LadyRoninEngineer/Si473x/Si4732THT/V2boardHiRes.jpg

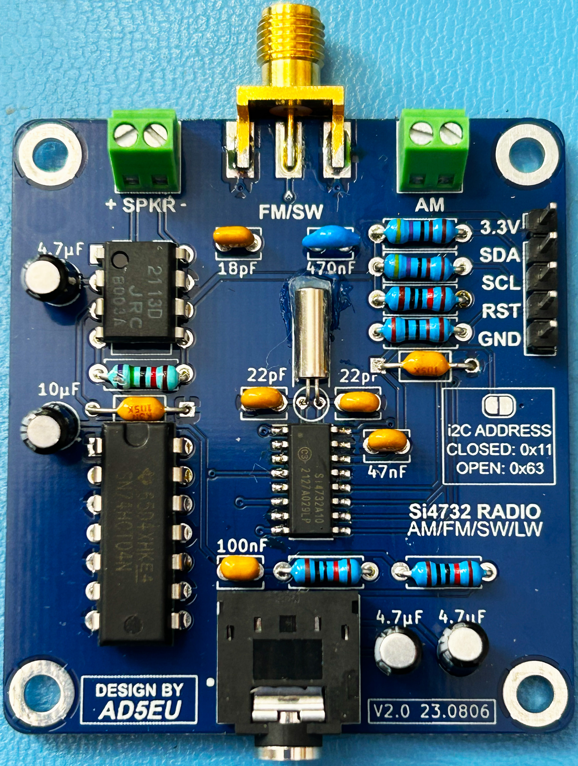
Si4732THT/V2boardHiRes.jpg
