LadyRoninEngineer/Si473x/FrontEnd/Documentation/21.0222_FrontEnd.jpg

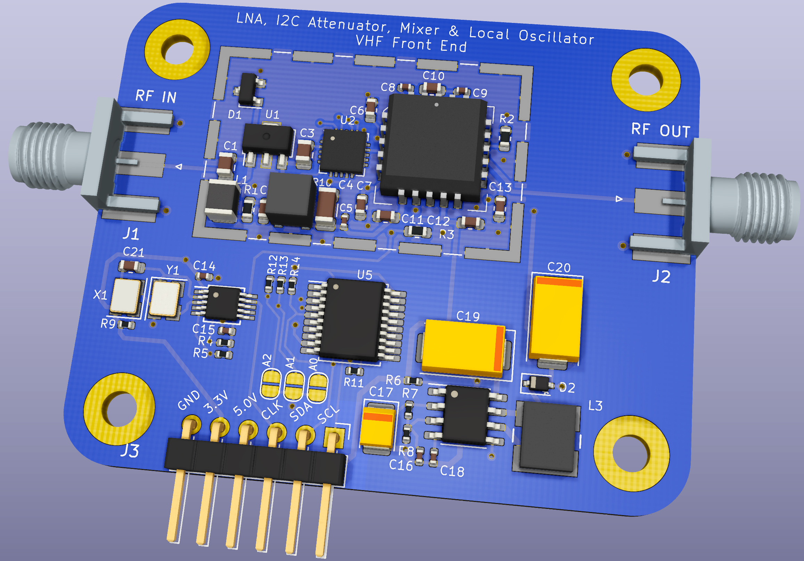
FrontEnd/Documentation/21.0222_FrontEnd.jpg
