LadyRoninEngineer/Si473x/README.md

# Si473x
Data Supporting development of Si473x series radios
