LadyRoninEngineer/Si473x/Si4732THT/README.md

Si4732 Through Hole Technology Radio
Developed By Nancy Gail Daniels - AD5EU
