LadyRoninEngineer/Si473x/FrontEnd/Documentation/21.0222_FrontEnd_S.jpg

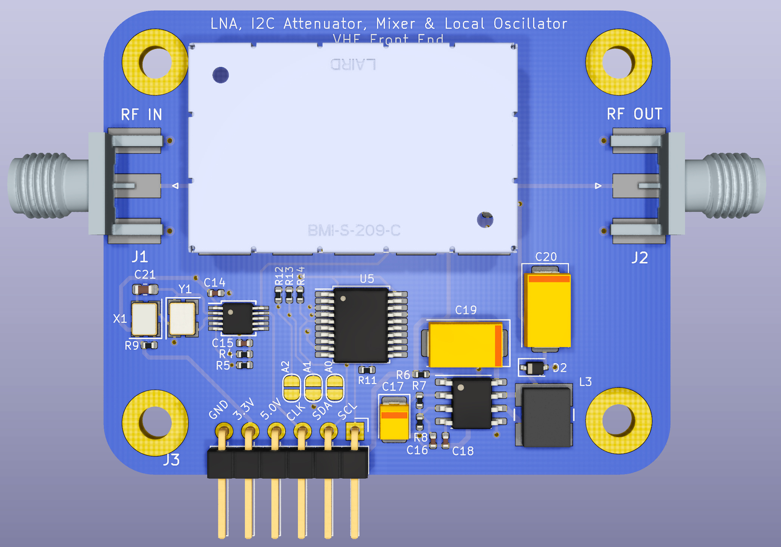
FrontEnd/Documentation/21.0222_FrontEnd_S.jpg
