LadyRoninEngineer/Si473x/FrontEnd/Documentation/21.0223_Image_BD.jpg

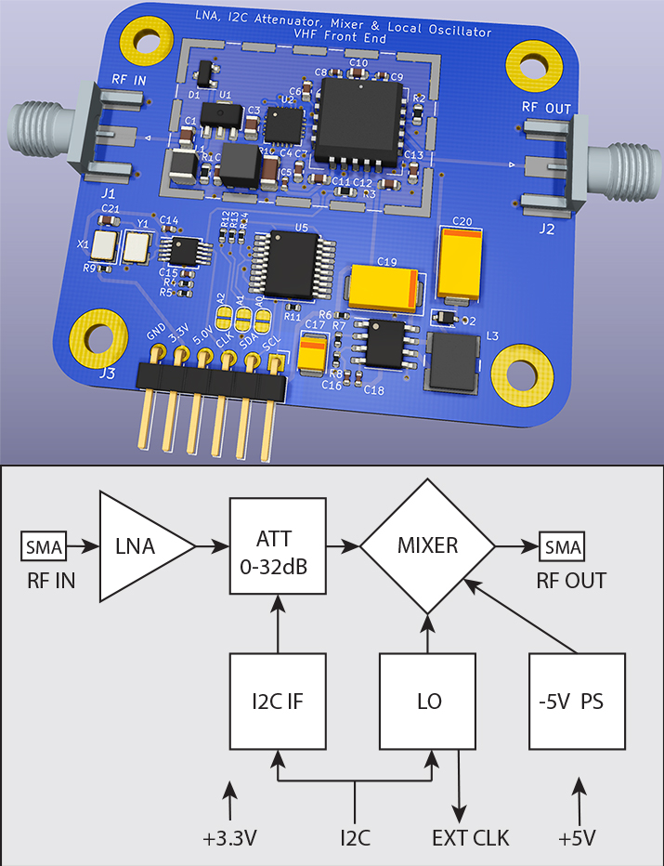
FrontEnd/Documentation/21.0223_Image_BD.jpg
