LadyRoninEngineer/Si473x/MBR_Processor/21.0611_MBP_3DModel.jpg

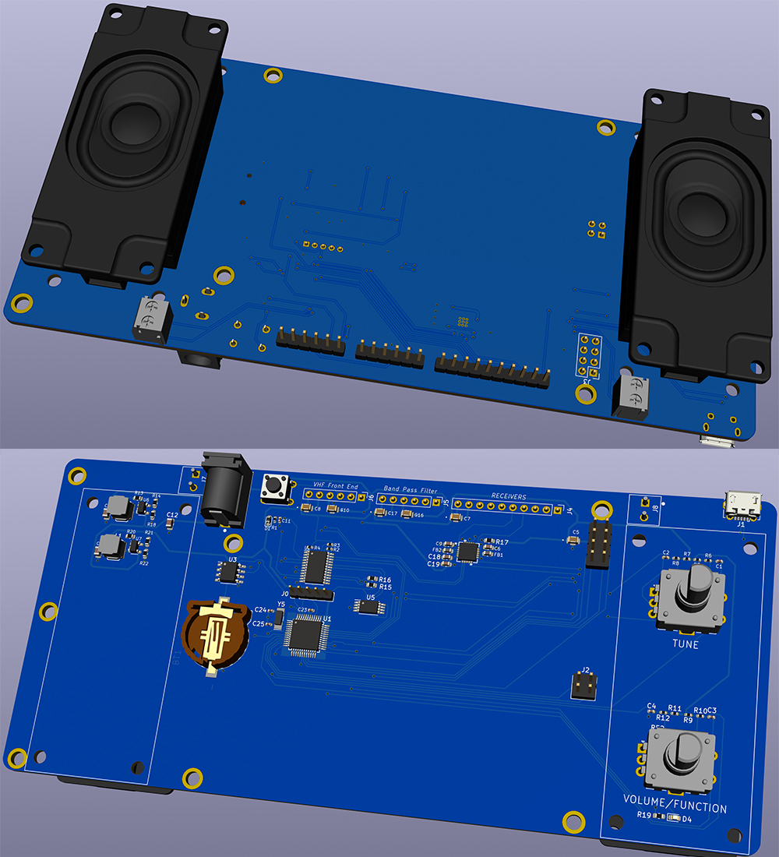
MBR_Processor/21.0611_MBP_3DModel.jpg
