LadyRoninEngineer/Si473x/FrontEnd/Custom Library/3D_MODELS/bmi-s-209-assembly-stp-file.STEP

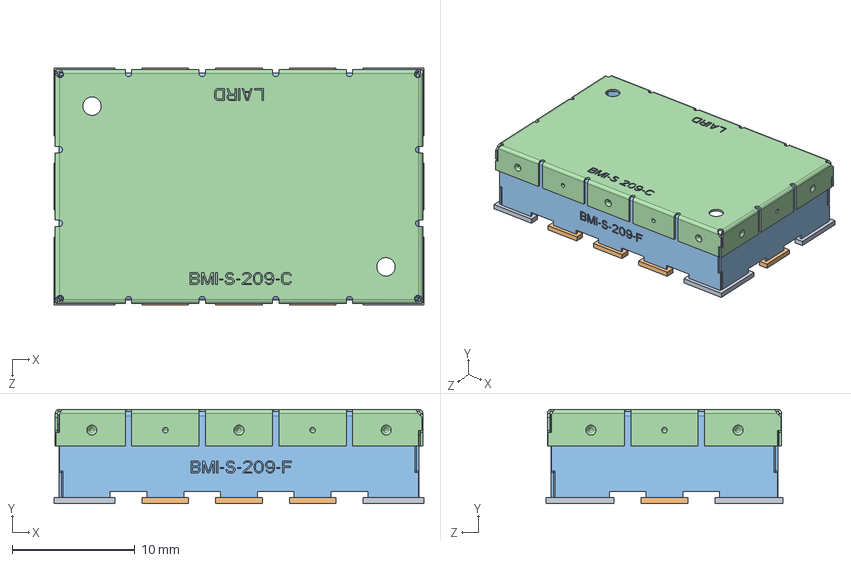
[picture p37: CAD file, 2021-02-23]
FrontEnd/Custom Library/3D_MODELS/bmi-s-209-assembly-stp-file.STEP
30.2 x 7.70 x 19.3 mm
bmi-s-209-footprint
bmi-s-209-f
bmi-s-209-c
