LadyRoninEngineer/Si473x/FrontEnd/Custom Library/AD831APZ/P_20A_ADI.step

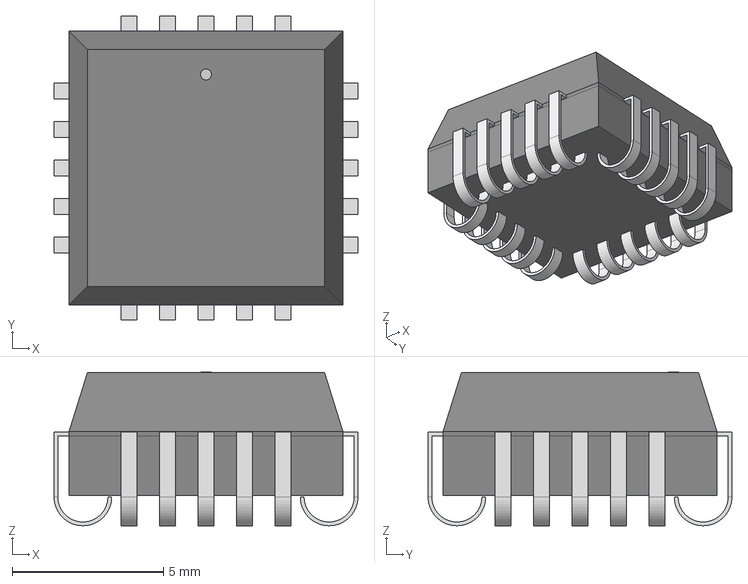
[picture p38: CAD file, 2021-02-23]
FrontEnd/Custom Library/AD831APZ/P_20A_ADI.step
10.0 x 10.0 x 5.07 mm
