LadyRoninEngineer/Si473x/FrontEnd/Custom Library/PE4312CZ/QFN20_4X4_PSM.step

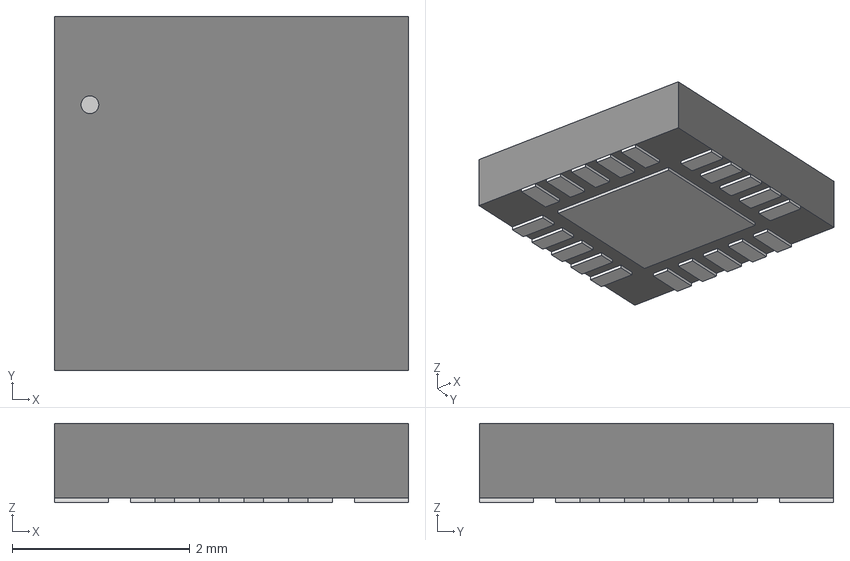
[picture p39: CAD file, 2021-02-23]
FrontEnd/Custom Library/PE4312CZ/QFN20_4X4_PSM.step
3.99 x 3.99 x 0.892 mm
