LadyRoninEngineer/Si473x/FrontEnd/Custom Library/TCCH-80/TCCH-80+.stp

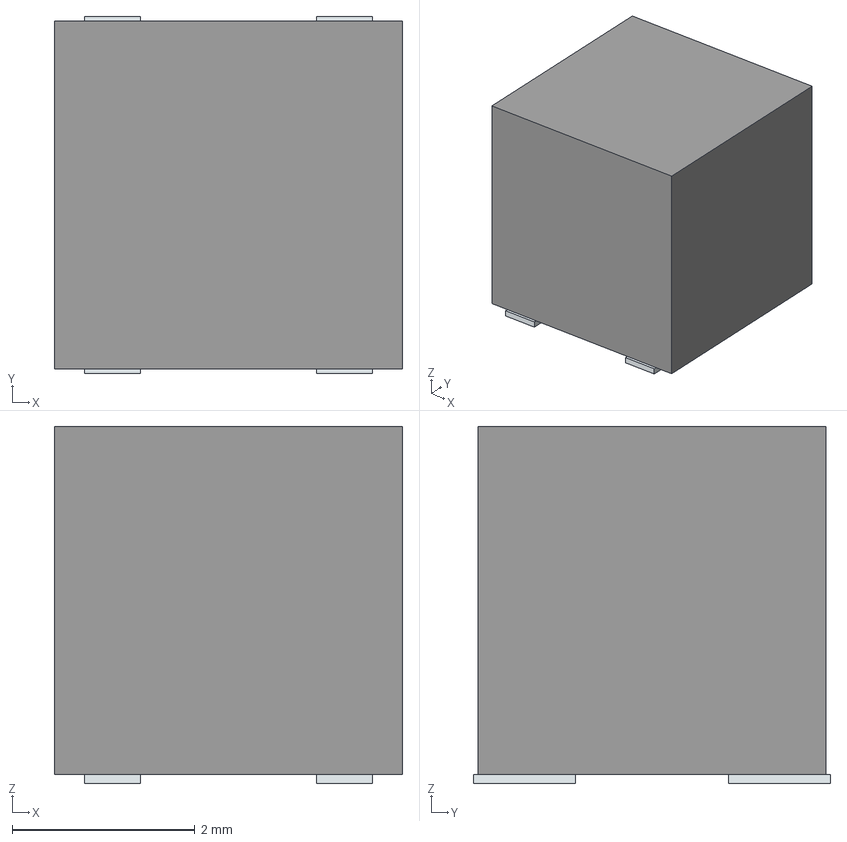
[picture p40: CAD file, 2021-02-23]
FrontEnd/Custom Library/TCCH-80/TCCH-80+.stp
3.81 x 3.91 x 3.91 mm
Pins
