LadyRoninEngineer/Si473x/FrontEnd/Custom Library/TPS6735IDR/TPS6735IDR.step

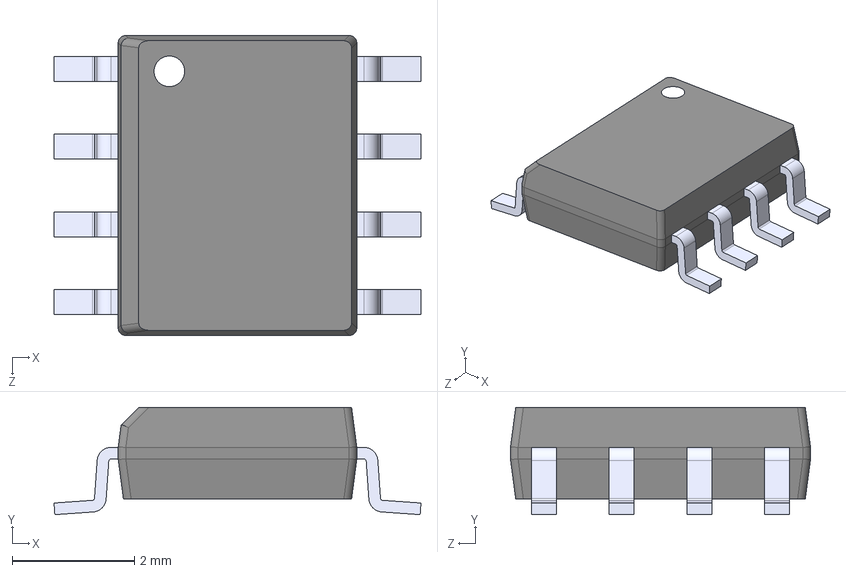
[picture p41: CAD file, 2021-02-23]
FrontEnd/Custom Library/TPS6735IDR/TPS6735IDR.step
5.99 x 1.75 x 4.90 mm
