LadyRoninEngineer/Si473x/FrontEnd/Custom Library/ul_TPS61080DRCTG4/DRC0010J.stp

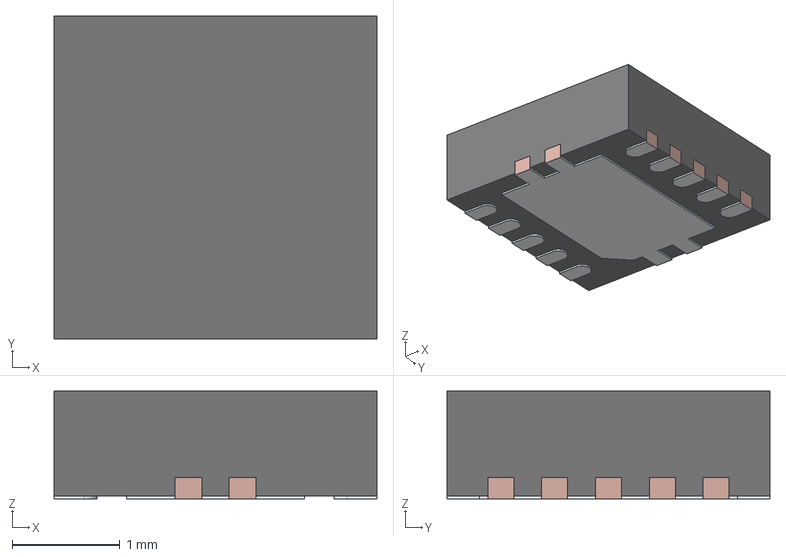
[picture p42: CAD file, 2021-02-23]
FrontEnd/Custom Library/ul_TPS61080DRCTG4/DRC0010J.stp
3.00 x 3.00 x 1.00 mm
BODY-SON
FRAME-DRC0010J
