LadyRoninEngineer/Si473x/RadioSupport/CustomLibrary/CR1220/BR1225A_HBN.step

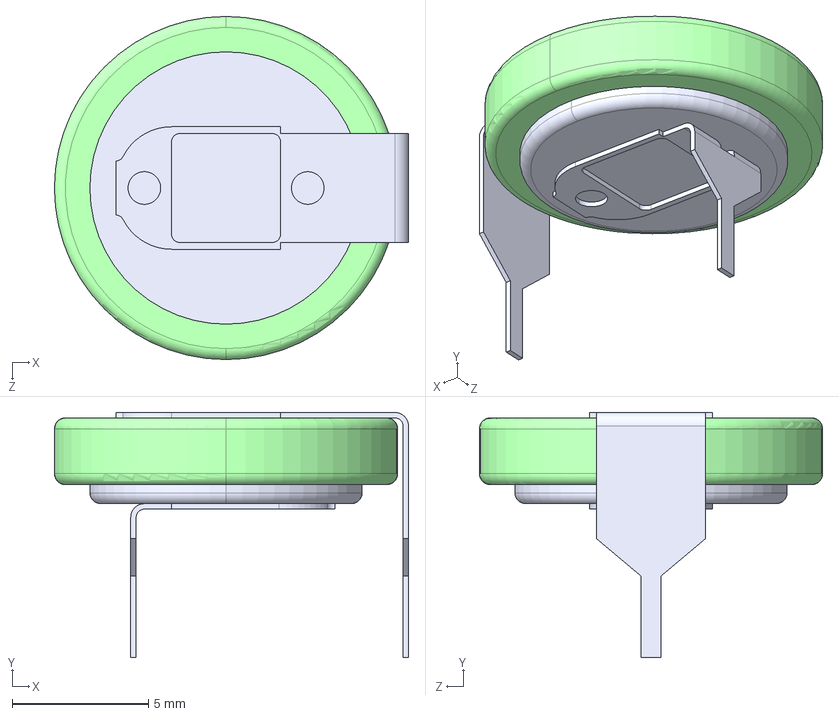
[picture p43: CAD file, 2023-09-14]
RadioSupport/CustomLibrary/CR1220/BR1225A_HBN.step
13.0 x 9.00 x 12.6 mm
