LadyRoninEngineer/Si473x/RadioSupport/CustomLibrary/RT3215/RT3215_RAL.step

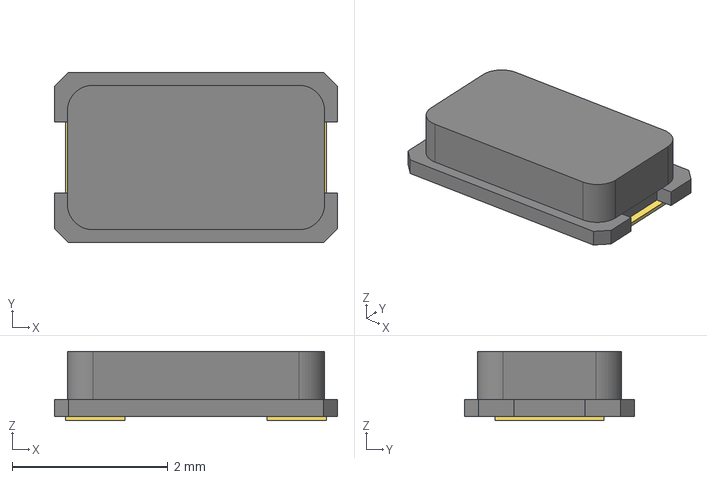
[picture p44: CAD file, 2023-09-14]
RadioSupport/CustomLibrary/RT3215/RT3215_RAL.step
3.63 x 2.18 x 0.889 mm
