LadyRoninEngineer/Si473x/Si4732BO/CustomLibrary/3DModels/B3U-1000P.STEP

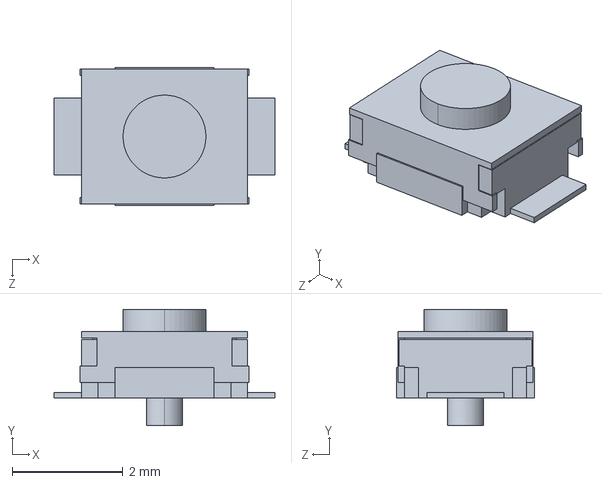
[picture p45: CAD file, 2020-11-09]
Si4732BO/CustomLibrary/3DModels/B3U-1000P.STEP
4.00 x 2.10 x 2.50 mm
