LadyRoninEngineer/Si473x/Si4732THT/KiCAD_Controller/Custom Library/D6R00F1LFS/D6R00F1LFS.stp

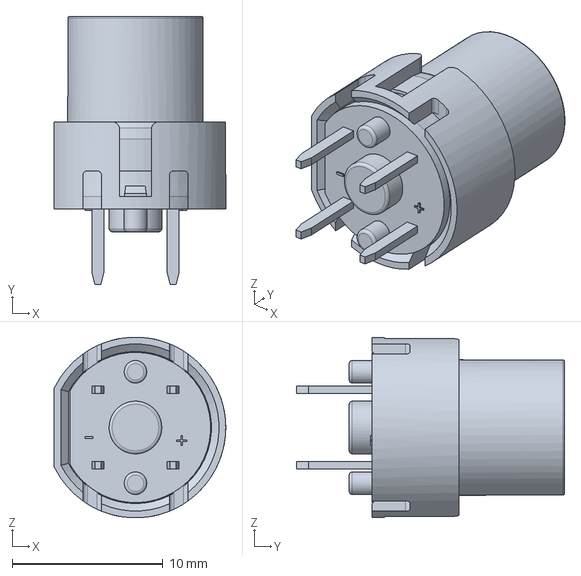
[picture p46: CAD file, 2023-09-04]
Si4732THT/KiCAD_Controller/Custom Library/D6R00F1LFS/D6R00F1LFS.stp
11.4 x 17.8 x 12.0 mm
