LadyRoninEngineer/Si473x/Si4732THT/KiCAD_Controller/Custom Library/Feather/4884 Feather RP2040.stp

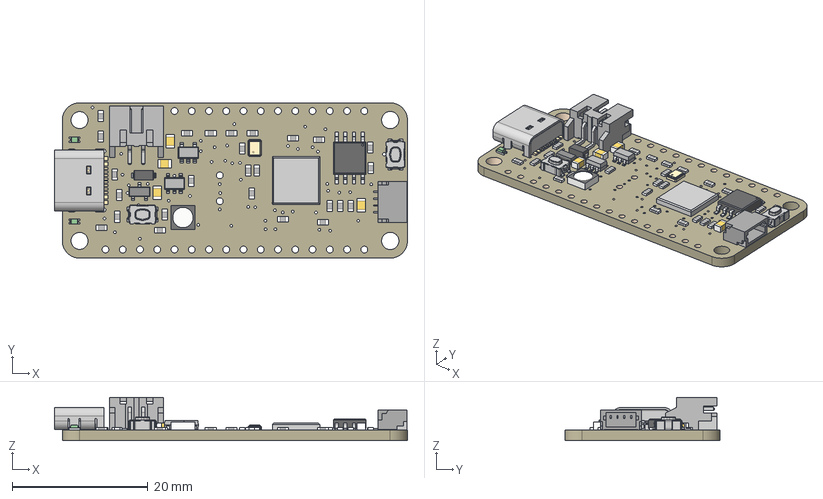
[picture p47: CAD file, 2023-09-04]
Si4732THT/KiCAD_Controller/Custom Library/Feather/4884 Feather RP2040.stp
51.9 x 22.9 x 6.37 mm
Board
10uF x 4
ORANGE x 2
1K x 26
KMR2 x 2
AP2112-3.3
JSTPH
MCP73831T-2ACI/OT
WS2812B3535
2MB Flash
MBR540
DMG341
USB Type C
RP2040_QFN56
STEMMA_I2C_QT
12MHZ
