LadyRoninEngineer/Si473x/Si4732THT/KiCAD_Controller/Custom Library/pec12r-4x20f-sxxxx.stp

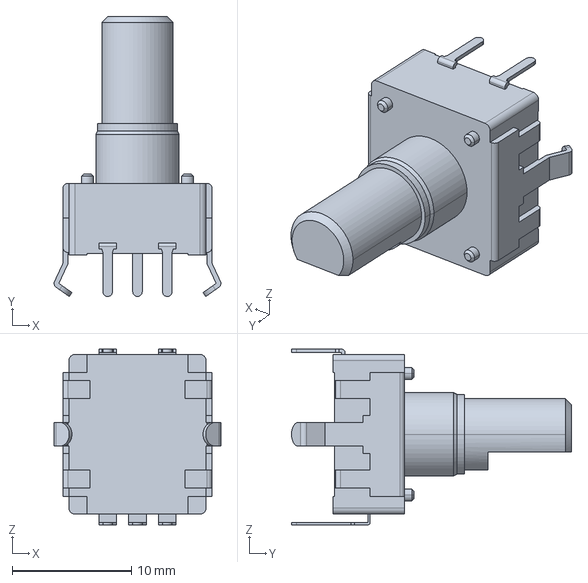
[picture p48: CAD file, 2020-11-09]
Si4732THT/KiCAD_Controller/Custom Library/pec12r-4x20f-sxxxx.stp
14.0 x 23.5 x 14.7 mm
