LadyRoninEngineer/Si473x/Si4732THT/KiCADRadio/CustomLibrary/C410C105K3R5TA/CCA_ACST_C410_D2.41L4.32LL25.4F0.535.step

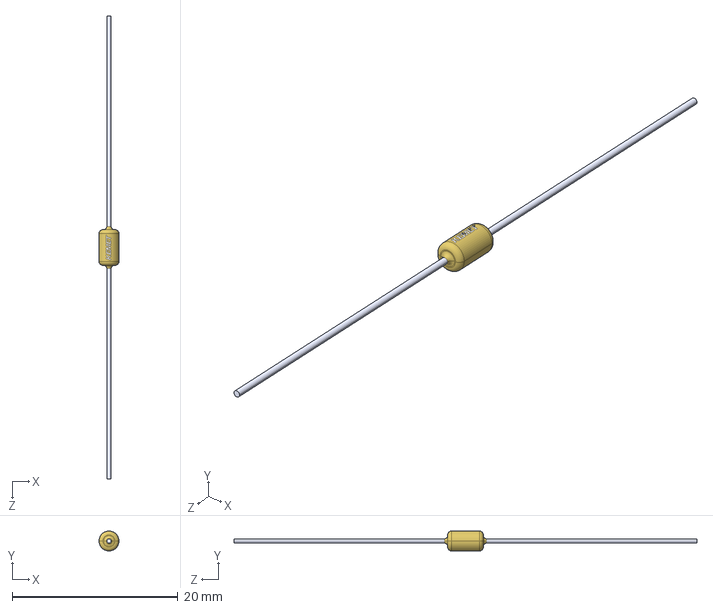
[picture p49: CAD file, 2023-09-02]
Si4732THT/KiCADRadio/CustomLibrary/C410C105K3R5TA/CCA_ACST_C410_D2.41L4.32LL25.4F0.535.step
2.41 x 2.41 x 55.9 mm
