LadyRoninEngineer/Si473x/Si4732THT/KiCADRadio/CustomLibrary/ECEA1EKS4R7I/ECEA1EKS4R7I.step

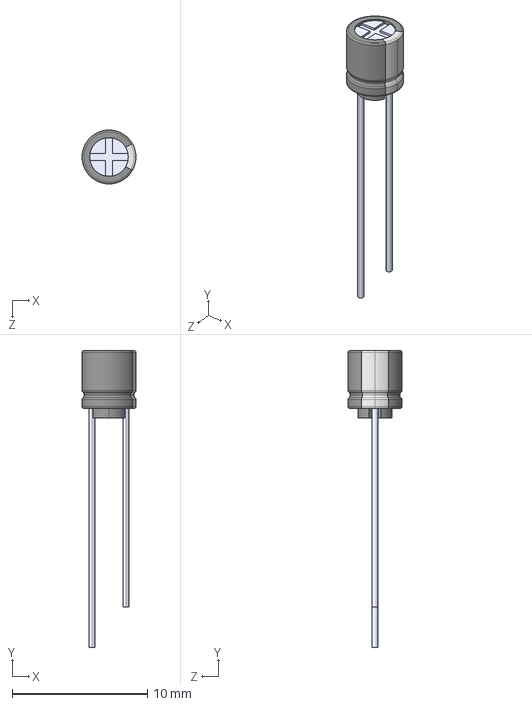
[picture p50: CAD file, 2023-09-02]
Si4732THT/KiCADRadio/CustomLibrary/ECEA1EKS4R7I/ECEA1EKS4R7I.step
4.00 x 22.0 x 4.00 mm
