LadyRoninEngineer/Si473x/Si4732THT/KiCADRadio/CustomLibrary/ECS27/ECS-.327-12.5-8X-C.step

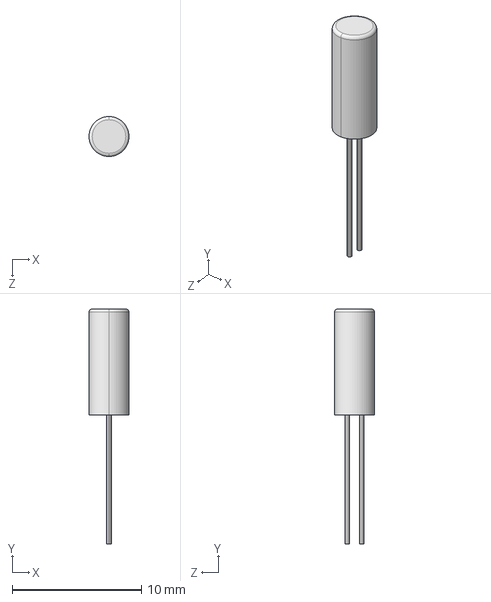
[picture p51: CAD file, 2023-07-07]
Si4732THT/KiCADRadio/CustomLibrary/ECS27/ECS-.327-12.5-8X-C.step
3.10 x 18.2 x 3.10 mm
