LadyRoninEngineer/Si473x/Si4732THT/KiCADRadio/CustomLibrary/FG18X7R1E105KRT06.step

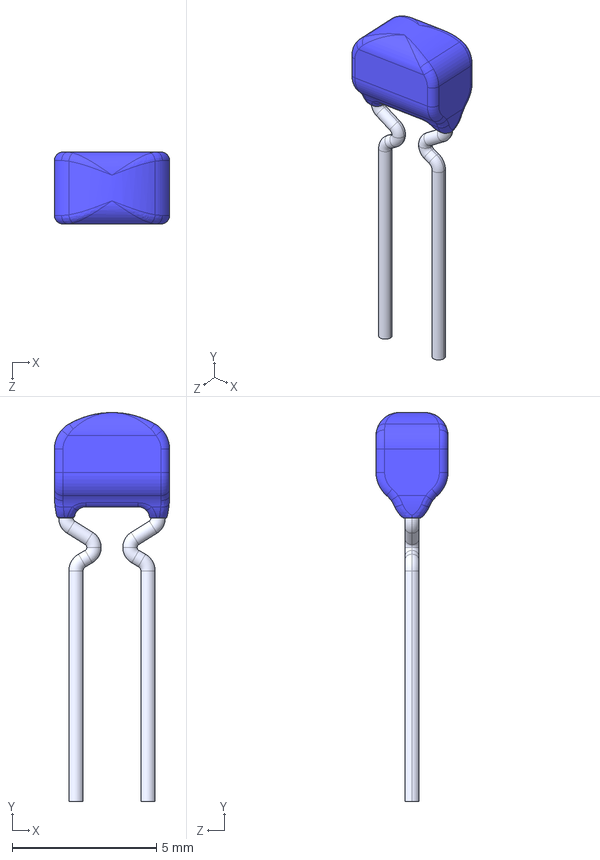
[picture p52: CAD file, 2023-09-02]
Si4732THT/KiCADRadio/CustomLibrary/FG18X7R1E105KRT06.step
4.00 x 13.5 x 2.50 mm
