LadyRoninEngineer/Si473x/Si4732THT/KiCADRadio/CustomLibrary/SJ1-3525N/SJ1-3525N.step

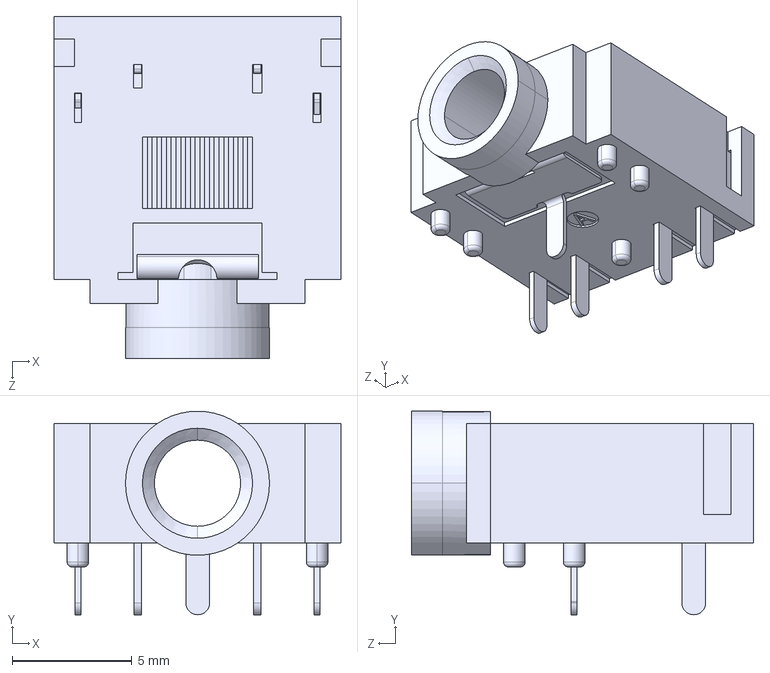
[picture p53: CAD file, 2023-07-07]
Si4732THT/KiCADRadio/CustomLibrary/SJ1-3525N/SJ1-3525N.step
12.0 x 8.51 x 14.3 mm
