LadyRoninEngineer/Si473x/FrontEnd/Custom Library/3D_MODELS/User Library-NBB-310.step

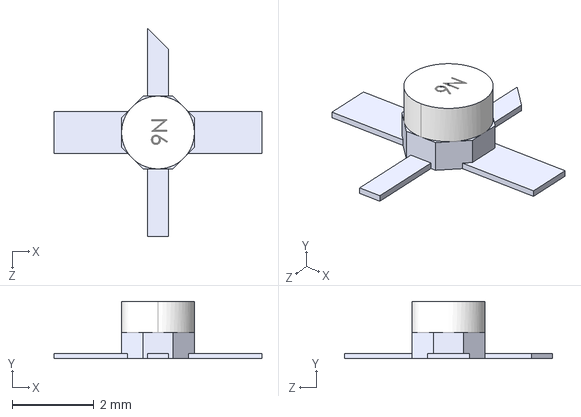
[picture p54: CAD file, 2021-02-23]
FrontEnd/Custom Library/3D_MODELS/User Library-NBB-310.step
5.08 x 1.40 x 5.08 mm
