LadyRoninEngineer/Si473x/Si4732BO/CustomLibrary/3DModels/SM04B-SRSS-TB(LF)(SN)--3DModel-STEP-56544.STEP

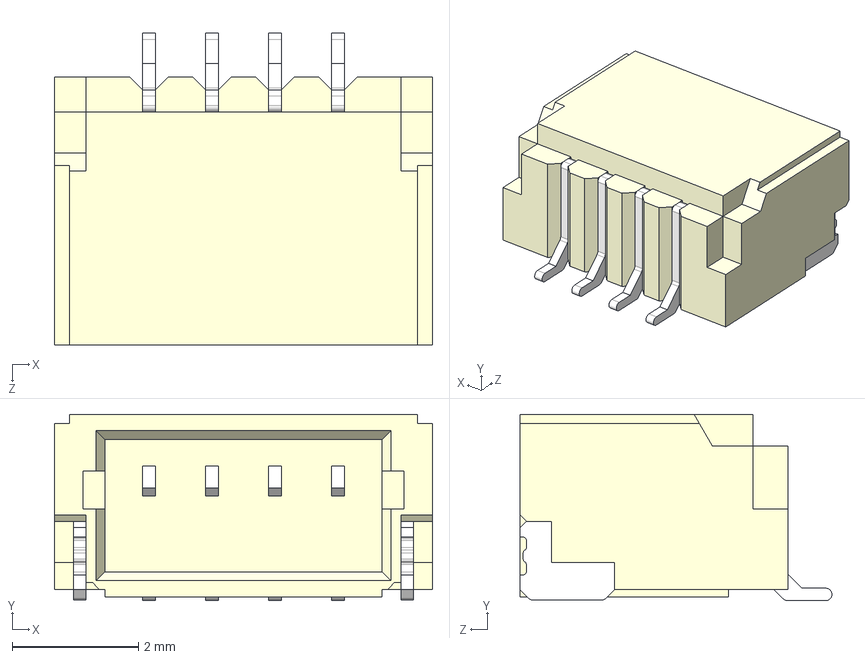
[picture p55: CAD file, 2020-11-09]
Si4732BO/CustomLibrary/3DModels/SM04B-SRSS-TB(LF)(SN)--3DModel-STEP-56544.STEP
6.00 x 2.96 x 4.95 mm
