LadyRoninEngineer/Si473x/FrontEnd/Custom Library/3D_MODELS/AIML-1008HC-1R0M-T.STEP

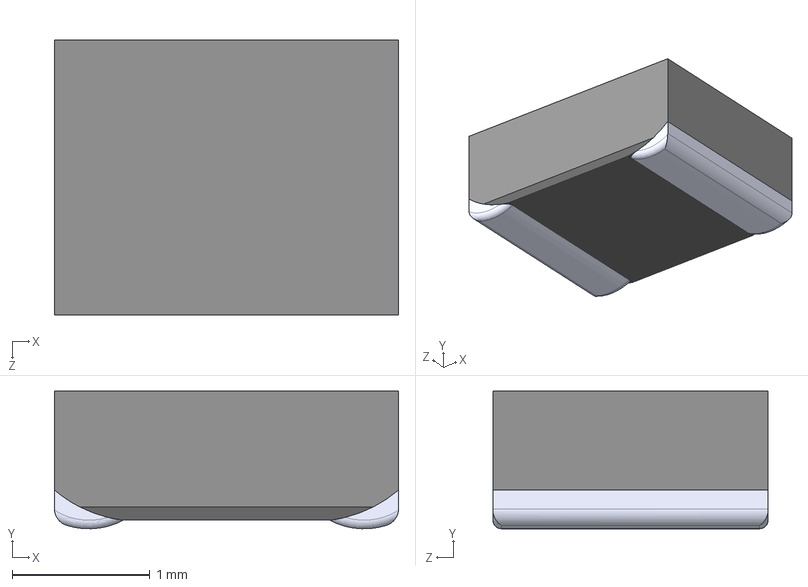
[picture p56: CAD file, 2021-02-23]
FrontEnd/Custom Library/3D_MODELS/AIML-1008HC-1R0M-T.STEP
2.50 x 1 x 2.00 mm
