LadyRoninEngineer/Si473x/Si4732BO/CustomLibrary/3DModels/CUI_DEVICES_SJ1-3513-SMT-TR.step

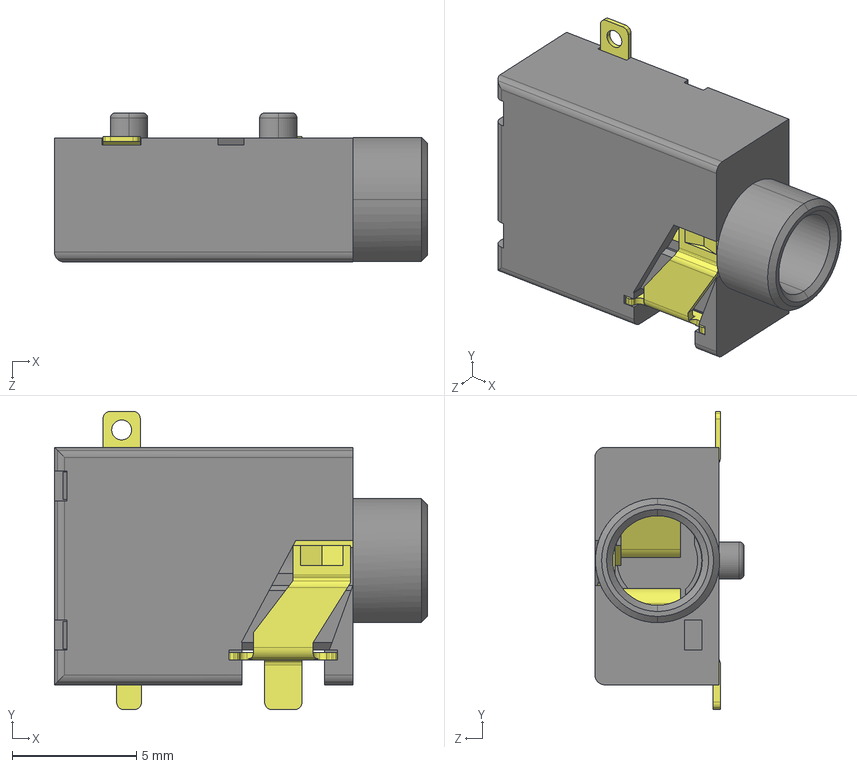
[picture p57: CAD file, 2020-11-09]
Si4732BO/CustomLibrary/3DModels/CUI_DEVICES_SJ1-3513-SMT-TR.step
15.0 x 12.0 x 6.00 mm
