LadyRoninEngineer/Si473x/FrontEnd/Custom Library/3D_MODELS/142-0701-851SMA.stp

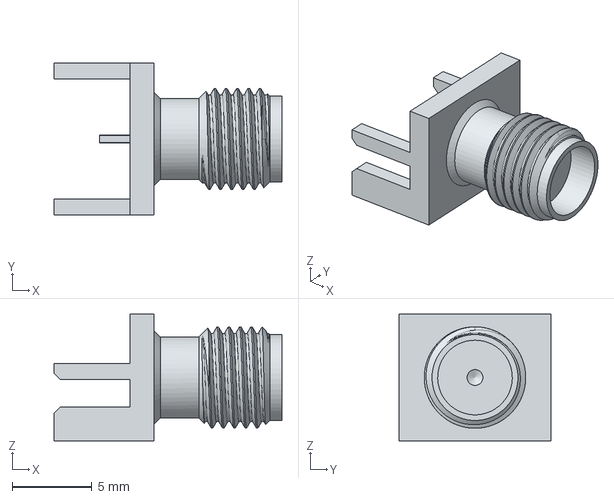
[picture p58: CAD file, 2020-11-09]
FrontEnd/Custom Library/3D_MODELS/142-0701-851SMA.stp
14.3 x 9.53 x 7.92 mm
