LadyRoninEngineer/Si473x/Si4732BO/CustomLibrary/3DModels/S2B-PH-SM4-TB(LF)(SN)--3DModel-STEP-56544.STEP

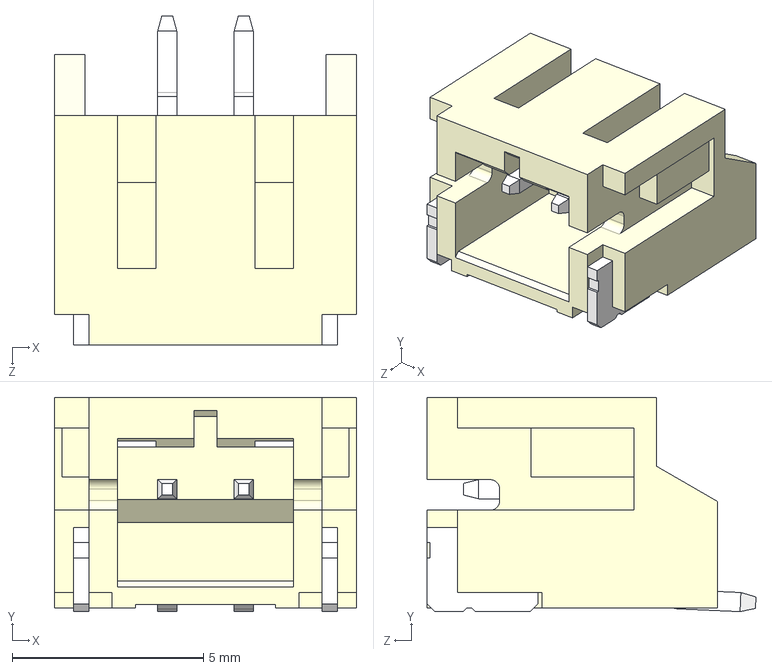
[picture p59: CAD file, 2020-11-09]
Si4732BO/CustomLibrary/3DModels/S2B-PH-SM4-TB(LF)(SN)--3DModel-STEP-56544.STEP
7.90 x 5.60 x 8.60 mm
