LadyRoninEngineer/Si473x/(list of files, cad)

Other CAD files:
Si4732THT/KiCADRadio/CustomLibrary/732511150.stp
Si4732THT/KiCADRadio/CustomLibrary/Phoenix_2x1/1725656.stp
