LadyRoninEngineer/Si473x/(threads)

Thread 1 (2023-03-15):

T1 Data

Rubines, 2023-03-15:
Hi

I want to build your MULTI-BAND RADIO WITH FILTER, thank you for sharing but I found no data for the T1 Balun.
How many turns are needed ?

Cheers
Michael

LadyRoninEngineer, 2023-03-15:
Michael -
Apologies that I committed that info:

Core: BN43-2402 binocular core
4 turns of triflar 30AWG enameled wire (three (3) lengths ~7"/18cm)
2 pairs of wire are the primary
1 wire is the secondary

Obvious perhaps, but it is important to keep track of the wires - a set of Sharpie marks will assist on either end of the wire.

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

Closed 2023-03-15.
