LadyRoninEngineer/Si473x/QFN_FEATHER/23.0120_Schematic.pdf

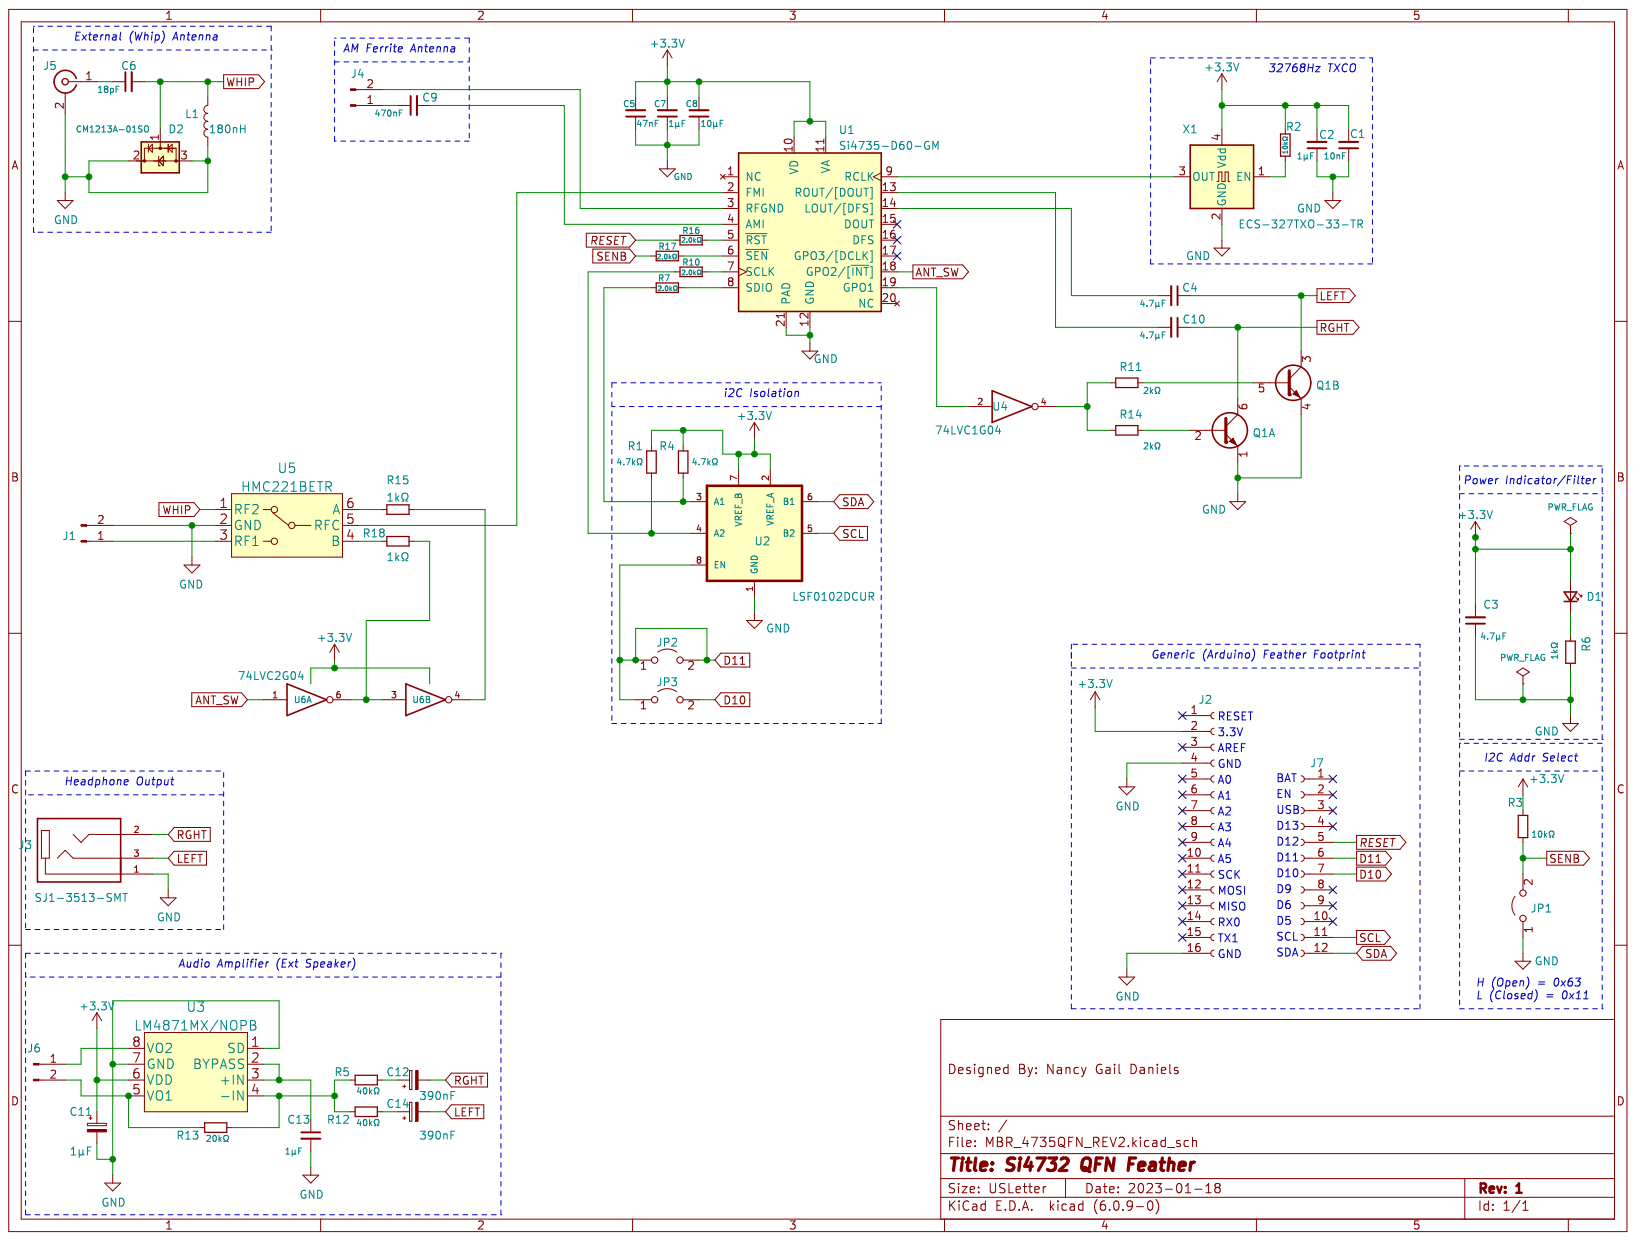
[picture p60: page 1]
