LadyRoninEngineer/Si473x/MBR_Processor/21.0611_Schematic_MPB.pdf

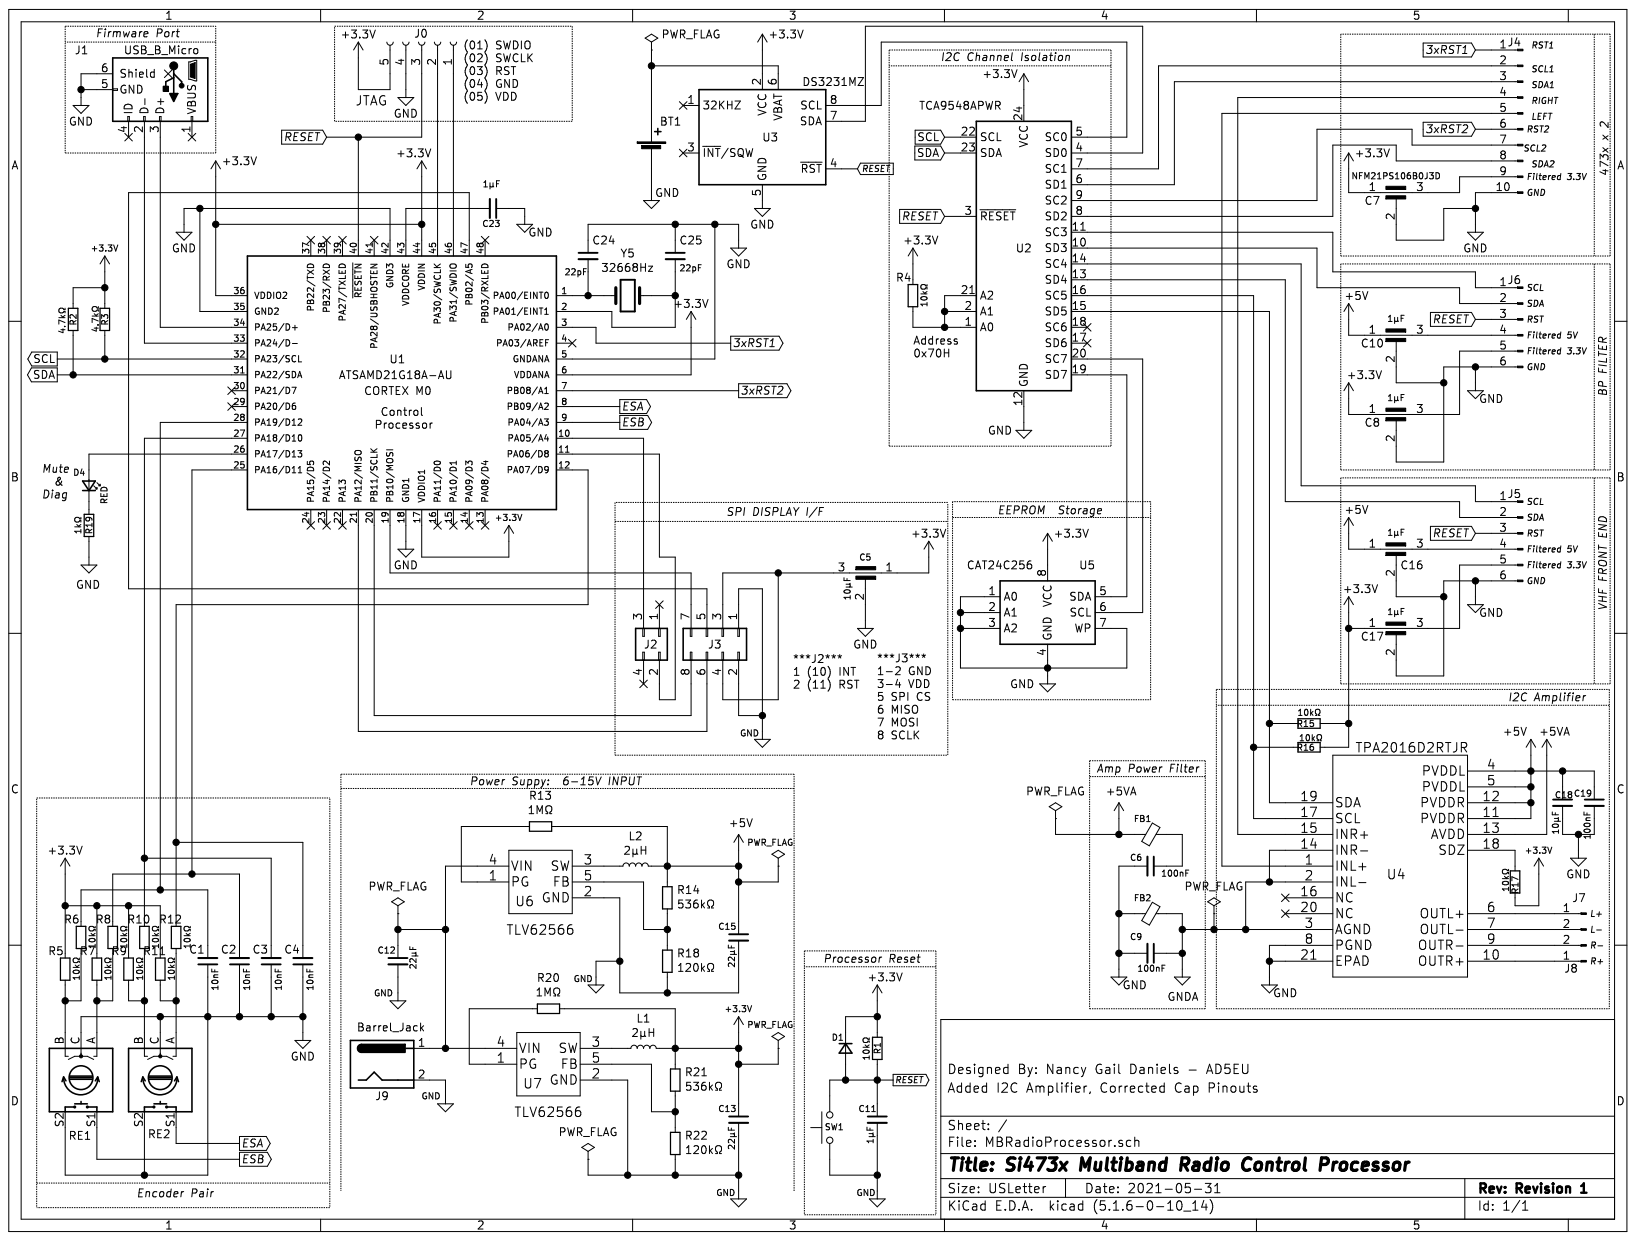
[picture p61: page 1]
