LadyRoninEngineer/Si473x/Breakout_V3/21.0501_Schematic.pdf

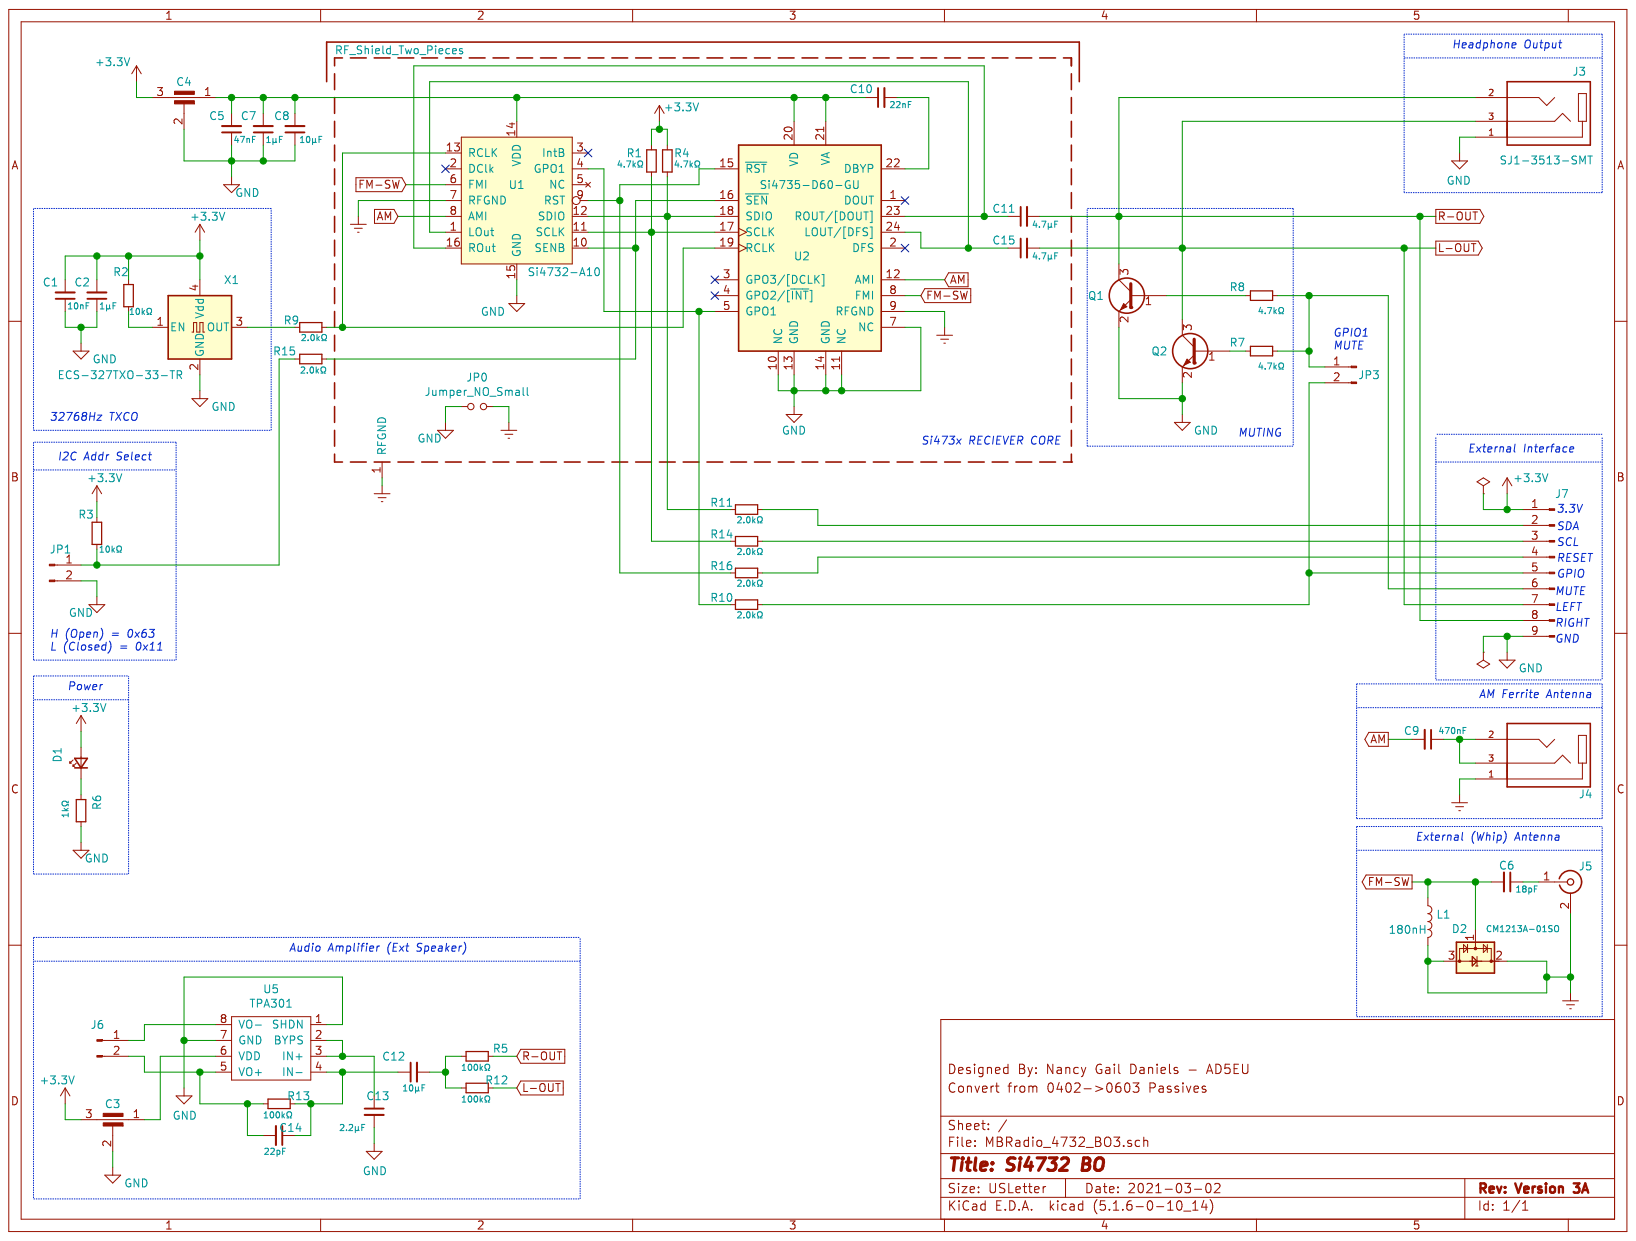
[picture p62: page 1]
