LadyRoninEngineer/Si473x/22.0208_MBR.pdf

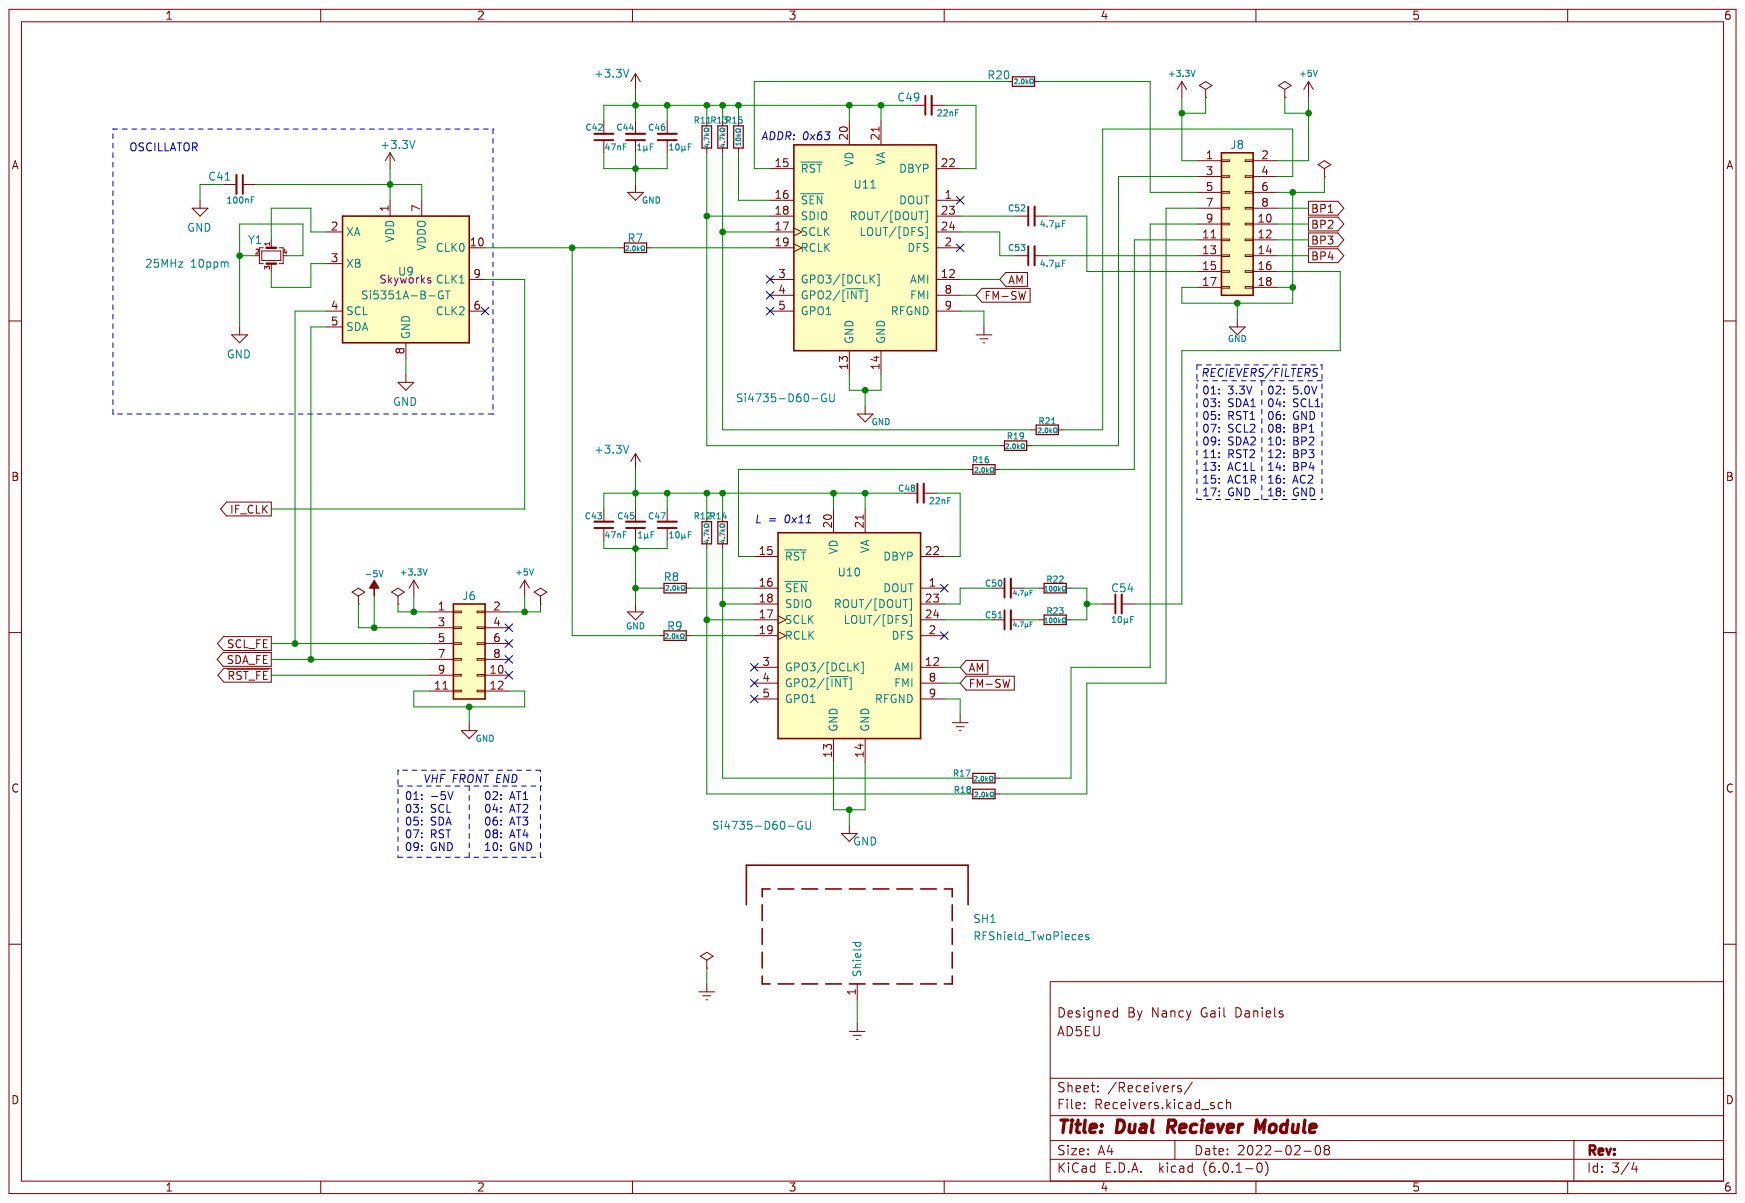
[picture p63: page 1]

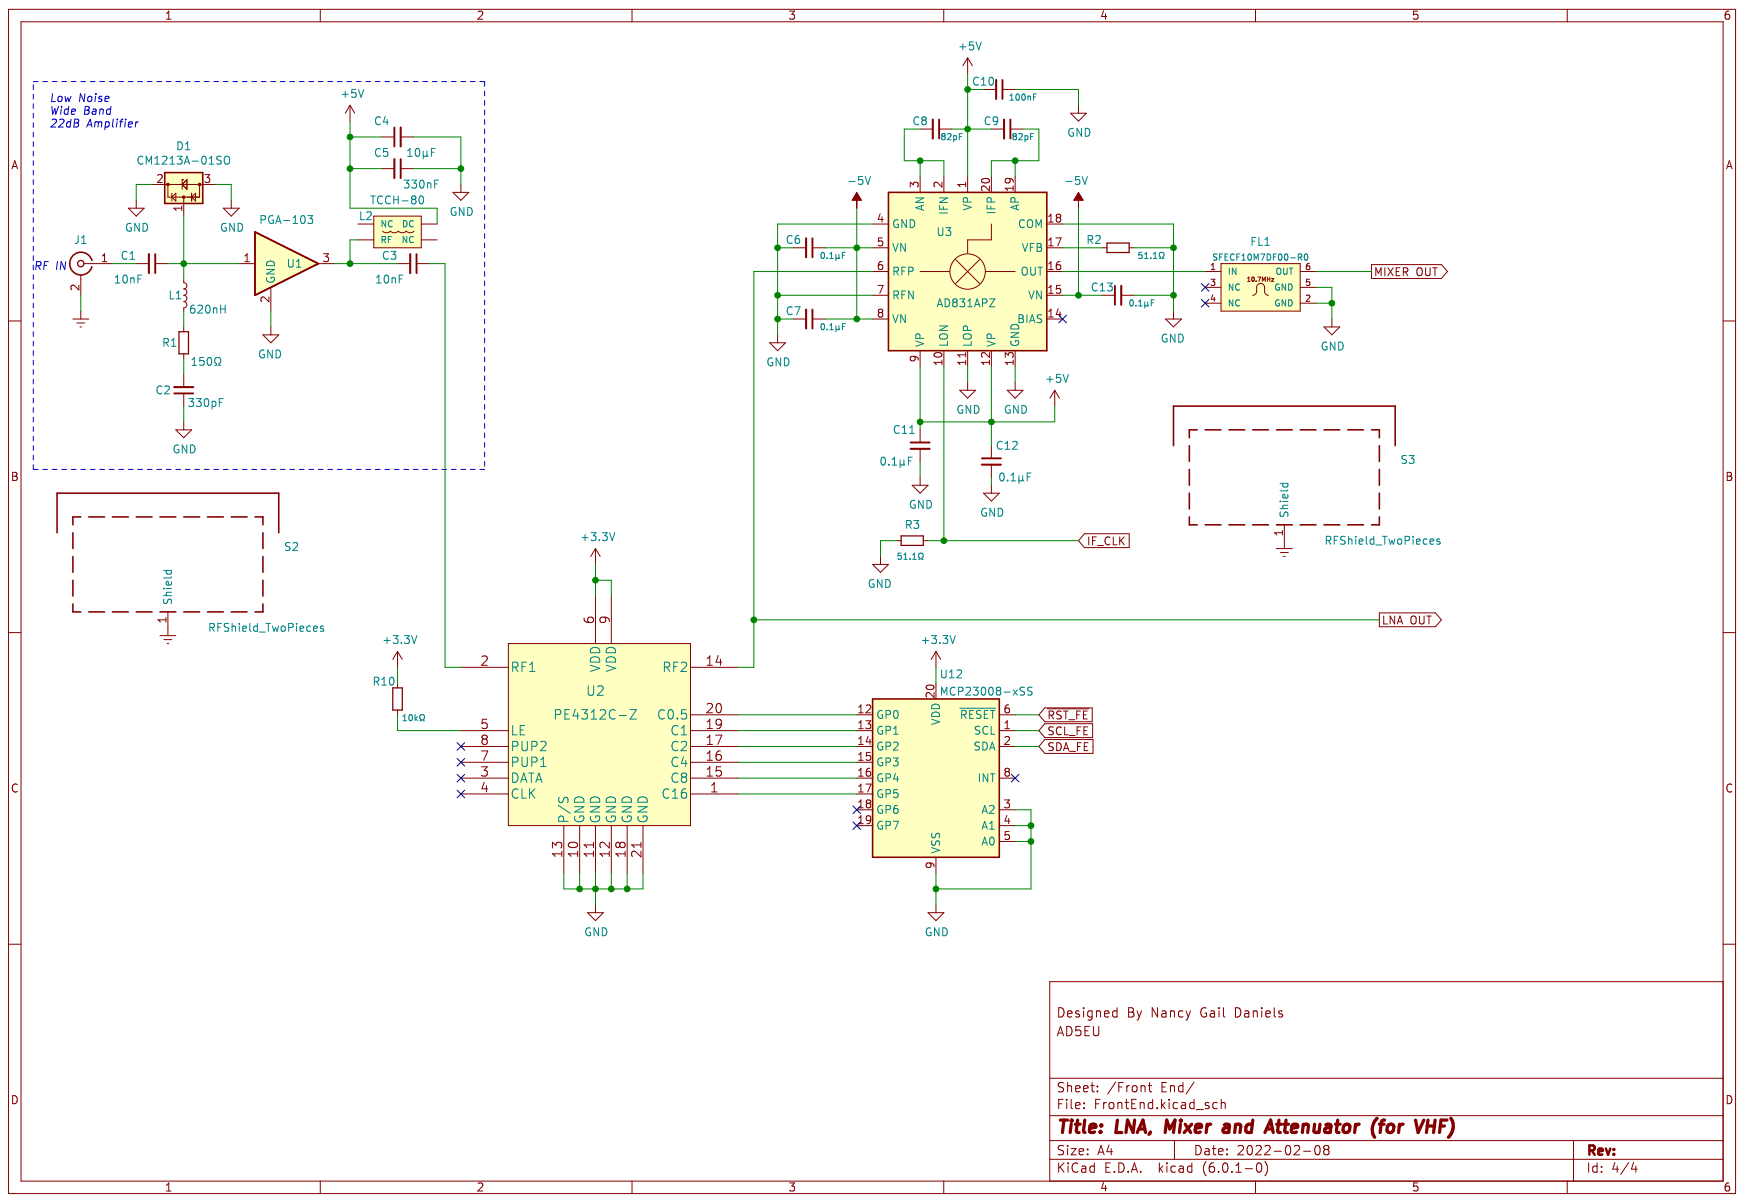
[picture p64: page 2]

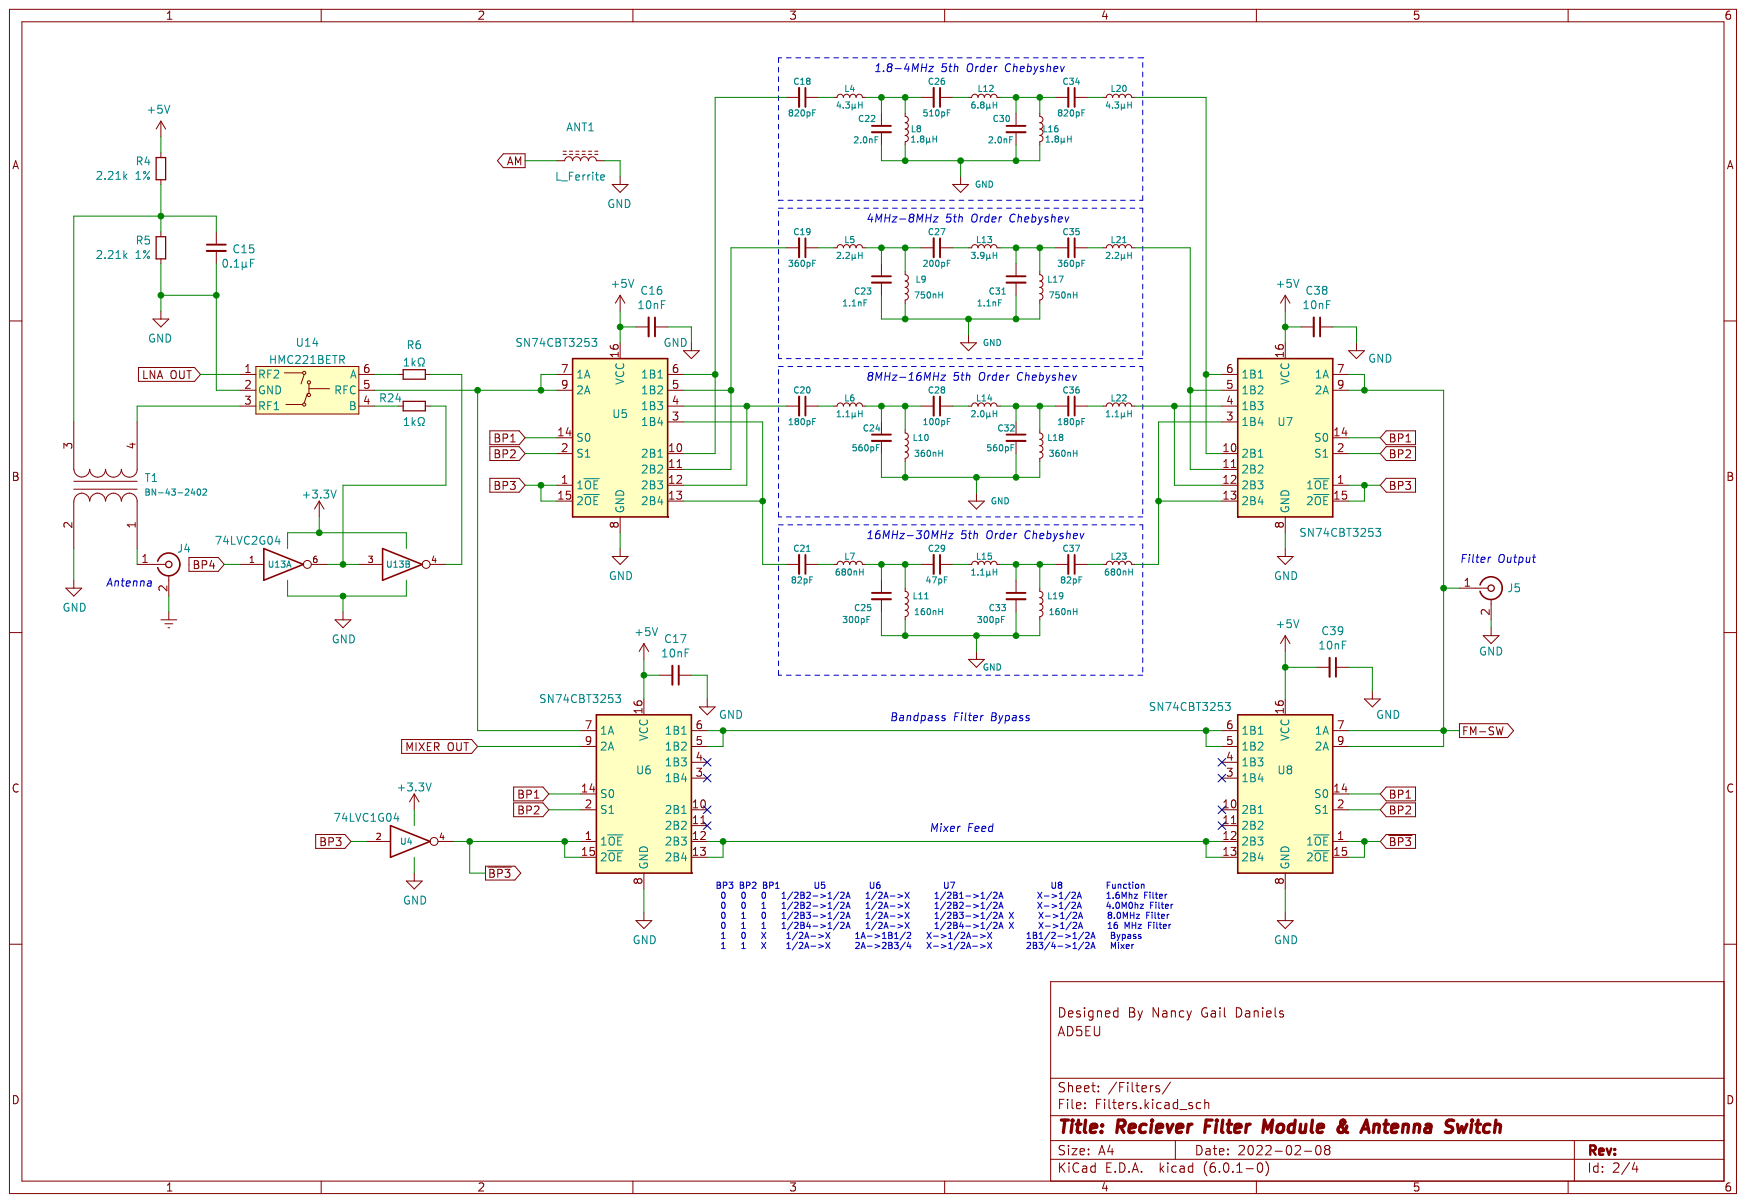
[picture p65: page 3]
