LadyRoninEngineer/Si473x/Si4732BO/4732_BO.pdf

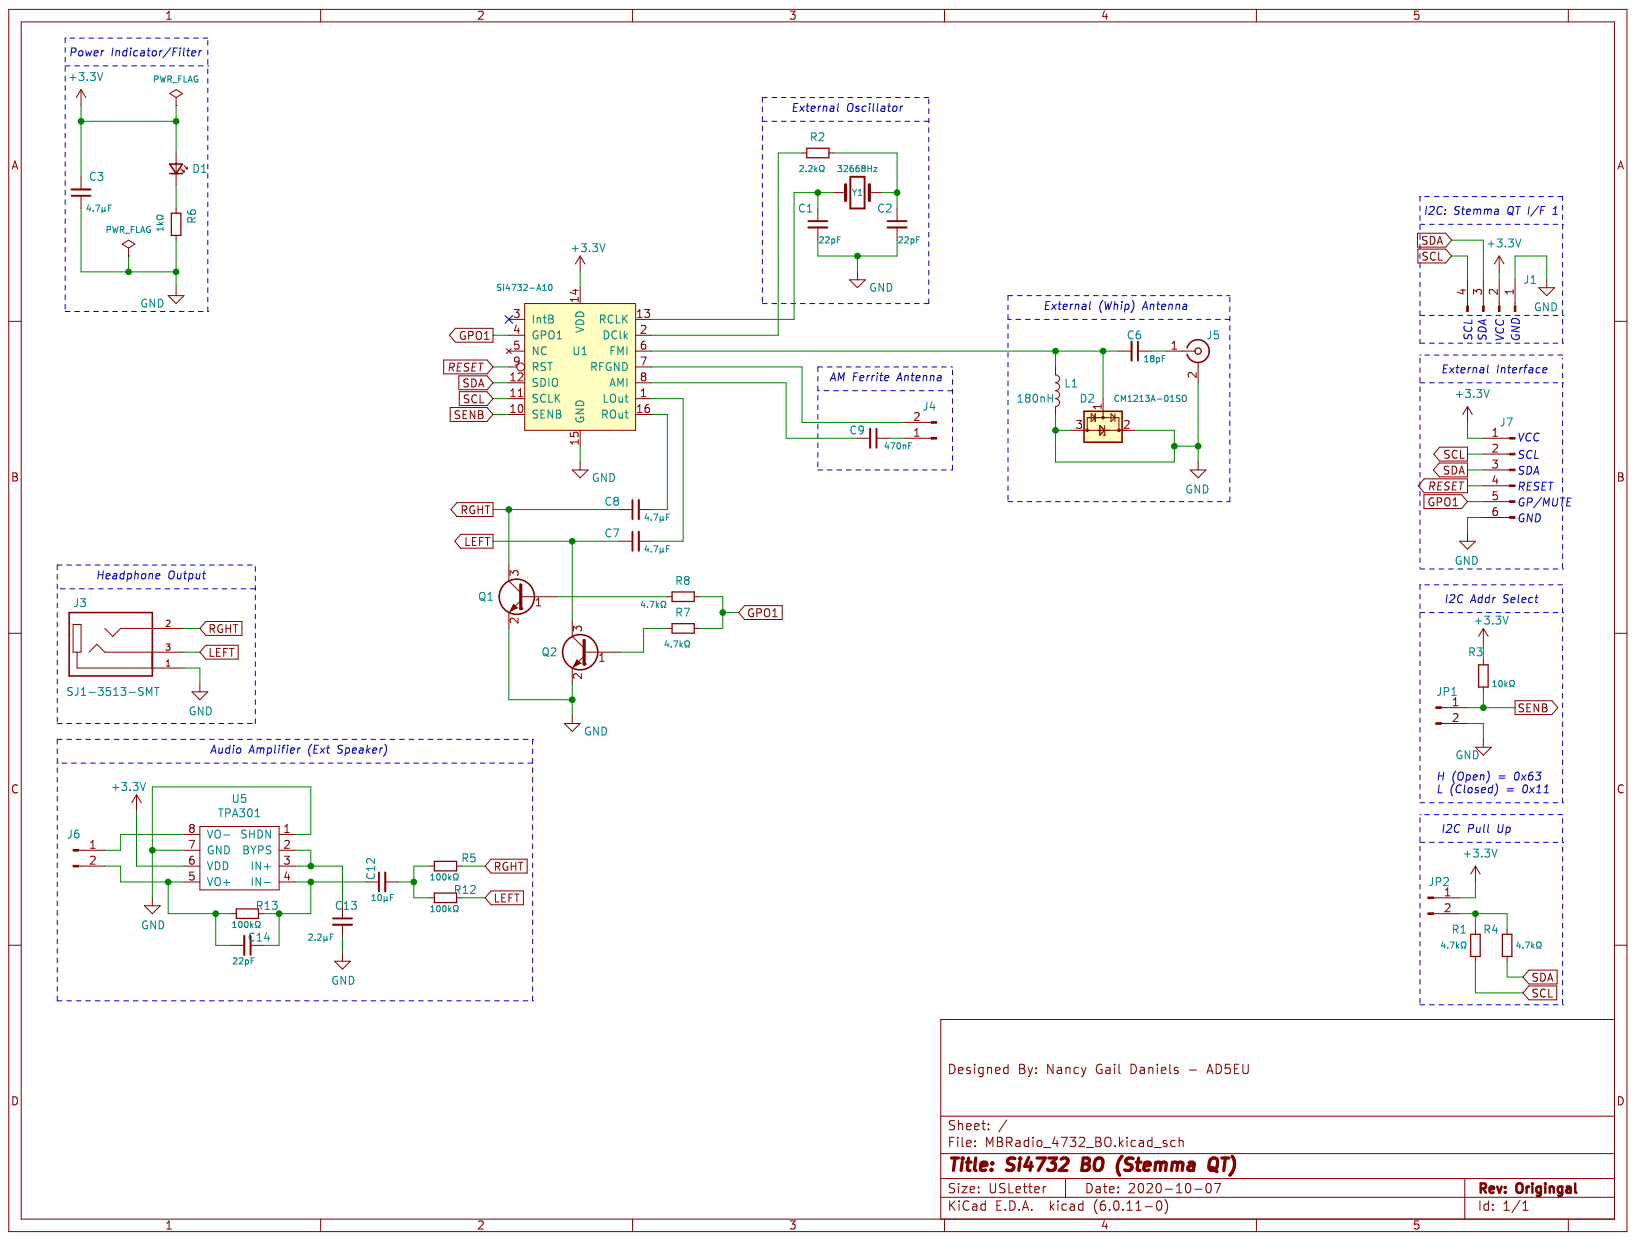
[picture p66: page 1]
