LadyRoninEngineer/Si473x/RadioSupport/RadioSupport.kicad_pcb

## KiCad design RadioSupport/RadioSupport.kicad_pcb (2023-09-14)

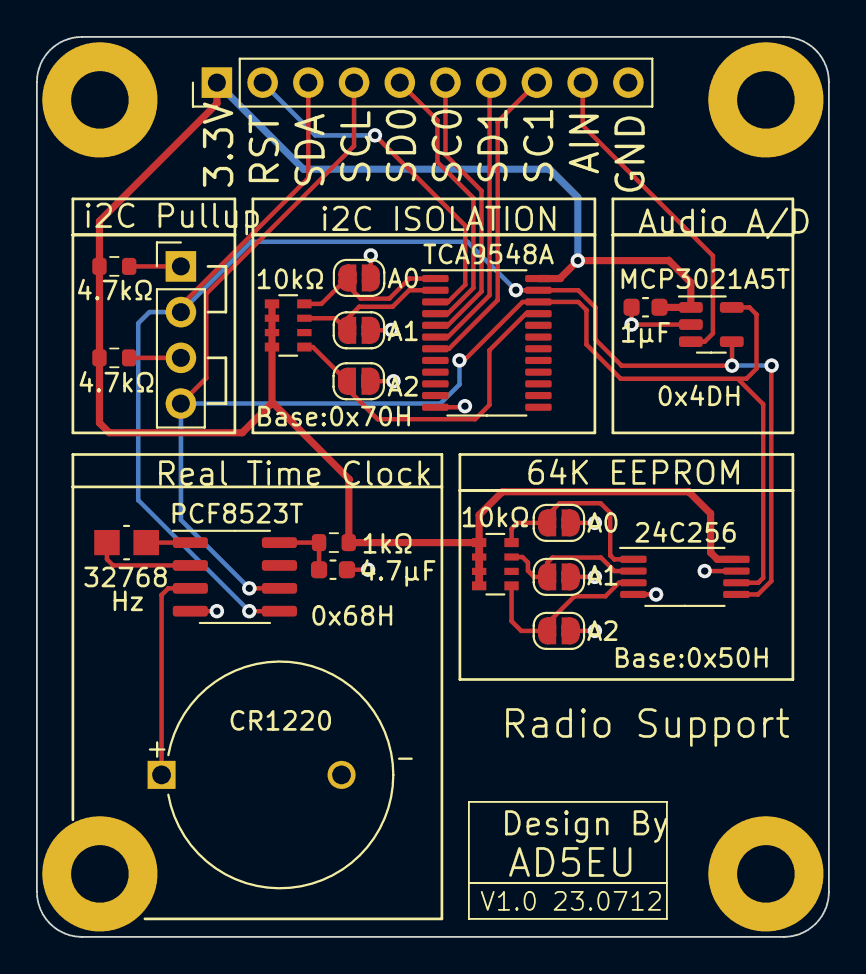
[picture p67: board RadioSupport.kicad_pcb from above]

Board: 2 copper layers, 44.0 x 50.0 mm, 21 parts (0 on the bottom side), 22 nets.

Parts:
BT2: CR1220; BAT_BR1225A_HBN
C1: 4.7µF; C_0603_1608Metric
C2: 1µF; C_0603_1608Metric
J1: Conn_01x10_Pin; PinHeader_1x10_P2.54mm_Vertical
J2: Conn_01x04_Pin; PinHeader_1x04_P2.54mm_Vertical
JP1, JP2, JP3, JP4, JP5, JP6: Jumper_2_Bridged; SolderJumper-2_P1.3mm_Open_RoundedPad1.0x1.5mm
R1, R2: 4.7kΩ; R_0603_1608Metric
R3: 1kΩ; R_0603_1608Metric
RN1, RN2: 10kΩ; R_Array_Convex_4x0603
U1: TCA9548A; TSSOP-24_4.4x7.8mm_P0.65mm
U2: PCF8523T; SOIC-8_3.9x4.9mm_P1.27mm
U4: MCP3021A5T; SOT-23-5
U5: 24C256; TSSOP-8_4.4x3mm_P0.65mm
Y1: 32768; RT3215-32.768-12.5-TR

Connections:
+3.3V: C2.2, J1.1, R1.2, R2.2, R3.2, RN1.1 (R1.1), RN1.2 (R2.1), RN1.3 (R3.1), RN1.4 (R4.1), RN2.1 (R1.1), RN2.2 (R2.1), RN2.3 (R3.1), RN2.4 (R4.1), U1.24 (VCC), U4.1 (VDD), U5.8 (VCC)
AUDIO: J1.9, U4.3 (AIN)
GND: BT2.2 (-), C1.2, C2.1, J1.10, JP1.2 (B), JP2.2 (B), JP3.2 (B), JP4.2 (B), JP5.2 (B), JP6.2 (B), U1.12 (GND), U2.4 (VSS), U4.2 (VSS), U5.4 (GND), U5.7 (WP)
unnamed: BT2.1 (+), U2.3 (VBAT)
unnamed: J2.1, R2.1
unnamed: J2.3, R1.1
unnamed: JP1.1 (A), RN1.8 (R1.2), U1.1 (A0)
unnamed: JP2.1 (A), RN1.7 (R2.2), U1.2 (A1)
unnamed: JP3.1 (A), RN1.5 (R4.2), U1.21 (A2)
unnamed: JP4.1 (A), RN2.5 (R4.2), U5.3 (A2)
unnamed: JP5.1 (A), RN2.7 (R2.2), U5.2 (A1)
unnamed: JP6.1 (A), RN2.8 (R1.2), U5.1 (A0)
unnamed: U2.1 (OSCI), Y1.1
unnamed: U2.2 (OSCO), Y1.2
unnamed: C1.1, R3.1, U2.8 (VDD)
SCL: J1.4, J2.4, U1.22 (SCL), U2.6 (SCL), U4.5 (SCL), U5.6 (SCL)
SCL0: J1.6, U1.5 (SC0)
SCL1: J1.8, U1.7 (SC1)
SDA: J1.3, J2.2, U1.23 (SDA), U2.5 (SDA), U4.4 (SDA), U5.5 (SDA)
SDA0: J1.5, U1.4 (SD0)
SDA1: J1.7, U1.6 (SD1)
~RST: J1.2, U1.3 (~RESET)
