LadyRoninEngineer/Si473x/Si4732THT/KiCAD_Controller/4732THT_CONTROLLER2.kicad_pcb

## KiCad design Si4732THT/KiCAD_Controller/4732THT_CONTROLLER2.kicad_pcb (2023-09-04)

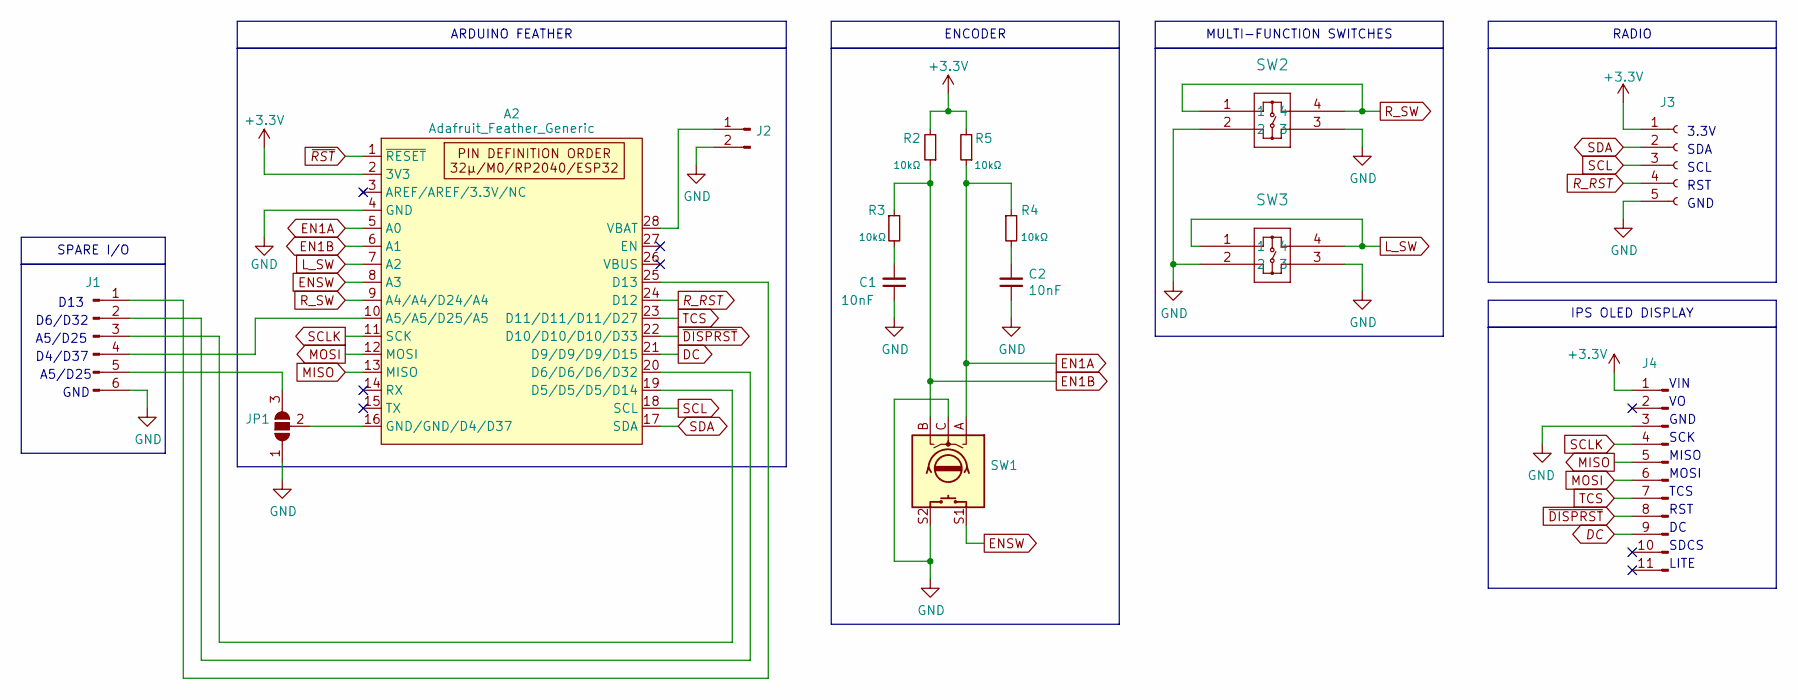
[picture p68: schematic 4732THT_CONTROLLER2.kicad_sch, SI4732 RADIO CONTROLLER]

Parts:
A2: Adafruit_Feather_Generic; Adafruit_Feather_WithMountingHoles
C1, C2: 10nF; C_Disc_D3.0mm_W1.6mm_P2.50mm; Mfr # C315C103K5R5TA; Digikey 399-4148-ND
J1: Conn_01x06_Pin; PinHeader_1x06_P2.54mm_Vertical
J2: Conn_01x02_Pin; JST_PH_S2B-PH-K_1x02_P2.00mm_Horizontal
J3: Conn_01x05_Socket; PinSocket_1x05_P2.54mm_Vertical
J4: Conn_01x11_Male; Display
JP1: SolderJumper_3_Open; SolderJumper-3_P1.3mm_Open_RoundedPad1.0x1.5mm
R2: 10kΩ; R_Axial_DIN0207_L6.3mm_D2.5mm_P7.62mm_Horizontal; Mfr # CFR-25JR-52-10K
R3, R4: 10kΩ; R_Axial_DIN0207_L6.3mm_D2.5mm_P7.62mm_Horizontal; Mfr # CFR-25JR-52-10K; Digikey 3-CFR-25JR-52-10KCT-ND
R5: 10kΩ; R_Axial_DIN0207_L6.3mm_D2.5mm_P7.62mm_Horizontal; Mfr # CFR-25JR-52-10K; Digikey 13-CFR-25JR-52-10KCT-ND
SW1: RotaryEncoder_Switch; RotaryEncoder_Alps_EC11E-Switch_Vertical_H20mm
SW2, SW3: D6R90F1LFS; D6R_CNK; Mfr # D6R90 F1 LFS; Digikey 401-1978-ND

Connections:
+3.3V: A2.2 (3V3), J3.1, J4.1, R2.2, R5.2
DC: A2.21 (D9/D9/D9/D15), J4.9
EN1A: A2.5 (A0), R4.1, R5.1, SW1.A
EN1B: A2.6 (A1), R2.1, R3.1, SW1.B
ENSW: A2.8 (A3), SW1.S1
GND: A2.4 (GND), C1.1, C2.1, J1.6, J2.2, J3.5, J4.3, JP1.1 (A), SW1.C, SW1.S2, SW2.2, SW2.3, SW3.2, SW3.3
L_SW: A2.7 (A2), SW3.1, SW3.4
MISO: A2.13 (MISO), J4.5
MOSI: A2.12 (MOSI), J4.6
unnamed: A2.10 (A5/A5/D25/A5), J1.4
unnamed: A2.19 (D5/D5/D5/D14), J1.3
unnamed: A2.20 (D6/D6/D6/D32), J1.2
unnamed: A2.25 (D13), J1.1
unnamed: A2.16 (GND/GND/D4/D37), JP1.2 (C)
unnamed: A2.28 (VBAT), J2.1
unnamed: C1.2, R3.2
unnamed: C2.2, R4.2
unnamed: J1.5, JP1.3 (B)
R_RST: A2.24 (D12), J3.4
R_SW: A2.9 (A4/A4/D24/A4), SW2.1, SW2.4
SCL: A2.18 (SCL), J3.3
SCLK: A2.11 (SCK), J4.4
SDA: A2.17 (SDA), J3.2
TCS: A2.23 (D11/D11/D11/D27), J4.7
~DISPRST: A2.22 (D10/D10/D10/D33), J4.8
~RST: A2.1 (~RESET)

Notes on the sheet:
RADIO
IPS OLED DISPLAY
MULTI-FUNCTION SWITCHES
ARDUINO FEATHER
SPARE I/O
ENCODER
SCL
SDCS
SDA
SCK
A5/D25
RST
VIN
TCS
LITE
MISO
MOSI
GND
3.3V
D4/D37
D6/D32
D13

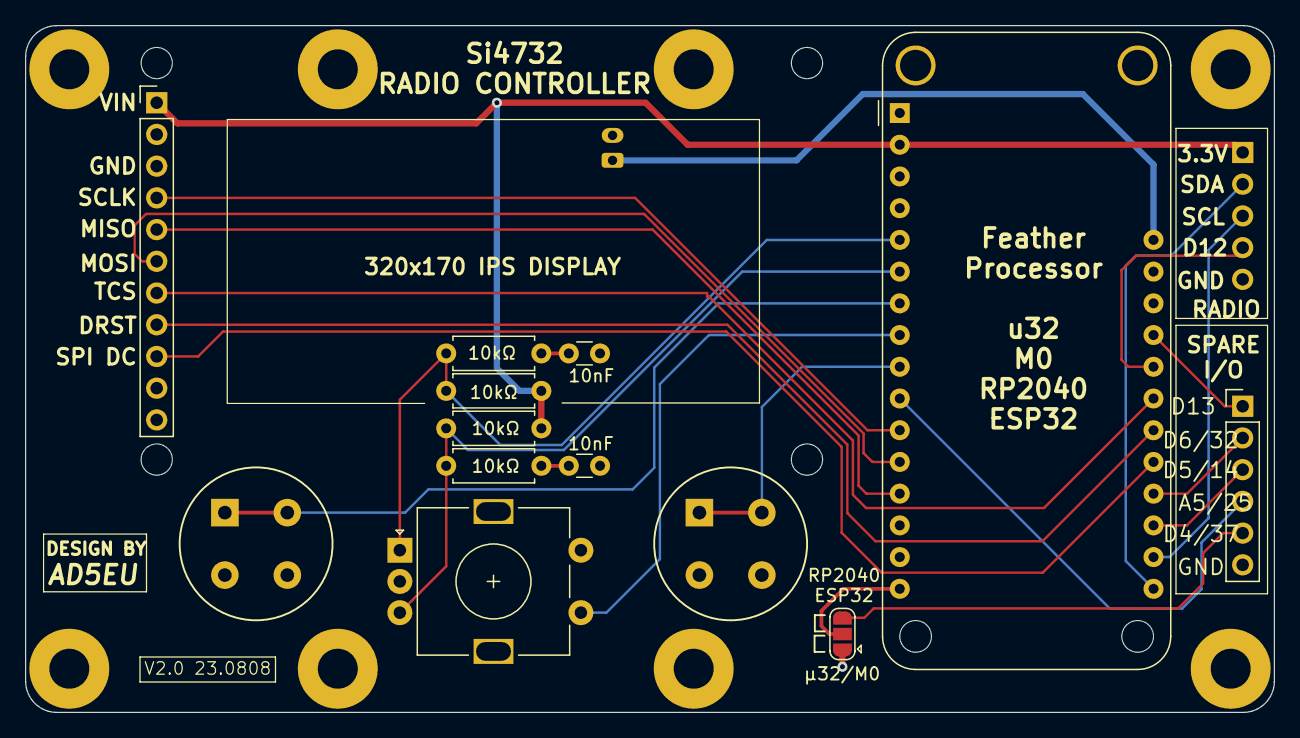
[picture p69: board 4732THT_CONTROLLER2.kicad_pcb from above]

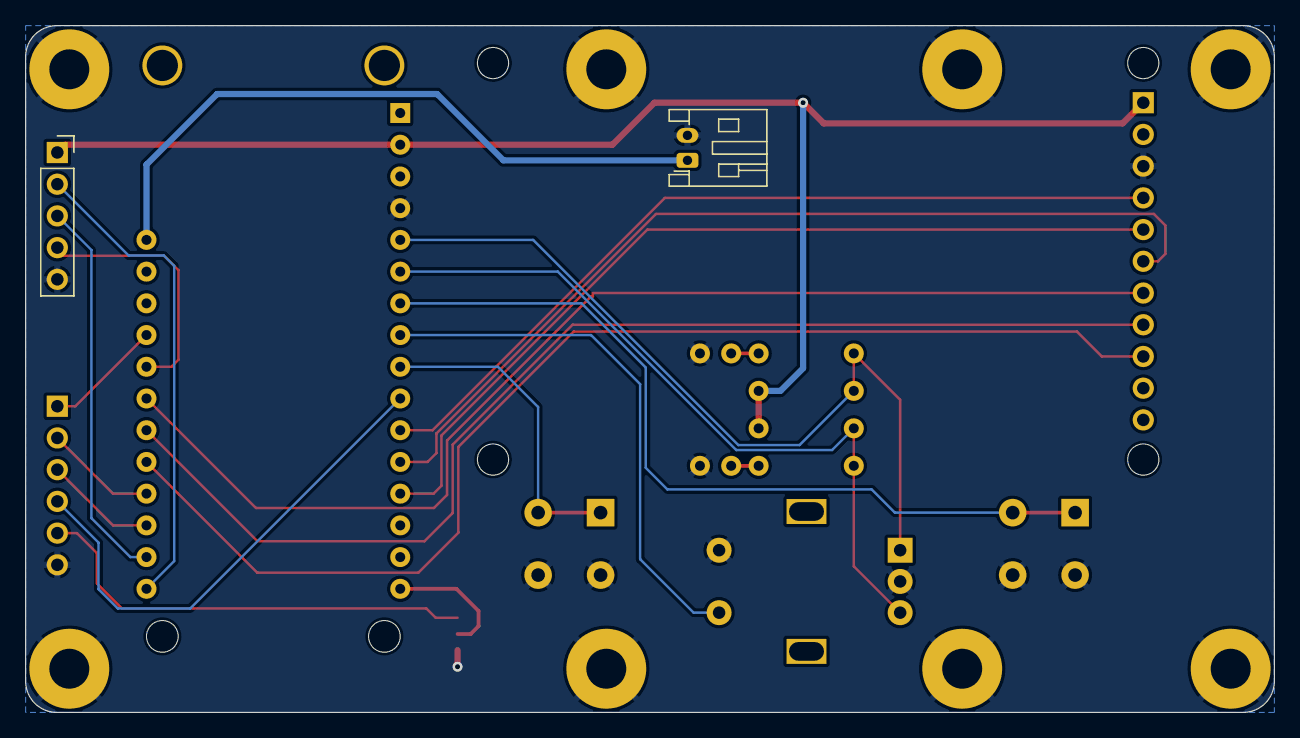
[picture p70: board 4732THT_CONTROLLER2.kicad_pcb from below]

Board: 2 copper layers, 100.0 x 55.0 mm, 15 parts (2 on the bottom side), 25 nets.
