LadyRoninEngineer/Si473x/Si4732THT/KiCADRadio/4732_THT_V2.kicad_pcb

## KiCad design Si4732THT/KiCADRadio/4732_THT_V2.kicad_pcb (2023-09-02)

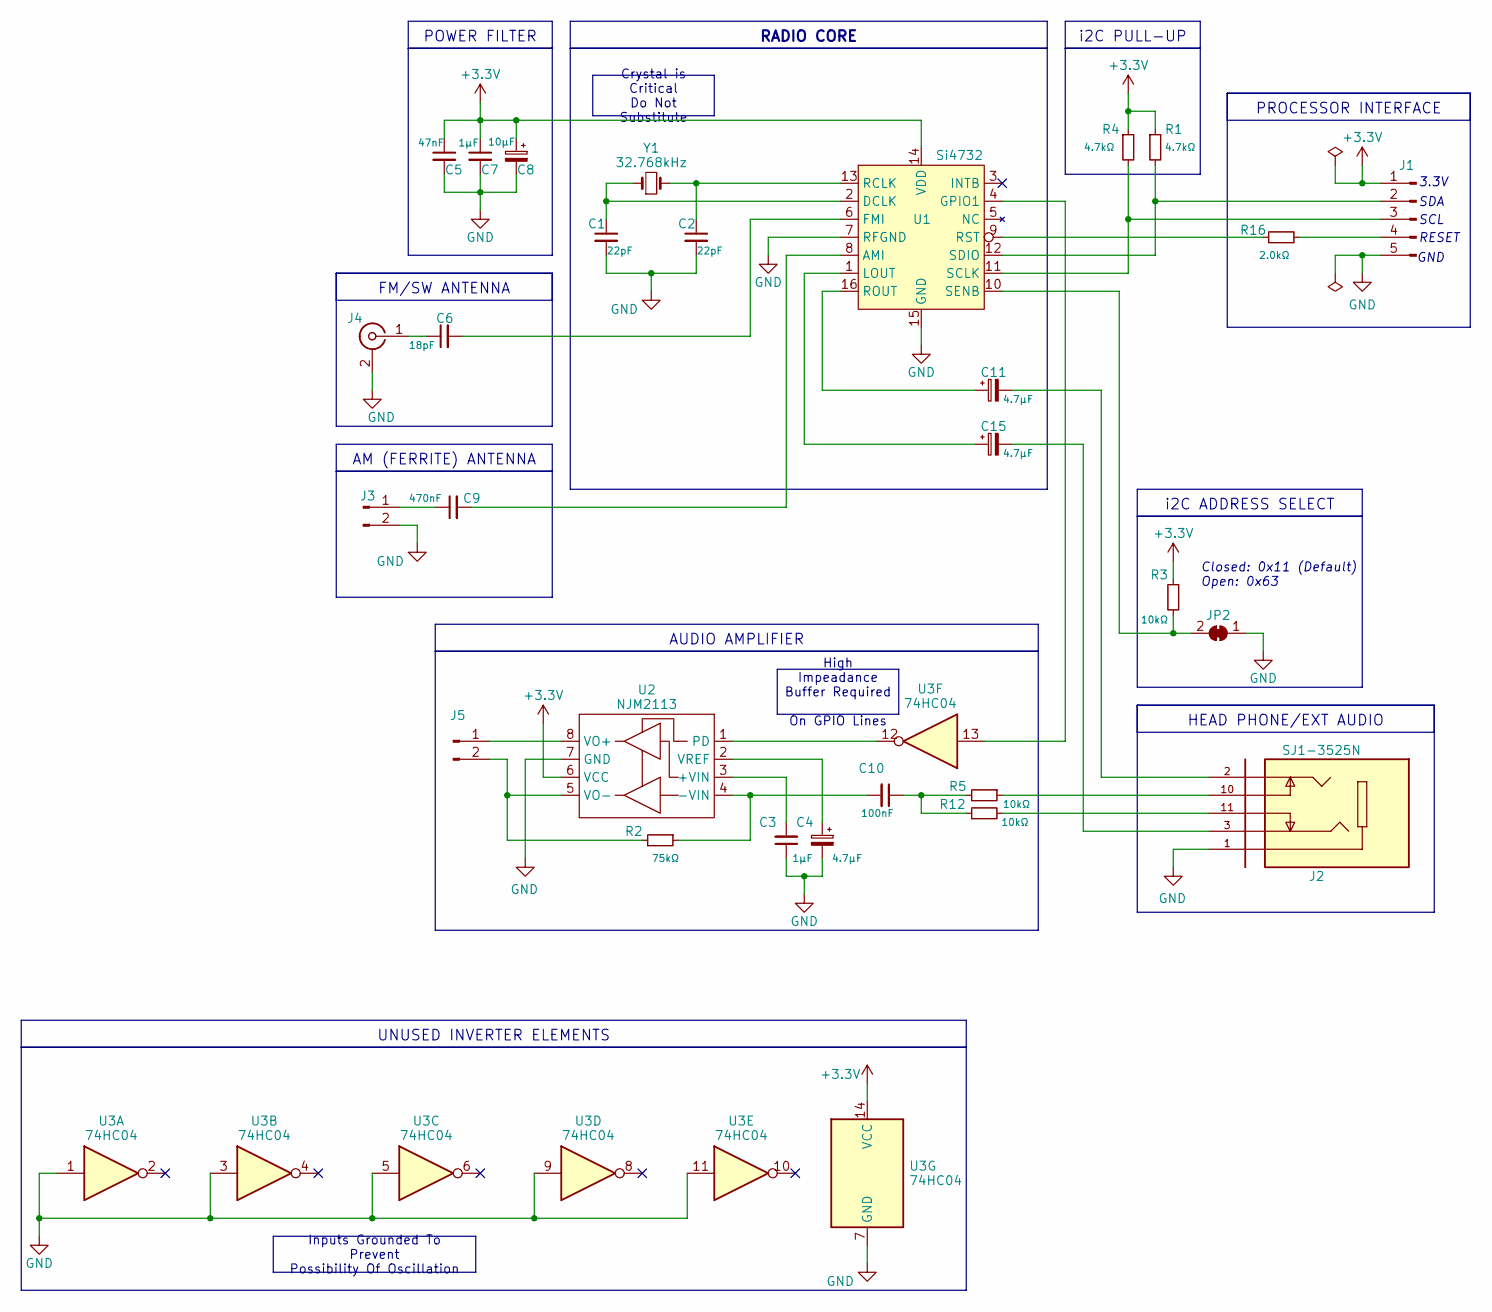
[picture p71: schematic 4732_THT_V2.kicad_sch, Si4732 Through Hole Technology Breakout Board]

Parts:
C1, C2: 22pF; C_Disc_D3.8mm_W2.6mm_P2.50mm
C3, C7: 1µF; CAP_C410C_AX_X7R_AXIMAX_KEM
C4, C11, C15: 4.7µF; CAPPRD250W45D400H500
C5: 47nF; C_Disc_D3.8mm_W2.6mm_P2.50mm
C6: 18pF; C_Disc_D3.8mm_W2.6mm_P2.50mm
C8: 10µF; CP_Radial_D4.0mm_P1.50mm
C9: 470nF; C_Disc_D3.8mm_W2.6mm_P2.50mm
C10: 100nF; C_Disc_D3.8mm_W2.6mm_P2.50mm
J1: Conn_01x05_Pin; PinHeader_1x05_P2.54mm_Vertical
J2: SJ1-3525N; CUI_SJ1-3525N; PARTREV 1.02
J3, J5: Conn_01x02_Pin; 1725656
J4: Conn_01x01_Female; SMA_Molex_73251-1153_EdgeMount_Horizontal
JP2: SolderJumper_2_Open; SolderJumper-2_P1.3mm_Bridged_RoundedPad1.0x1.5mm
R1, R4: 4.7kΩ; R_Axial_DIN0207_L6.3mm_D2.5mm_P7.62mm_Horizontal
R2: 75kΩ; R_Axial_DIN0207_L6.3mm_D2.5mm_P7.62mm_Horizontal
R3, R5, R12: 10kΩ; R_Axial_DIN0207_L6.3mm_D2.5mm_P7.62mm_Horizontal
R16: 2.0kΩ; R_Axial_DIN0207_L6.3mm_D2.5mm_P7.62mm_Horizontal
U1: Si4732; SOIC-16_3.9x9.9mm_P1.27mm
U2: NJM2113; DIP-8_W7.62mm
U3: 74HC04; DIP-14_W7.62mm
Y1: 32.768kHz; XTAL_ECS-.327-12.5-8X-C; Tolerance 20ppm; Mfr # ECS-.327-12.5-8X; Digikey X1123-ND

Connections:
+3.3V: C5.1, C7.1, C8.1, J1.1, R1.1, R3.1, R4.1, U1.14 (VDD), U2.6 (VCC), U3.14 (VCC)
GND: C1.2, C2.2, C3.1, C4.2, C5.2, C7.2, C8.2, J1.5, J2.1, J3.2, J4.2 (Ext), JP2.1 (A), U1.7 (RFGND), U1.15 (GND), U2.7 (GND), U3.1, U3.3, U3.5, U3.7 (GND), U3.9, U3.11
unnamed: C10.1, R5.2, R12.1
unnamed: C11.2, J2.2
unnamed: C15.2, J2.3
unnamed: J1.2, R4.2, U1.12 (SDIO)
unnamed: J1.3, R1.2, U1.11 (SCLK)
unnamed: J1.4, R16.2
unnamed: J2.10, R5.1
unnamed: J2.11, R12.2
unnamed: C9.1, J3.1
unnamed: C6.1, J4.1 (In)
unnamed: J5.1, U2.8 (VO+)
unnamed: J5.2, R2.2, U2.5 (VO-)
unnamed: JP2.2 (B), R3.2, U1.10 (SENB)
unnamed: C9.2, U1.8 (AMI)
unnamed: C1.1, U1.2 (DCLK), Y1.1
unnamed: C6.2, U1.6 (FMI)
unnamed: U1.4 (GPIO1), U3.13
unnamed: C15.1, U1.1 (LOUT)
unnamed: C2.1, U1.13 (RCLK), Y1.2
unnamed: C11.1, U1.16 (ROUT)
unnamed: R16.1, U1.9 (RST)
unnamed: C3.2, U2.3 (+VIN)
unnamed: C10.2, R2.1, U2.4 (-VIN)
unnamed: U2.1 (PD), U3.12
unnamed: C4.1, U2.2 (VREF)

Notes on the sheet:
POWER FILTER
Inputs Grounded To Prevent Possibility Of Oscillation
UNUSED INVERTER ELEMENTS
HEAD PHONE/EXT AUDIO
FM/SW ANTENNA
AUDIO AMPLIFIER
i2C ADDRESS SELECT
High Impeadance Buffer Required On GPIO Lines
AM (FERRITE) ANTENNA
i2C PULL-UP
RADIO CORE
PROCESSOR INTERFACE
Crystal is Critical Do Not Substitute
SCL
Closed: 0x11 (Default) Open: 0x63
SDA
GND
3.3V
RESET

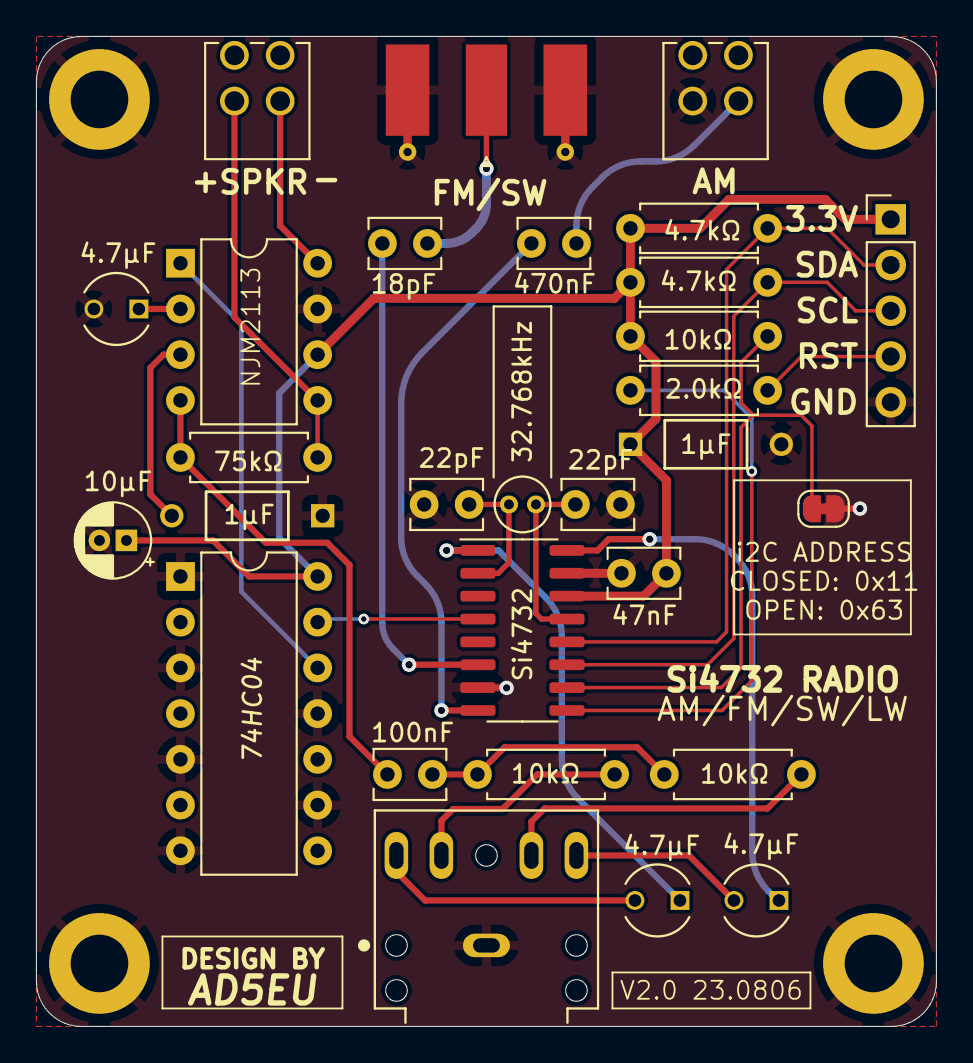
[picture p72: board 4732_THT_V2.kicad_pcb from above]

Board: 2 copper layers, 50.0 x 55.0 mm, 29 parts (0 on the bottom side), 27 nets.
