LadyRoninEngineer/Si473x/MBRF_DUAL/MBRadioDual2.kicad_pcb

## KiCad design MBRF_DUAL/MBRadioDual2.kicad_pcb (2022-01-26)

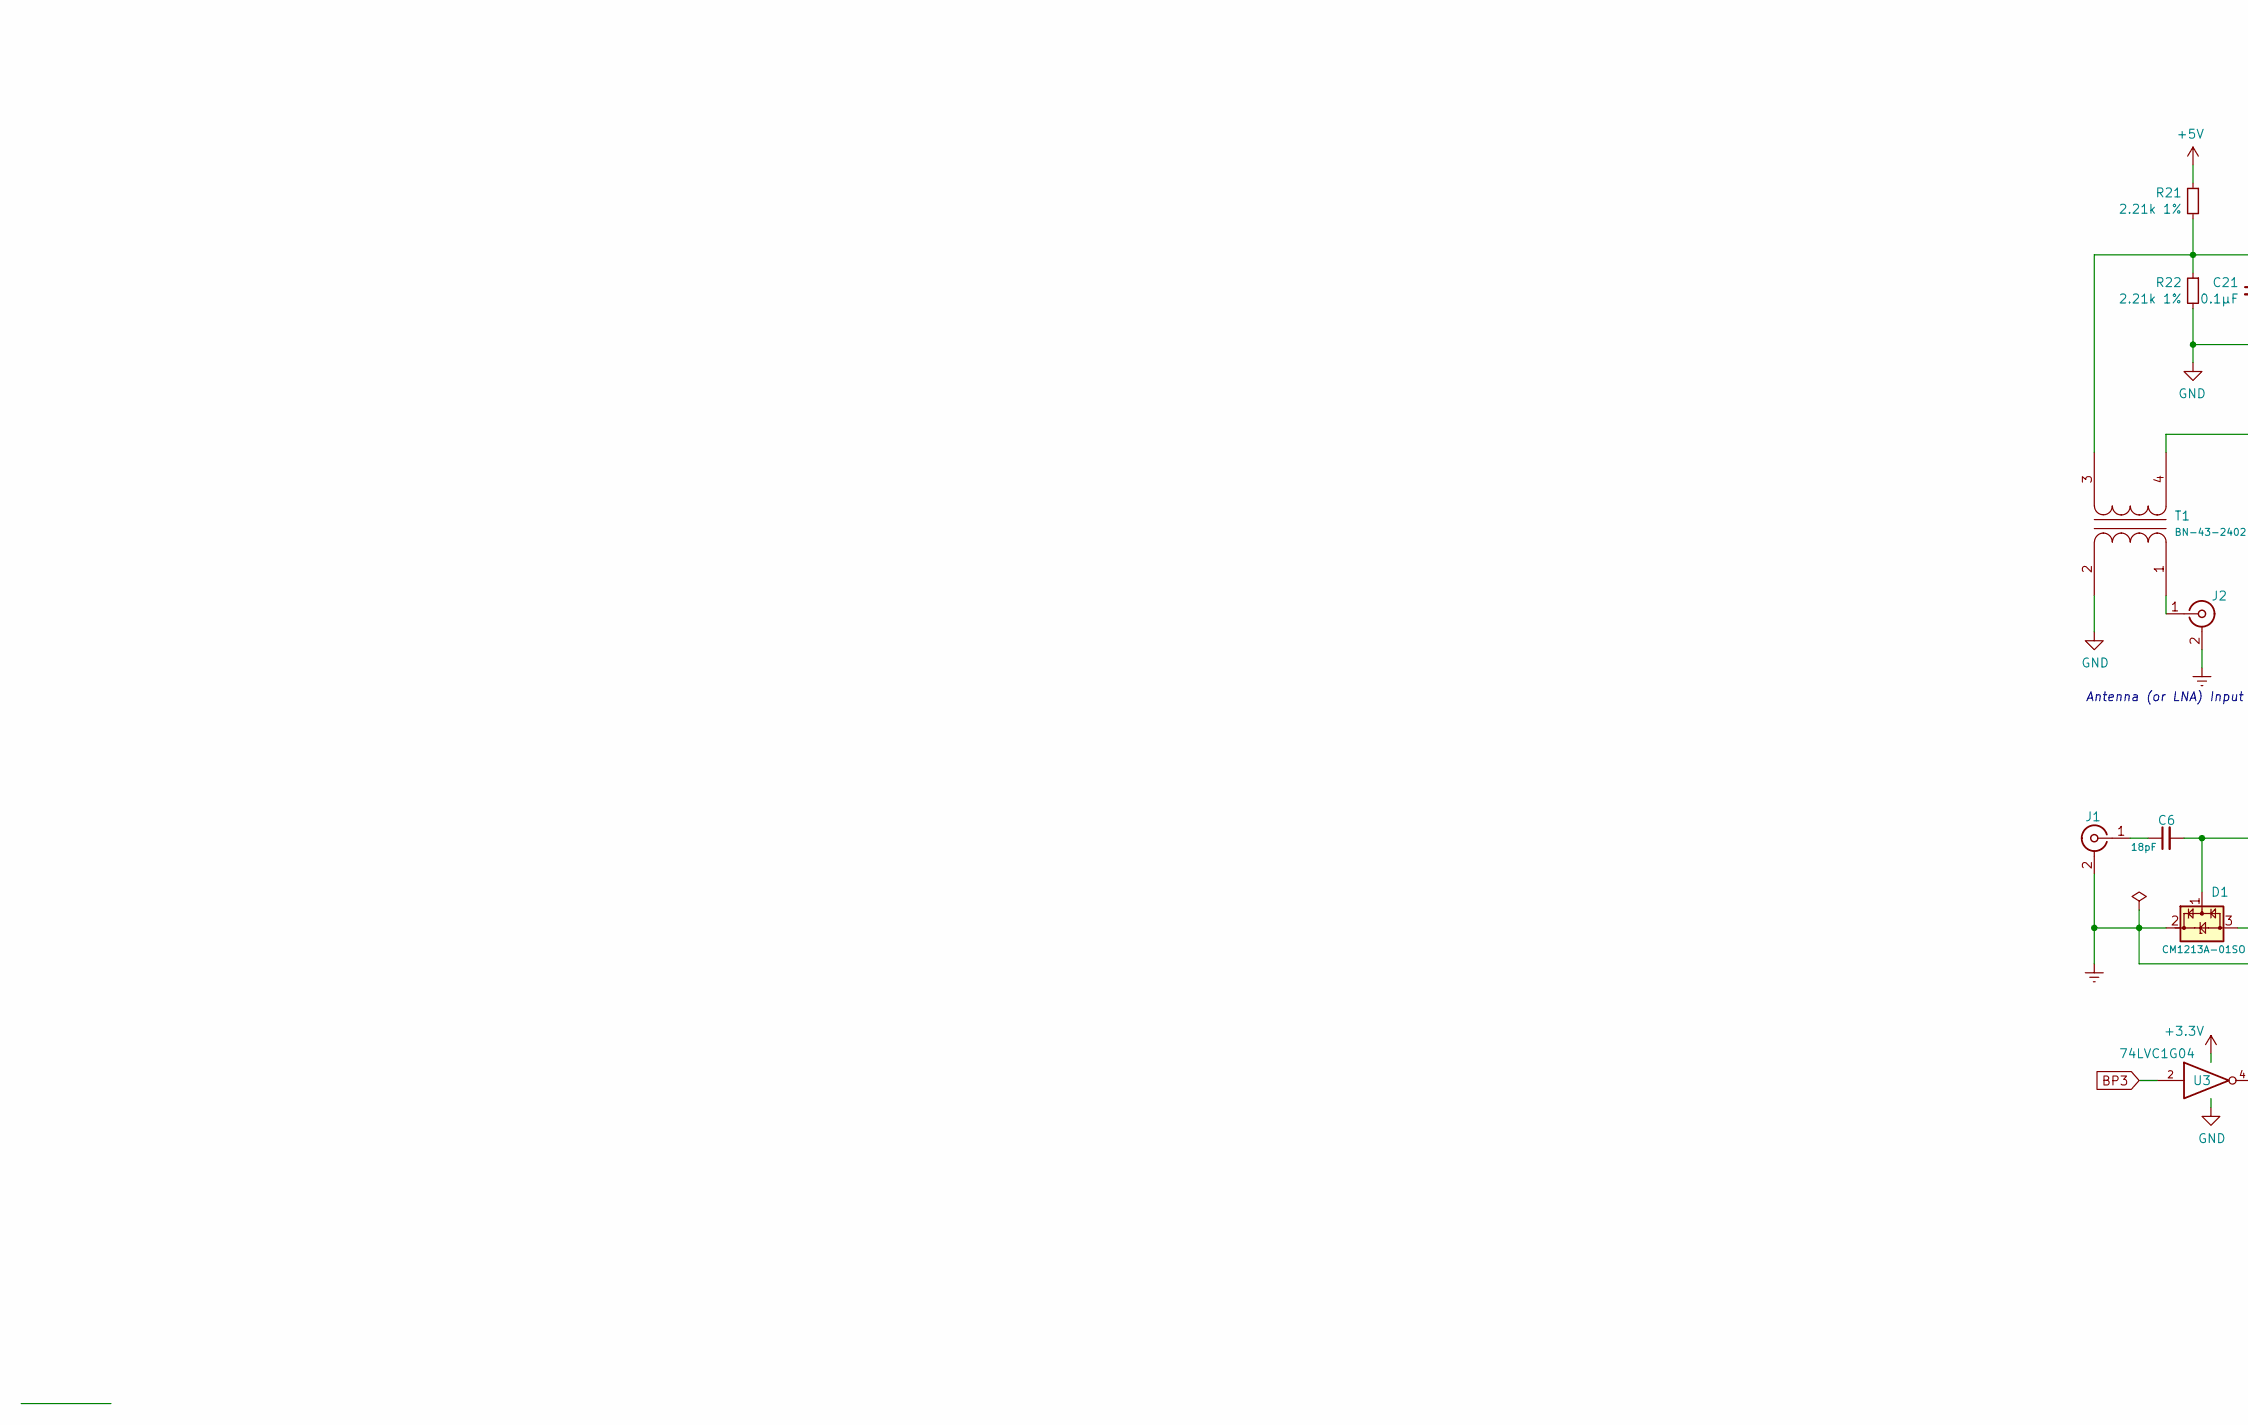
[picture p73: schematic MBRadioDual2.kicad_sch, Si473x Multiband Radio Control Processor, part in row 1, column 1]

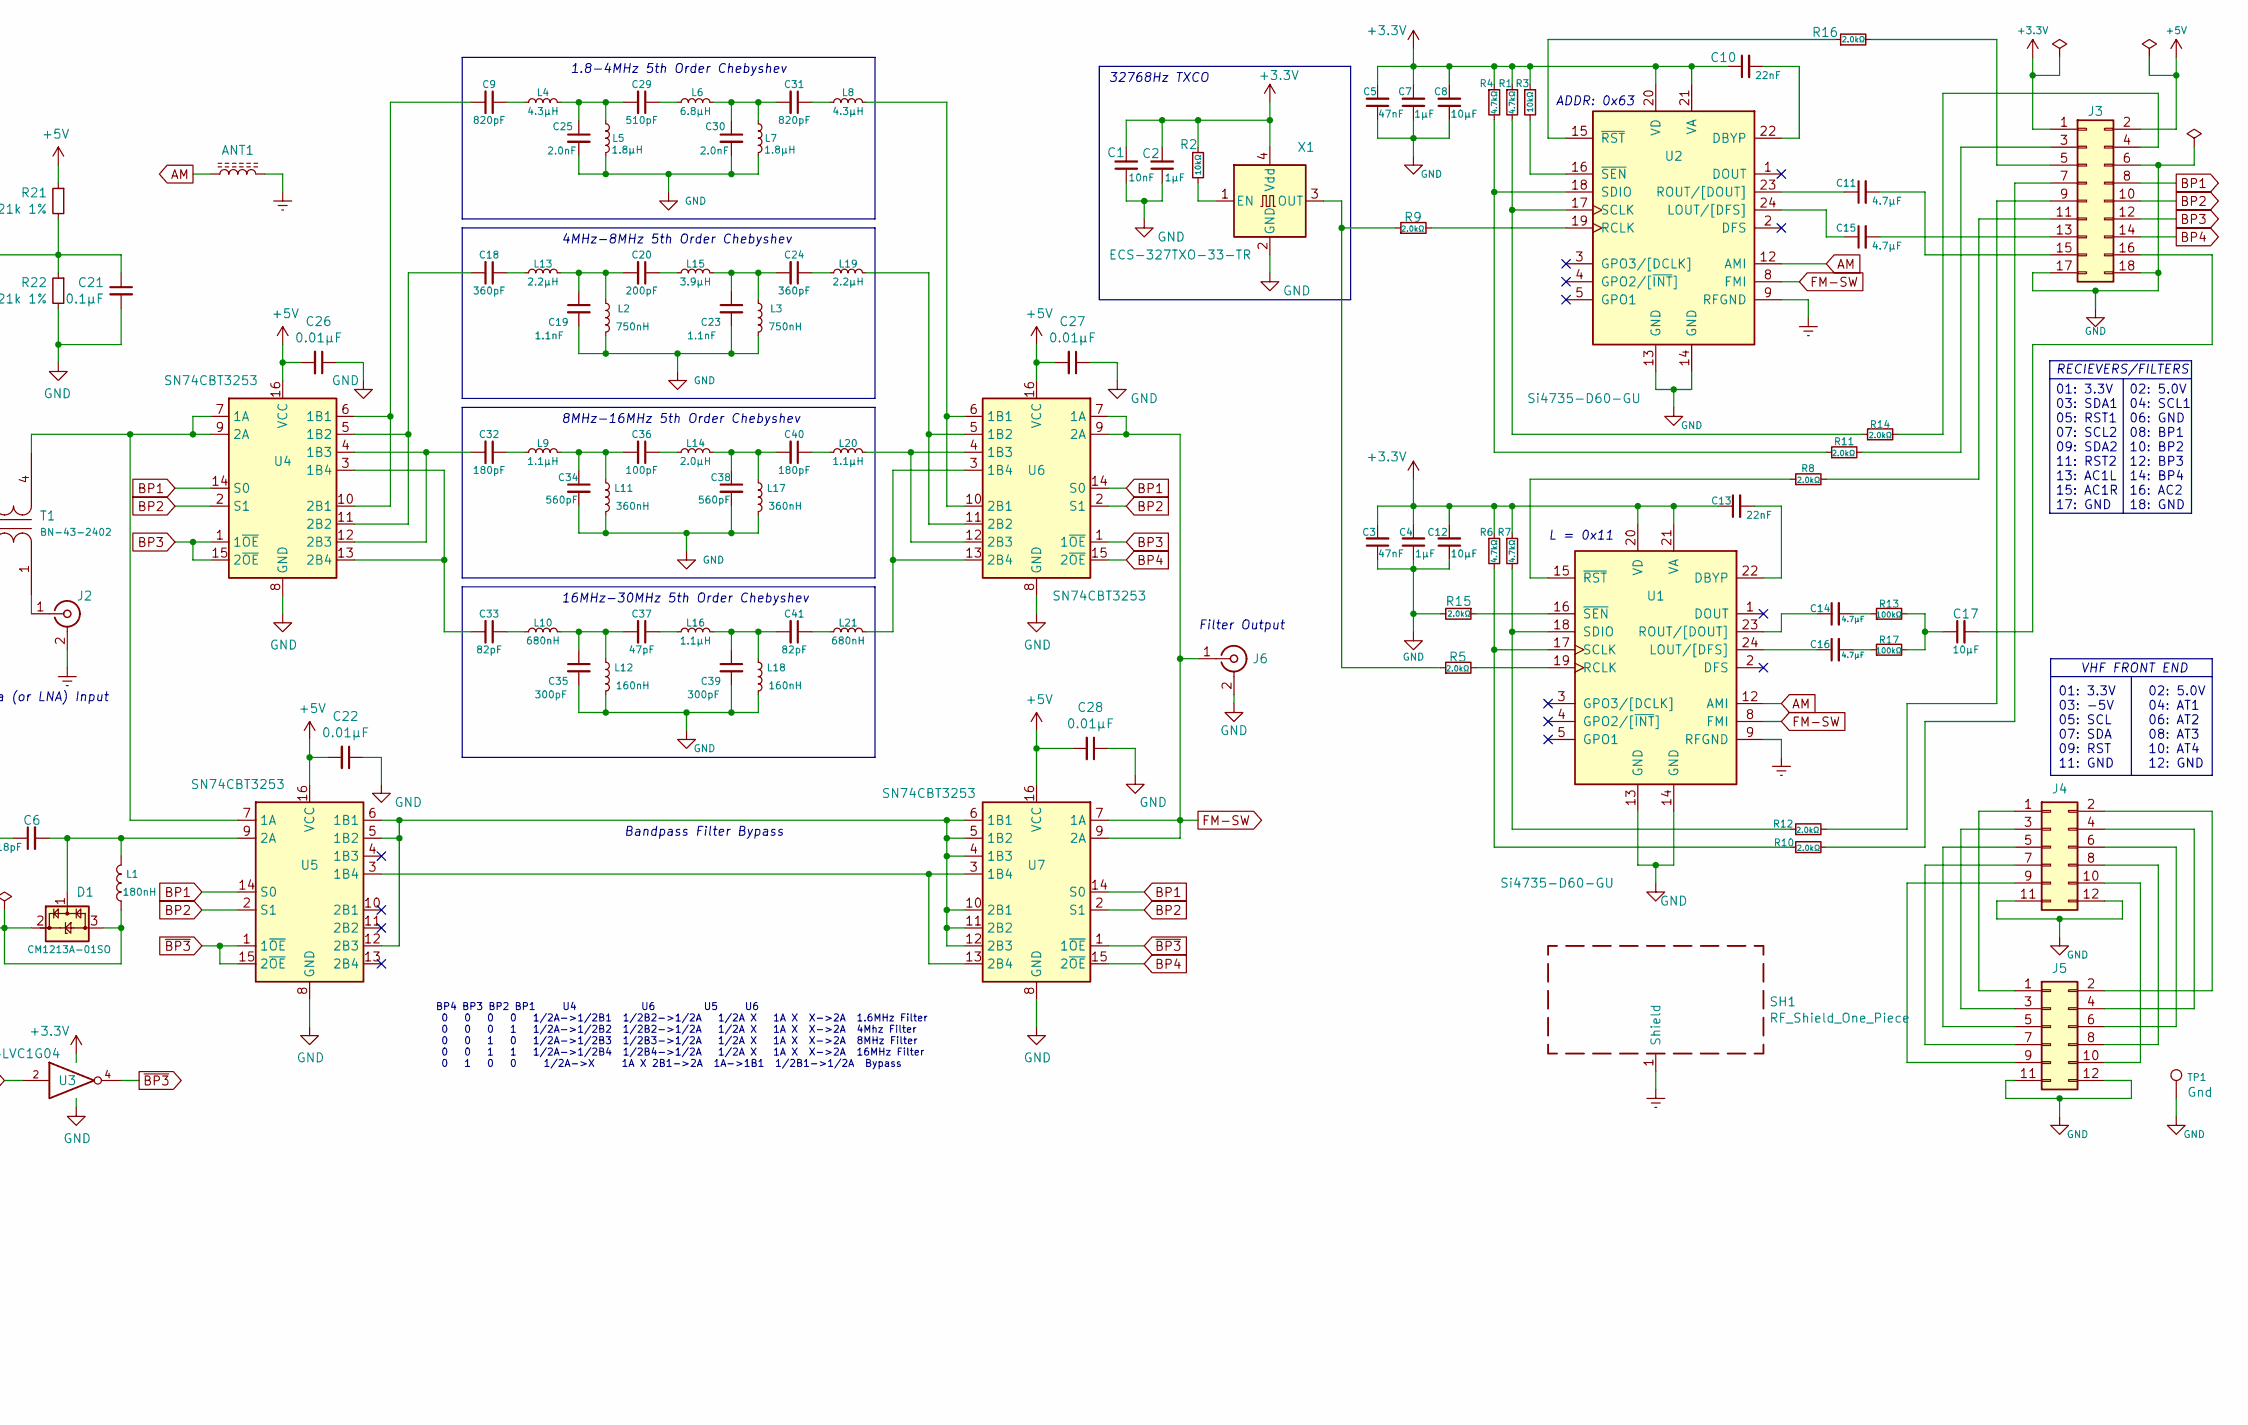
[picture p74: schematic MBRadioDual2.kicad_sch, Si473x Multiband Radio Control Processor, part in row 1, column 2]

Parts:
ANT1: L_Core_Ferrite
C1: 10nF; C_0402_1005Metric
C2: 1µF; C_0402_1005Metric
C3, C5: 47nF; C_0402_1005Metric
C4, C7: 1µF; C_0603_1608Metric
C6: 18pF; C_0603_1608Metric; Tolerance 5%; Mfr # 06035U180JAT2A; Digikey 478-11831-1-ND
C8, C12, C17: 10µF; C_0603_1608Metric
C9, C31: 820pF; C_0805_2012Metric; Tolerance ±5%; Mfr # VJ0805D821JXJQJHT; Digikey 720-VJ0805D821JXJQJHTCT-ND
C10, C13: 22nF; C_0603_1608Metric
C11, C14, C15, C16: 4.7µF; C_0603_1608Metric
C18, C24: 360pF; C_0603_1608Metric; Tolerance ±2%; Mfr # C0603C361G5GAC7867; Digikey 399-14514-1-ND
C19, C23: 1.1nF; C_0805_2012Metric; Mfr # C0805C112J5GAC7800; Digikey 399-14552-1-ND
C20: 200pF; C_0805_2012Metric; Tolerance ±10%; Mfr # VJ0805D201KXPAJ; Digikey 720-1346-1-ND
C21: 0.1µF; C_0603_1608Metric
C22, C26, C27, C28: 0.01µF; C_0402_1005Metric
C25, C30: 2.0nF; C_0805_2012Metric; Tolerance ±5%; Mfr # C0805C202J5GAC7800; Digikey 399-15025-1-ND
C29: 510pF; C_0603_1608Metric; Mfr # C0603C511J5GAC7867; Digikey 399-C0603C511J5GAC7867CT-ND
C32, C40: 180pF; C_0603_1608Metric; Tolerance 10%; Mfr # VJ0603D181KXAAJ; Digikey 20-1328-1-ND
C33, C41: 82pF; C_0603_1608Metric; Tolerance 1%; Mfr # CBR06C820F5GAC; Digikey 399-16259-1-ND
C34, C38: 560pF; C_0805_2012Metric; Tolerance 10%; Mfr # VJ0805D561KXBAJ; Digikey 720-1354-1-ND
C35, C39: 300pF; C_0603_1608Metric; Tolerance 10%; Mfr # VJ0603D301KXAAJ; Digikey 720-1332-1-ND
C36: 100pF; C_0402_1005Metric; Tolerance 1%; Mfr # CBR04C101F3GAC; Digikey 399-11246-1-ND
C37: 47pF; C_0402_1005Metric; Tolerance 1%; Mfr # CBR04C470F3GAC; Digikey 399-17536-1-ND
D1: CM1213A-01SO; SOT-23; Mfr # CM1213A-01SO; Digikey CM1213A-01SOOSCT-ND
J1, J2, J6: Conn_01x01_Female; SMA_Amphenol_132134-10_Vertical
J3: Conn_02x09_Odd_Even; PinHeader_2x09_P2.54mm_Vertical
J4, J5: Conn_02x06_Odd_Even; PinHeader_2x06_P2.54mm_Vertical
L1: 180nH; L_0603_1608Metric; Mfr # LQW18ANR18J00D; Digikey 490-6928-1-ND
L2, L3: 750nH; L_1008_2520Metric; Tolerance 5%; Mfr # 1008CS-751XJLC; Mouser 994-1008CS-751XJLC
L4: 4.3µH; L_Toroid_Vertical_Amidon_T30-2; Tolerance 32 turns
L5, L7: 1.8µH; L_1008_2520Metric; Tolerance 2%; Mfr # LQW2UAS1R8G0CL; Mouser 81-LQW2UAS1R8G0CL
L6: 6.8µH; L_Toroid_Vertical_Amidon_T30-2; Tolerance 40 turns
L8: 4.3µH; L_Toroid_Vertical_Amidon_T30-2
L9, L16, L20: 1.1µH; L_Toroid_Vertical_Amidon_T25-6
L10, L21: 680nH; L_0805_2012Metric; Tolerance 5%; Mfr # 0805HP-681XJRC; Mouser 994-0805HP-681XJRC
L11, L17: 360nH; L_0603_1608Metric; Tolerance 2%; Mfr # 0603HP-R36XGLW; Mouser 994-0603HP-R36XGLW
L12, L18: 160nH; L_0805_2012Metric; Tolerance 2%; Mfr # 0805HP-151XGRC; Mouser 994-0805HP-151XGRC
L13, L19: 2.2µH; L_Toroid_Vertical_Amidon_T25-6
L14: 2.0µH; L_Toroid_Vertical_Amidon_T25-6
L15: 3.9µH; L_Toroid_Vertical_Amidon_T25-6
R1, R4, R6, R7: 4.7kΩ; R_0603_1608Metric
R2, R3: 10kΩ; R_0603_1608Metric
R5, R8, R9, R10, R11, R12, R14, R15, R16: 2.0kΩ; R_0603_1608Metric
R13, R17: 100kΩ; R_0603_1608Metric
R21, R22: 2.21k 1%; R_0603_1608Metric
SH1: RF_Shield_One_Piece; Laird_Technologies_BMI-S-203-F_26.21x26.21mm
T1: BN-43-2402; BN43-2402
TP1: Gnd; TestPoint_Keystone_5000-5004_Miniature
U1, U2: Si4735-D60-GU; SSOP-24_3.9x8.7mm_P0.635mm
U3: 74LVC1G04; TSOT-23-5
U4, U5, U6, U7: SN74CBT3253; TSSOP-16_4.4x5mm_P0.65mm
X1: ECS-327TXO-33-TR; Oscillator_SMD_Abracon_ASE-4Pin_3.2x2.5mm

Connections:
+3V3: C1.2, C2.2, C3.2, C4.2, C5.2, C7.2, C8.2, C10.1, C12.2, C13.1, J3.1, R1.1, R2.1, R3.1, R4.1, R6.1, R7.1, U1.20 (VD), U1.21 (VA), U2.20 (VD), U2.21 (VA), U3.5 (VCC), X1.4 (Vdd)
+5V: C22.2, C26.2, C27.2, C28.2, J3.2, R21.1, U4.16 (VCC), U5.16 (VCC), U6.16 (VCC), U7.16 (VCC)
AM: ANT1.1, U1.12 (AMI), U2.12 (AMI)
BP1: J3.8, U4.14 (S0), U5.14 (S0), U6.14 (S0), U7.14 (S0)
BP2: J3.10, U4.2 (S1), U5.2 (S1), U6.2 (S1), U7.2 (S1)
BP3: J3.12, U3.2, U4.1 (1~OE), U4.15 (2~OE), U6.1 (1~OE)
BP4: J3.14, U6.15 (2~OE), U7.15 (2~OE)
Earth: ANT1.2, D1.2 (VP), D1.3 (VN), J1.2 (Ext), J2.2 (Ext), L1.2, SH1.1, U1.9 (RFGND), U2.9 (RFGND)
FM-SW: J6.1 (In), U1.8 (FMI), U2.8 (FMI), U6.7 (1A), U6.9 (2A), U7.7 (1A), U7.9 (2A)
GND: C1.1, C2.1, C3.1, C4.1, C5.1, C7.1, C8.1, C12.1, C19.2, C21.2, C22.1, C23.2, C25.2, C26.1, C27.1, C28.1, C30.2, C34.2, C35.2, C38.2, C39.2, J3.6, J3.17, J3.18, J4.11, J4.12, J5.11, J5.12, J6.2 (Ext), L2.2, L3.2, L5.2, L7.2, L11.2, L12.2, L17.2, L18.2, R15.2, R22.2, T1.2 (AB), TP1.1, U1.13 (GND), U1.14 (GND), U2.13 (GND), U2.14 (GND), U3.3 (GND), U4.8 (GND), U5.8 (GND), U6.8 (GND), U7.8 (GND), X1.2 (GND)
unnamed: C6.1, J1.1 (In)
unnamed: C6.2, D1.1 (CH1), L1.1, U5.9 (2A)
unnamed: C9.1, L4.1
unnamed: C9.2, U4.6 (1B1), U4.10 (2B1)
unnamed: C10.2, U2.22 (DBYP)
unnamed: C11.1, U2.23 (ROUT/[DOUT])
unnamed: C11.2, J3.15
unnamed: C13.2, U1.22 (DBYP)
unnamed: C14.1, U1.23 (ROUT/[DOUT])
unnamed: C14.2, R13.1
unnamed: C15.1, U2.24 (LOUT/[DFS])
unnamed: C15.2, J3.13
unnamed: C16.1, U1.24 (LOUT/[DFS])
unnamed: C16.2, R17.1
unnamed: C17.1, R13.2, R17.2
unnamed: C17.2, J3.16
unnamed: C18.1, L13.1
unnamed: C18.2, U4.5 (1B2), U4.11 (2B2)
unnamed: C19.1, C20.2, L2.1, L13.2
unnamed: C20.1, L15.1
unnamed: C21.1, R21.2, R22.1, T1.3 (SA)
unnamed: C23.1, C24.2, L3.1, L15.2
unnamed: C24.1, L19.1
unnamed: C25.1, C29.2, L4.2, L5.1
unnamed: C29.1, L6.1
unnamed: C30.1, C31.2, L6.2, L7.1
unnamed: C31.1, L8.1
unnamed: C32.1, L9.1
unnamed: C32.2, U4.4 (1B3), U4.12 (2B3)
unnamed: C33.1, L10.1
unnamed: C33.2, U4.3 (1B4), U4.13 (2B4)
unnamed: C34.1, C36.2, L9.2, L11.1
unnamed: C35.1, C37.2, L10.2, L12.1
unnamed: C36.1, L14.1
unnamed: C37.1, L16.1
unnamed: C38.1, C40.2, L14.2, L17.1
unnamed: C39.1, C41.2, L16.2, L18.1
unnamed: C40.1, L20.1
unnamed: C41.1, L21.1
unnamed: J2.1 (In), T1.1 (AA)
unnamed: J3.3, R11.2
unnamed: J3.4, R14.2
unnamed: J3.5, R16.2
unnamed: J3.7, R10.2
unnamed: J3.9, R12.2
unnamed: J3.11, R8.2
unnamed: J4.1, J5.1
unnamed: J4.2, J5.2
unnamed: J4.3, J5.3
unnamed: J4.4, J5.4
unnamed: J4.5, J5.5
unnamed: J4.6, J5.6
unnamed: J4.7, J5.7
unnamed: J4.8, J5.8
unnamed: J4.9, J5.9
unnamed: J4.10, J5.10
unnamed: L8.2, U6.6 (1B1), U6.10 (2B1)
unnamed: L19.2, U6.5 (1B2), U6.11 (2B2)
unnamed: L20.2, U6.4 (1B3), U6.12 (2B3)
unnamed: L21.2, U6.3 (1B4), U6.13 (2B4)
unnamed: R1.2, R14.1, U2.17 (SCLK)
unnamed: R2.2, X1.1 (EN)
unnamed: R3.2, U2.16 (~SEN)
unnamed: R5.1, R9.1, X1.3 (OUT)
unnamed: R5.2, U1.19 (RCLK)
unnamed: R8.1, U1.15 (~RST)
unnamed: R9.2, U2.19 (RCLK)
unnamed: R6.2, R10.1, U1.17 (SCLK)
unnamed: R4.2, R11.1, U2.18 (SDIO)
unnamed: R7.2, R12.1, U1.18 (SDIO)
unnamed: R15.1, U1.16 (~SEN)
unnamed: R16.1, U2.15 (~RST)
unnamed: T1.4 (SB), U4.7 (1A), U4.9 (2A), U5.7 (1A)
unnamed: U5.3 (1B4), U7.3 (1B4), U7.13 (2B4)
unnamed: U5.5 (1B2), U5.6 (1B1), U5.12 (2B3), U7.4 (1B3), U7.5 (1B2), U7.6 (1B1), U7.10 (2B1), U7.11 (2B2), U7.12 (2B3)
~BP3: U3.4, U5.1 (1~OE), U5.15 (2~OE), U7.1 (1~OE)

Notes on the sheet:
4MHz-8MHz 5th Order Chebyshev
L = 0x11
02: 5.0V 04: SCL1 06: GND 08: BP1 10: BP2 12: BP3 14: BP4 16: AC2 18: GND
1.8-4MHz 5th Order Chebyshev
02: 5.0V 04: AT1 06: AT2 08: AT3 10: AT4 12: GND
BP4 BP3 BP2 BP1 U4 U6 U5 U6 0 0 0 0 1/2A->1/2B1 1/2B2->1/2A 1/2A X 1A X X->2A 1.6MHz Filter 0 0 0 1 1/2A->1/2B2 1/2B2->1/2A 1/2A X 1A X X->2A 4Mhz Filter 0 0 1 0 1/2A->1/2B3 1/2B3->1/2A 1/2A X 1A X X->2A 8MHz Filter 0 0 1 1 1/2A->1/2B4 1/2B4->1/2A 1/2A X 1A X X->2A 16MHz Filter 0 1 0 0 1/2A->X 1A X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
01: 3.3V 03: -5V 05: SCL 07: SDA 09: RST 11: GND
01: 3.3V 03: SDA1 05: RST1 07: SCL2 09: SDA2 11: RST2 13: AC1L 15: AC1R 17: GND
Filter Output
ADDR: 0x63
8MHz-16MHz 5th Order Chebyshev
Bandpass Filter Bypass
RECIEVERS/FILTERS
32768Hz TXCO
16MHz-30MHz 5th Order Chebyshev
VHF FRONT END
Antenna (or LNA) Input
