LadyRoninEngineer/Si473x/MBRF_DUAL/MBRadioDual2.kicad_pcb

## KiCad design MBRF_DUAL/MBRadioDual2.kicad_pcb (continued)

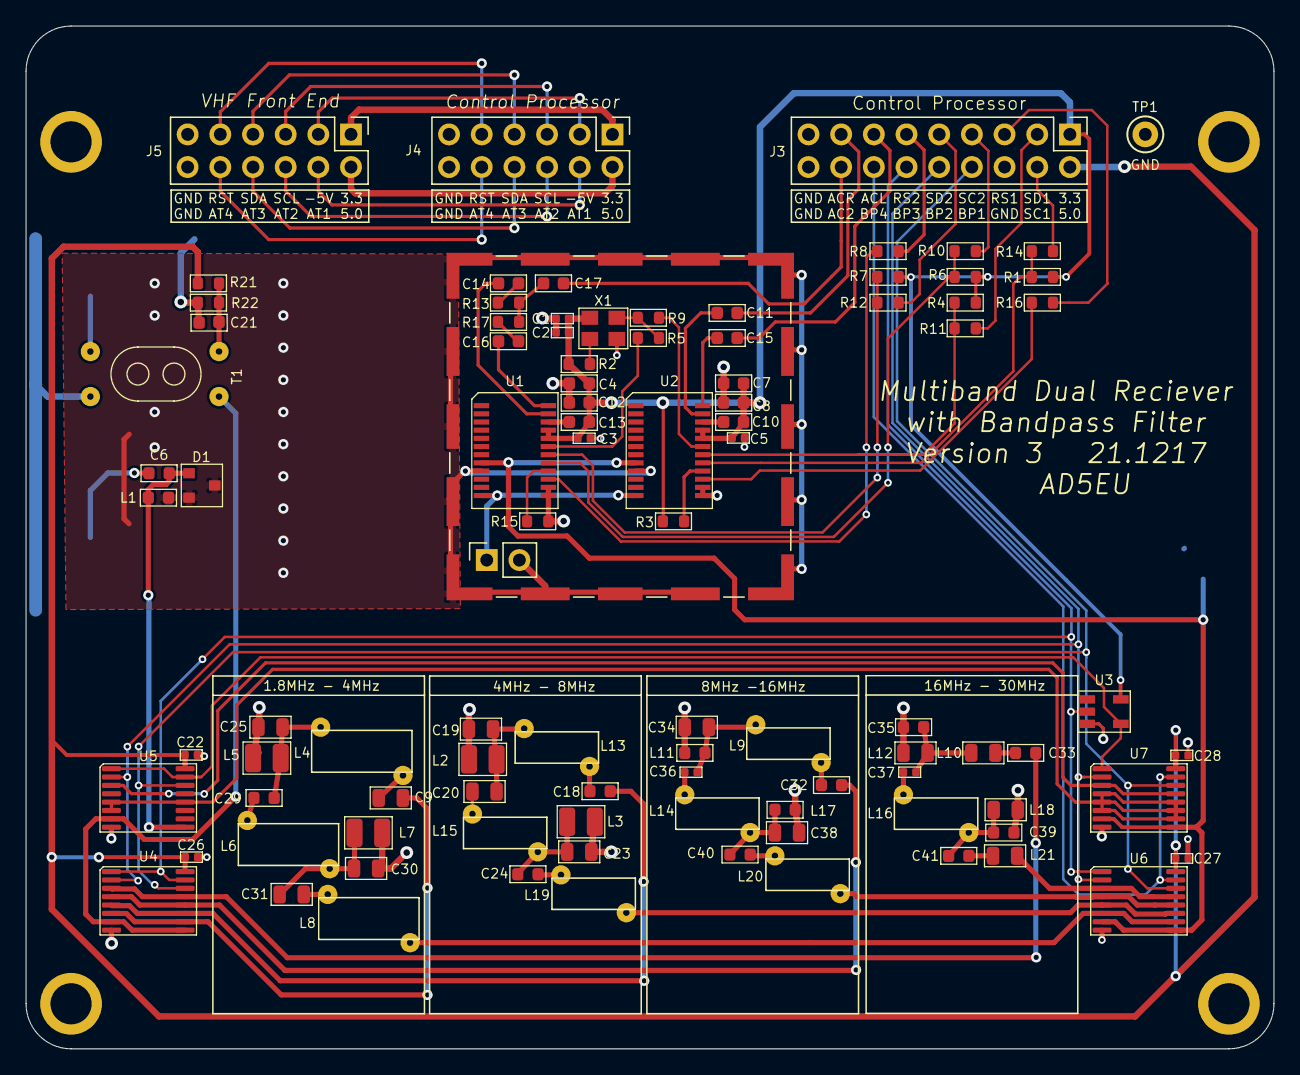
[picture p75: board MBRadioDual2.kicad_pcb from above]

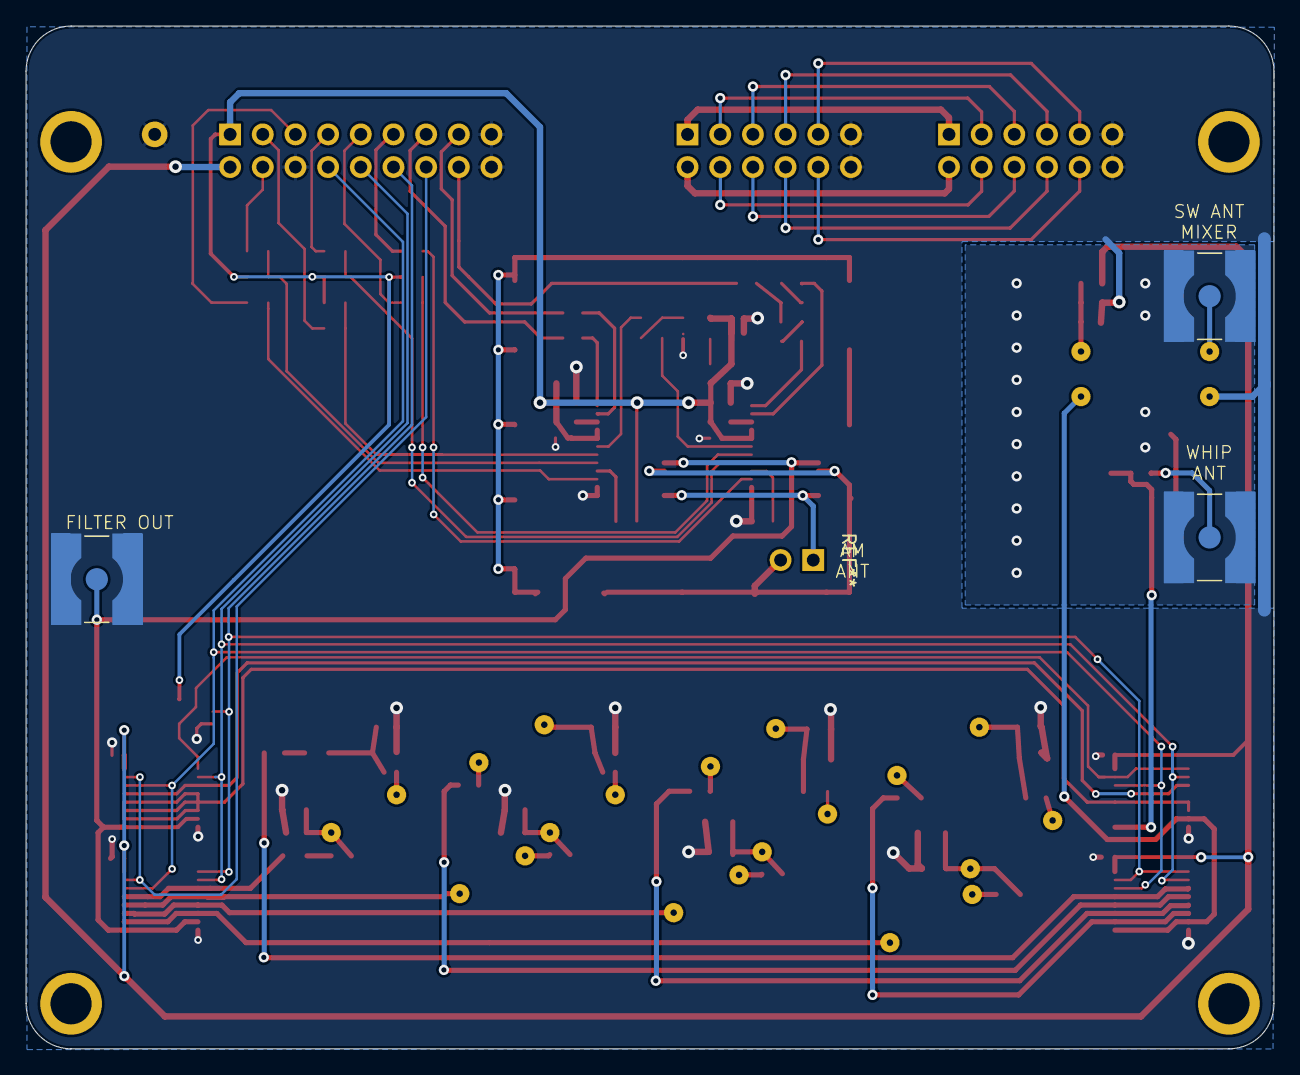
[picture p76: board MBRadioDual2.kicad_pcb from below]

Board: 2 copper layers, 97.0 x 79.5 mm, 99 parts (3 on the bottom side), 86 nets.
