LadyRoninEngineer/Si473x/Breakout_V3/MBRadio_4732_BO3.kicad_pcb

## KiCad design Breakout_V3/MBRadio_4732_BO3.kicad_pcb (2021-05-01)

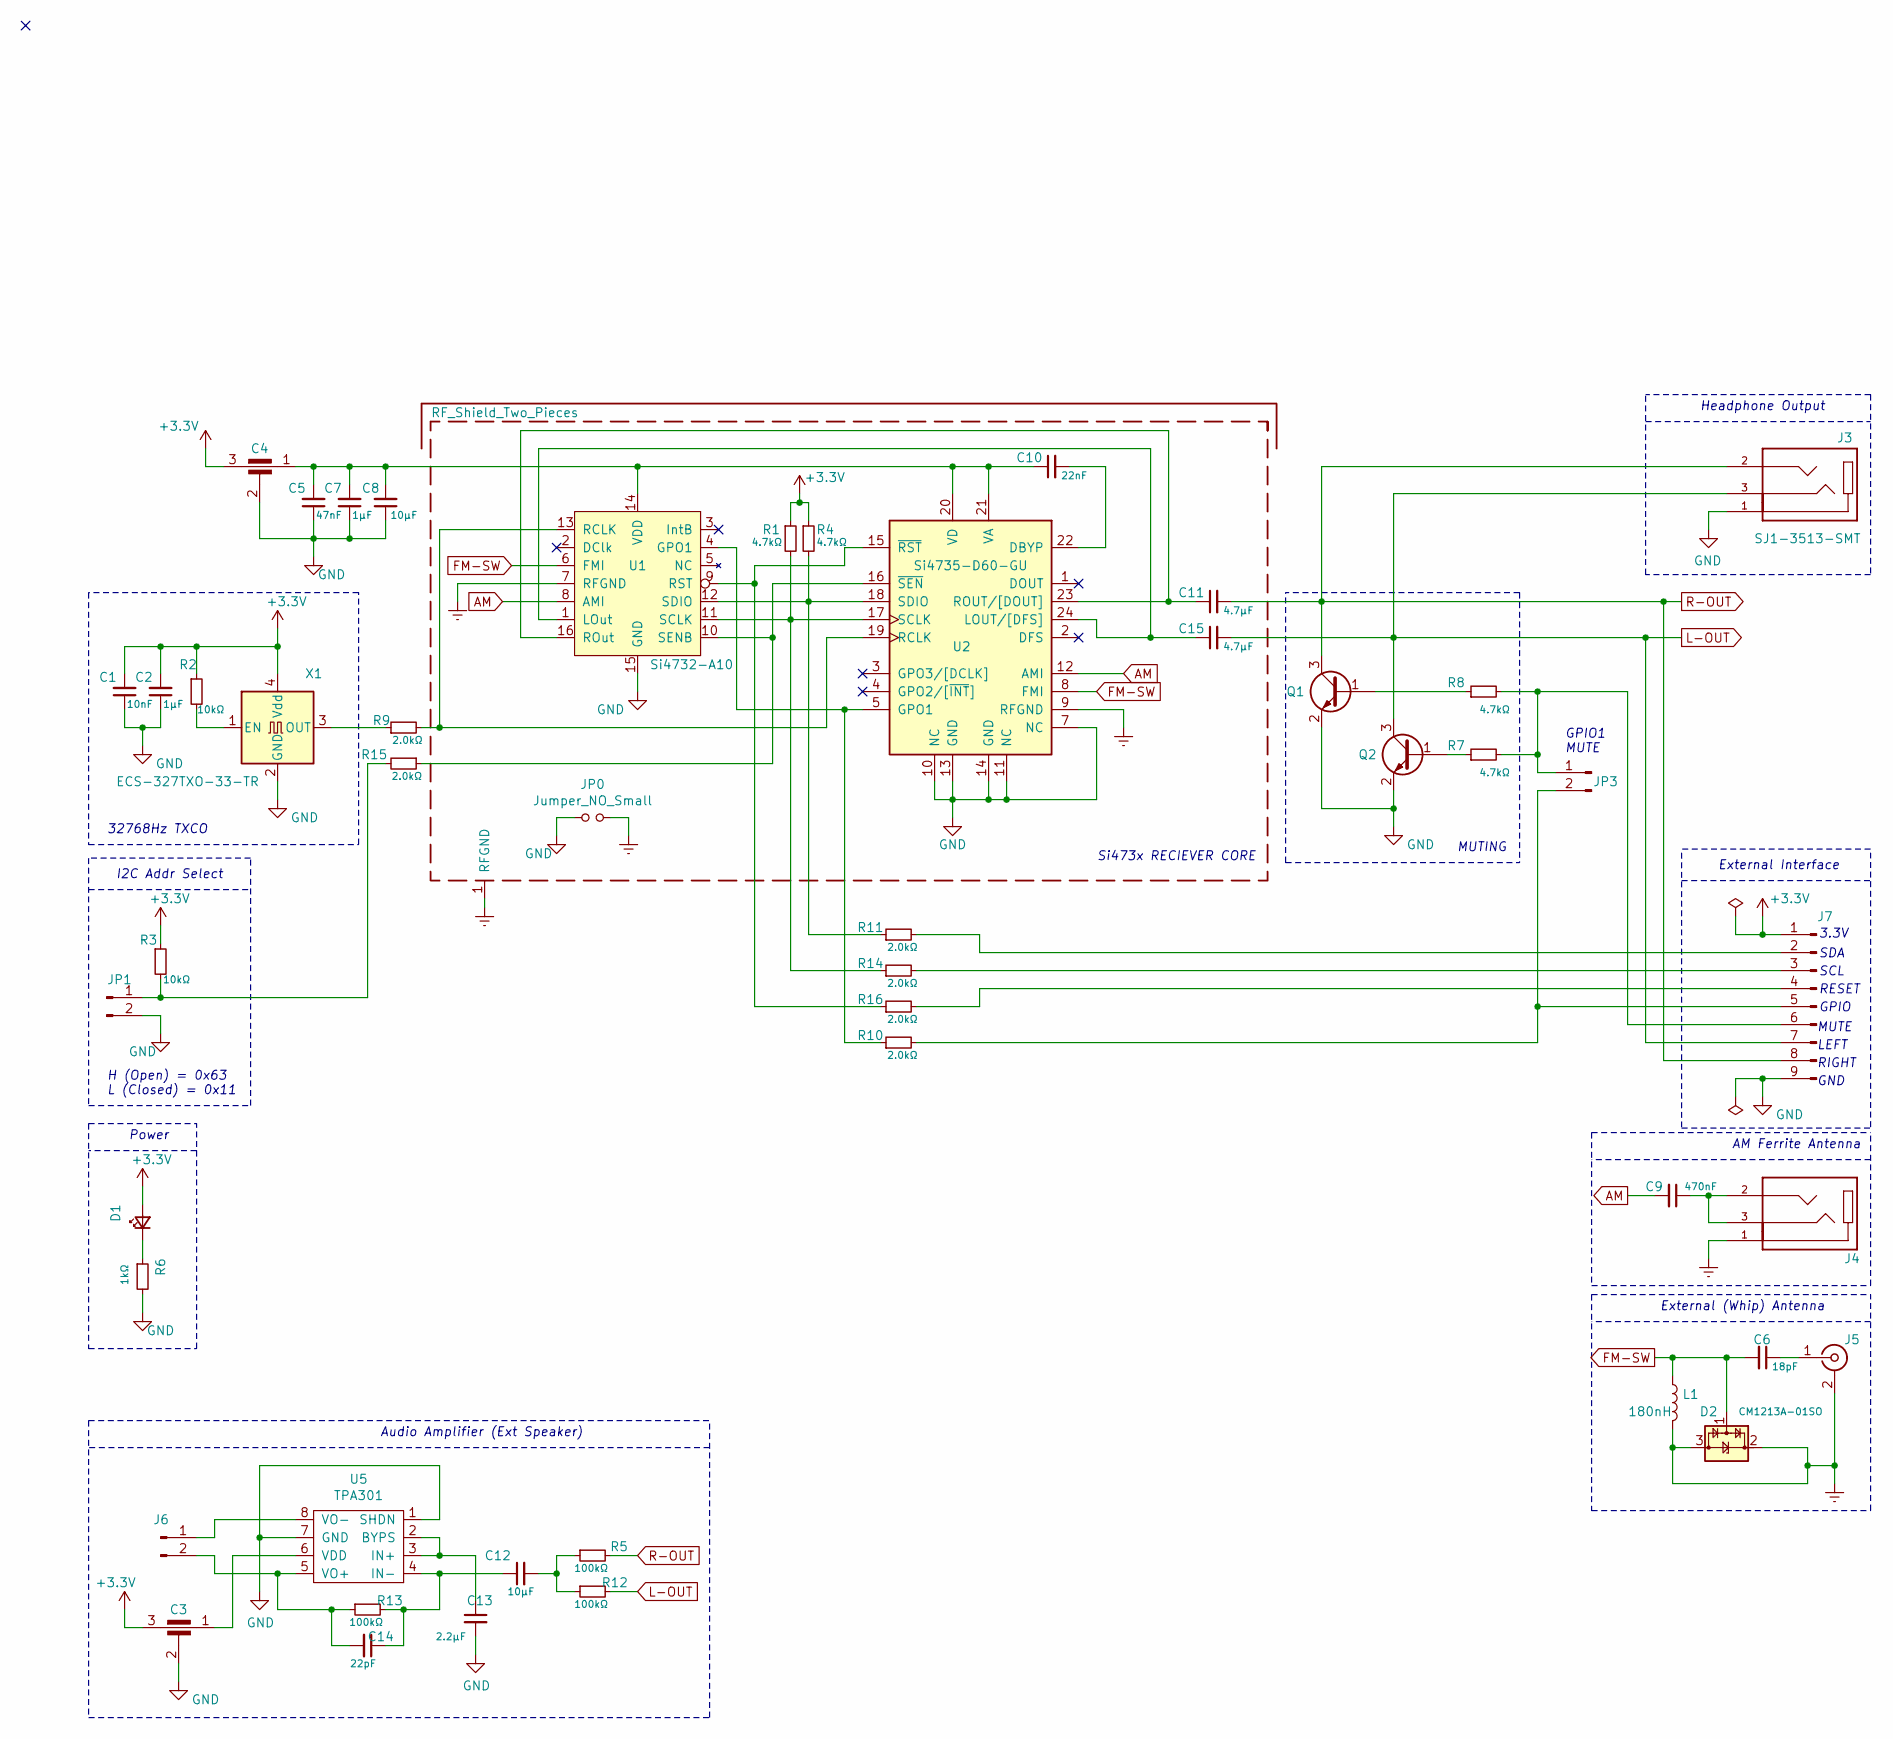
[picture p77: schematic MBRadio_4732_BO3.sch, Si4732 BO]

Parts:
C1: 10nF; C_0402_1005Metric
C2: 1µF; C_0402_1005Metric
C3, C4: EMI_Filter_C; NFM21PS106B0J3D
C5: 47nF; C_0402_1005Metric
C6: 18pF; C_0402_1005Metric
C7: 1µF; C_0603_1608Metric
C8, C12: 10µF; C_0603_1608Metric
C9: 470nF; C_0603_1608Metric
C10: 22nF; C_0603_1608Metric
C11, C15: 4.7µF; C_0603_1608Metric
C13: 2.2µF; C_0603_1608Metric
C14: 22pF; C_0402_1005Metric
D1: LED_Small; LED_0603_1608Metric_Castellated
D2: CM1213A-01SO; SOT-23
J3, J4: SJ1-3513-SMT; CUI_SJ1-3513-SMT
J5: Conn_01x01_Female; SMA_Molex_73251-1153_EdgeMount_Horizontal
J6: Conn_01x02_Male; TE_1776275-2
J7: Conn_01x09_Male; PinHeader_1x09_P2.54mm_Vertical
JP0: Jumper_NO_Small; SolderJumper-2_P1.3mm_Open_TrianglePad1.0x1.5mm
JP1, JP3: Conn_01x02_Male; PinHeader_1x02_P2.00mm_Vertical
L1: 180nH; L_0603_1608Metric
Q1, Q2: Q_NPN_BEC; SOT-23
R1, R4, R7, R8: 4.7kΩ; R_0603_1608Metric
R2, R3: 10kΩ; R_0603_1608Metric
R5, R12, R13: 100kΩ; R_0603_1608Metric
R6: 1kΩ; R_0603_1608Metric
R9, R10, R11, R14, R15, R16: 2.0kΩ; R_0603_1608Metric
SH1: RF_Shield_Two_Pieces; Laird_Technologies_BMI-S-203-F_26.21x26.21mm
U1: Si4732-A10; SOIC-16_3.9x9.9mm_P1.27mm
U2: Si4735-D60-GU; SSOP-24_3.9x8.7mm_P0.635mm
U5: TPA301; SOIC-8_3.9x4.9mm_P1.27mm
X1: ECS-327TXO-33-TR; Oscillator_SMD_Abracon_ASE-4Pin_3.2x2.5mm

Connections:
+3V3: C1.2, C2.2, C3.3, C4.3, D1.2 (A), J7.1, R1.1, R2.1, R3.1, R4.1, X1.4 (Vdd)
AM: C9.2, U1.8 (AMI), U2.12 (AMI)
Earth: D2.2 (VP), D2.3 (VN), J4.1, J5.2 (Ext), JP0.2, L1.2, SH1.1, U1.7 (RFGND), U2.9 (RFGND)
FM-SW: C6.2, D2.1 (CH1), L1.1, U1.6 (FMI), U2.8 (FMI)
GND: C1.1, C2.1, C3.2, C4.2, C5.1, C7.1, C8.1, C13.2, J3.1, J7.9, JP0.1, JP1.2, Q1.2 (E), Q2.2 (E), R6.2, U1.15 (GND), U2.7 (NC), U2.10 (NC), U2.11 (NC), U2.13 (GND), U2.14 (GND), U5.1 (SHDN), U5.7 (GND), X1.2 (GND)
L-OUT: C15.2, J3.3, J7.7, Q2.3 (C), R12.2
unnamed: C3.1, U5.6 (VDD)
unnamed: C6.1, J5.1 (In)
unnamed: C9.1, J4.2, J4.3
unnamed: C4.1, C5.2, C7.2, C8.2, C10.1, U1.14 (VDD), U2.20 (VD), U2.21 (VA)
unnamed: C10.2, U2.22 (DBYP)
unnamed: C11.1, U1.16 (ROut), U2.23 (ROUT/[DOUT])
unnamed: C12.1, C14.1, R13.2, U5.4 (IN-)
unnamed: C12.2, R5.1, R12.1
unnamed: C13.1, U5.2 (BYPS), U5.3 (IN+)
unnamed: C14.2, J6.2, R13.1, U5.5 (VO+)
unnamed: C15.1, U1.1 (LOut), U2.24 (LOUT/[DFS])
unnamed: D1.1 (K), R6.1
unnamed: J6.1, U5.8 (VO-)
unnamed: J7.2, R11.2
unnamed: J7.3, R14.2
unnamed: J7.4, R16.2
unnamed: J7.5, JP3.2, R10.2
unnamed: J7.6, JP3.1, R7.2, R8.2
unnamed: JP1.1, R3.2, R15.2
unnamed: Q1.1 (B), R8.1
unnamed: Q2.1 (B), R7.1
unnamed: R1.2, R14.1, U1.11 (SCLK), U2.17 (SCLK)
unnamed: R2.2, X1.1 (EN)
unnamed: R9.1, X1.3 (OUT)
unnamed: R9.2, U1.13 (RCLK), U2.19 (RCLK)
unnamed: R10.1, U1.4 (GPO1), U2.5 (GPO1)
unnamed: R4.2, R11.1, U1.12 (SDIO), U2.18 (SDIO)
unnamed: R15.1, U1.10 (SENB), U2.16 (~SEN)
unnamed: R16.1, U1.9 (RST), U2.15 (~RST)
R-OUT: C11.2, J3.2, J7.8, Q1.3 (C), R5.2

Notes on the sheet:
H (Open) = 0x63 L (Closed) = 0x11
Headphone Output
I2C Addr Select
Audio Amplifier (Ext Speaker)
External (Whip) Antenna
AM Ferrite Antenna
GPIO
RESET
External Interface
GND
3.3V
SDA
SCL
Si473x RECIEVER CORE
32768Hz TXCO
MUTING
GPIO1 MUTE
MUTE
RIGHT
LEFT
Power

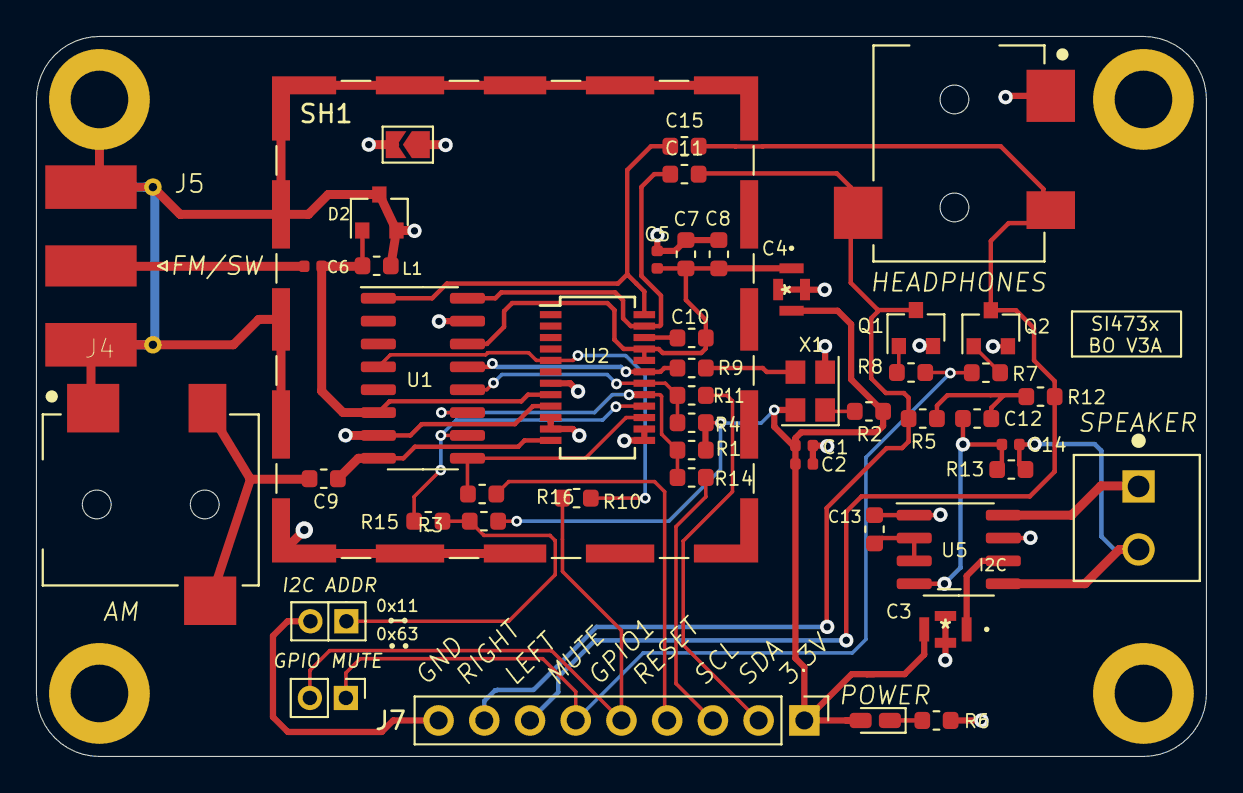
[picture p78: board MBRadio_4732_BO3.kicad_pcb from above]

Board: 2 copper layers, 65.0 x 40.0 mm, 49 parts (0 on the bottom side), 36 nets.
