LadyRoninEngineer/Si473x/FrontEnd/MBFrontEnd.kicad_pcb

## KiCad design FrontEnd/MBFrontEnd.kicad_pcb (2021-02-23)

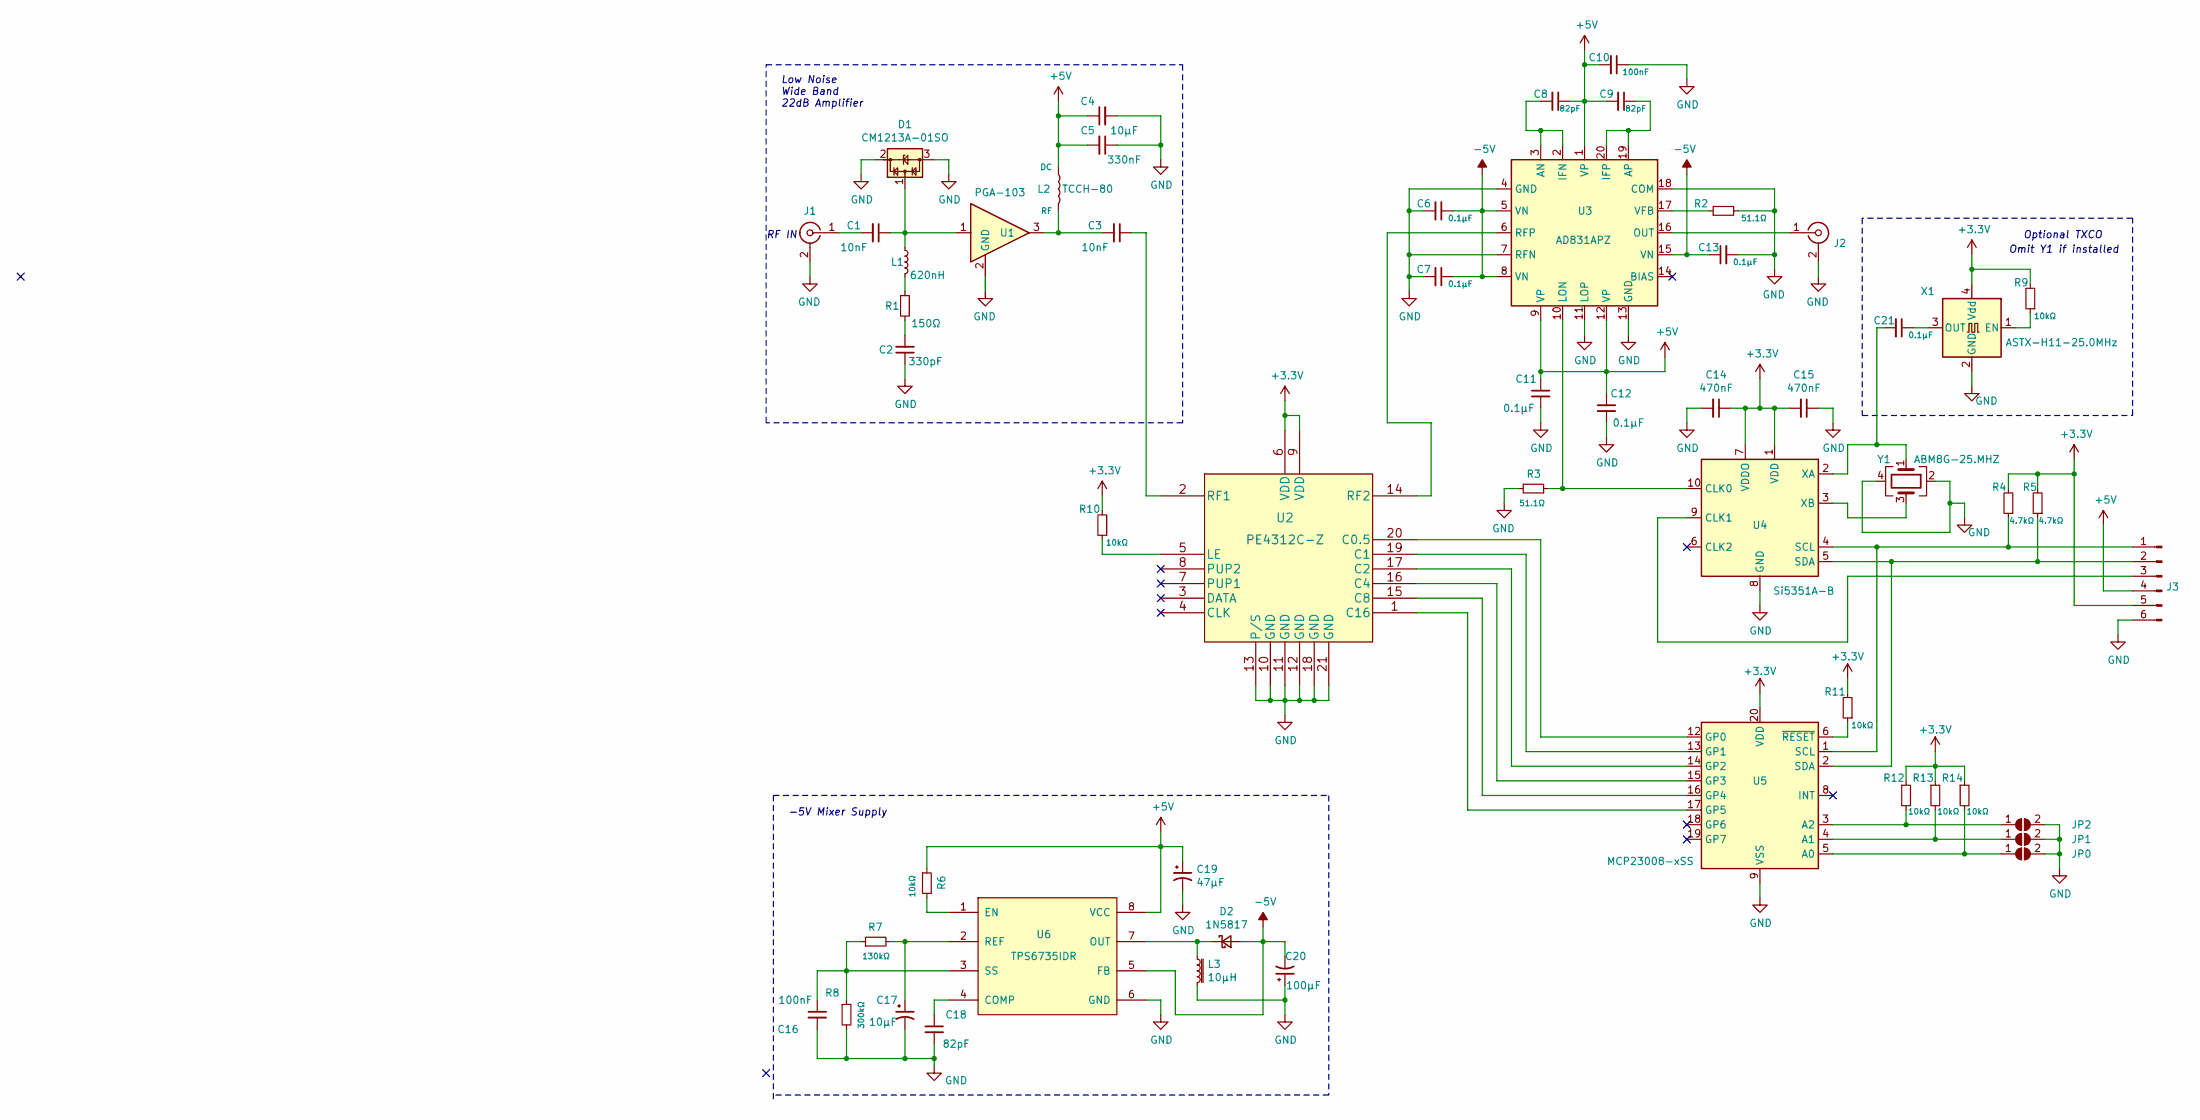
[picture p79: schematic MBFrontEnd.sch, LNA, Mixer and LO VHF Front End]

Parts:
C1, C3: 10nF; C_0805_2012Metric
C2: 330pF; C_0603_1608Metric
C4: 10µF; C_1206_3216Metric
C5: 330nF; C_0402_1005Metric
C6, C7, C11, C12, C13, C21: 0.1µF; C_0603_1608Metric
C8, C9, C18: 82pF; C_0402_1005Metric
C10: 100nF; C_0603_1608Metric
C14, C15: 470nF; C_0402_1005Metric
C16: 100nF; C_0402_1005Metric
C17: 10µF; CP_EIA-3528-21_Kemet-B
C19: 47µF; CP_EIA-7343-30_AVX-N
C20: 100µF; CP_EIA-7343-30_AVX-N
D1: CM1213A-01SO; SOT-23
D2: 1N5817; D_SOD-323
J1, J2: Conn_Coaxial; SMA_Molex_73251-1153_EdgeMount_Horizontal
J3: Conn_01x06_Male; PinHeader_1x06_P2.54mm_Horizontal
JP0, JP1, JP2: SolderJumper_2_Open; SolderJumper-2_P1.3mm_Open_TrianglePad1.0x1.5mm
L1: 620nH; L_1008_2520Metric
L2: TCCH-80; GU1604
L3: 10µH; CD54NP-220MC
R1: 150Ω; R_0603_1608Metric
R2, R3: 51.1Ω; R_0603_1608Metric
R4, R5: 4.7kΩ; R_0402_1005Metric
R6, R9, R10, R11, R12, R13, R14: 10kΩ; R_0402_1005Metric
R7: 130kΩ; R_0402_1005Metric
R8: 300kΩ; R_0402_1005Metric
U1: PGA-103; SOT-89-3
U2: PE4312C-Z; QFN-20-1EP_4x4mm_P0.5mm_EP2.6x2.6mm
U3: AD831APZ; PLCC-20
U4: Si5351A-B; MSOP-10_3x3mm_P0.5mm
U5: MCP23008-xSS; SSOP-20_5.3x7.2mm_P0.65mm
U6: TPS6735IDR; SOIC-8_3.9x4.9mm_P1.27mm
X1: ASTX-H11-25.0MHz; Oscillator_SMD_Abracon_ASE-4Pin_3.2x2.5mm
Y1: ABM8G-25.MHZ; Crystal_SMD_Abracon_ABM8G-4Pin_3.2x2.5mm

Connections:
+3V3: C14.1, C15.2, J3.5, R4.2, R5.2, R9.2, R10.2, R11.2, R12.1, R13.1, R14.1, U2.6 (VDD), U2.9 (VDD), U4.1 (VDD), U4.7 (VDDO), U5.20 (VDD), X1.4 (Vdd)
+5V: C4.1, C5.2, C8.1, C9.2, C10.2, C11.1, C12.1, C19.1, J3.4, L2.P$3 (DC), R6.1, U3.1 (VP), U3.9 (VP), U3.12 (VP), U6.8 (VCC)
-5V: C6.1, C7.1, C13.1, C20.2, D2.2 (A), U3.5 (VN), U3.8 (VN), U3.15 (VN), U6.5 (FB)
GND: C2.1, C4.2, C5.1, C6.2, C7.2, C10.1, C11.2, C12.2, C13.2, C14.2, C15.1, C16.2, C17.2, C18.2, C19.2, C20.1, D1.2 (VP), D1.3 (VN), J1.2 (Ext), J2.2 (Ext), J3.6, JP0.2 (B), JP1.2 (B), JP2.2 (B), L3.2, R2.2, R3.2, R8.2, U1.2 (GND), U2.10 (GND), U2.11 (GND), U2.12 (GND), U2.13 (P/S), U2.18 (GND), U2.21 (GND), U3.4 (GND), U3.7 (RFN), U3.11 (LOP), U3.13 (GND), U3.18 (COM), U4.8 (GND), U5.9 (VSS), U6.6 (GND), X1.2 (GND), Y1.2, Y1.4; also elsewhere on the board
unnamed: C1.1, D1.1 (CH1), L1.1, U1.1
unnamed: C1.2, J1.1 (In)
unnamed: C2.2, R1.2
unnamed: C3.1, U2.2 (RF1)
unnamed: C3.2, L2.P$1 (RF), U1.3
unnamed: C8.2, U3.2 (IFN), U3.3 (AN)
unnamed: C9.1, U3.19 (AP), U3.20 (IFP)
unnamed: C16.1, R7.1, R8.1, U6.3 (SS)
unnamed: C17.1, R7.2, U6.2 (REF)
unnamed: C18.1, U6.4 (COMP)
unnamed: C21.1, X1.3 (OUT)
unnamed: C21.2, U4.2 (XA), Y1.1
unnamed: D2.1 (K), L3.1, U6.7 (OUT)
unnamed: J2.1 (In), U3.16 (OUT)
unnamed: J3.1, R4.1, U4.4 (SCL), U5.1 (SCL)
unnamed: J3.2, R5.1, U4.5 (SDA), U5.2 (SDA)
unnamed: J3.3, U4.9 (CLK1)
unnamed 21: JP0.1 (A), R14.2, U5.5 (A0); also elsewhere on the board
unnamed 22: JP1.1 (A), R13.2, U5.4 (A1); also elsewhere on the board
unnamed 23: JP2.1 (A), R12.2, U5.3 (A2); also elsewhere on the board
unnamed: L1.2, R1.1
unnamed: R2.1, U3.17 (VFB)
unnamed: R3.1, U3.10 (LON), U4.10 (CLK0)
unnamed: R6.2, U6.1 (EN)
unnamed: R9.1, X1.1 (EN)
unnamed: R10.1, U2.5 (LE)
unnamed: R11.1, U5.6 (~RESET)
unnamed: U2.1 (C16), U5.17 (GP5)
unnamed: U2.14 (RF2), U3.6 (RFP)
unnamed: U2.15 (C8), U5.16 (GP4)
unnamed: U2.16 (C4), U5.15 (GP3)
unnamed: U2.17 (C2), U5.14 (GP2)
unnamed: U2.19 (C1), U5.13 (GP1)
unnamed: U2.20 (C0.5), U5.12 (GP0)
unnamed: U4.3 (XB), Y1.3

Notes on the sheet:
-5V Mixer Supply
RF IN
Low Noise Wide Band 22dB Amplifier
Optional TXCO
Omit Y1 if installed

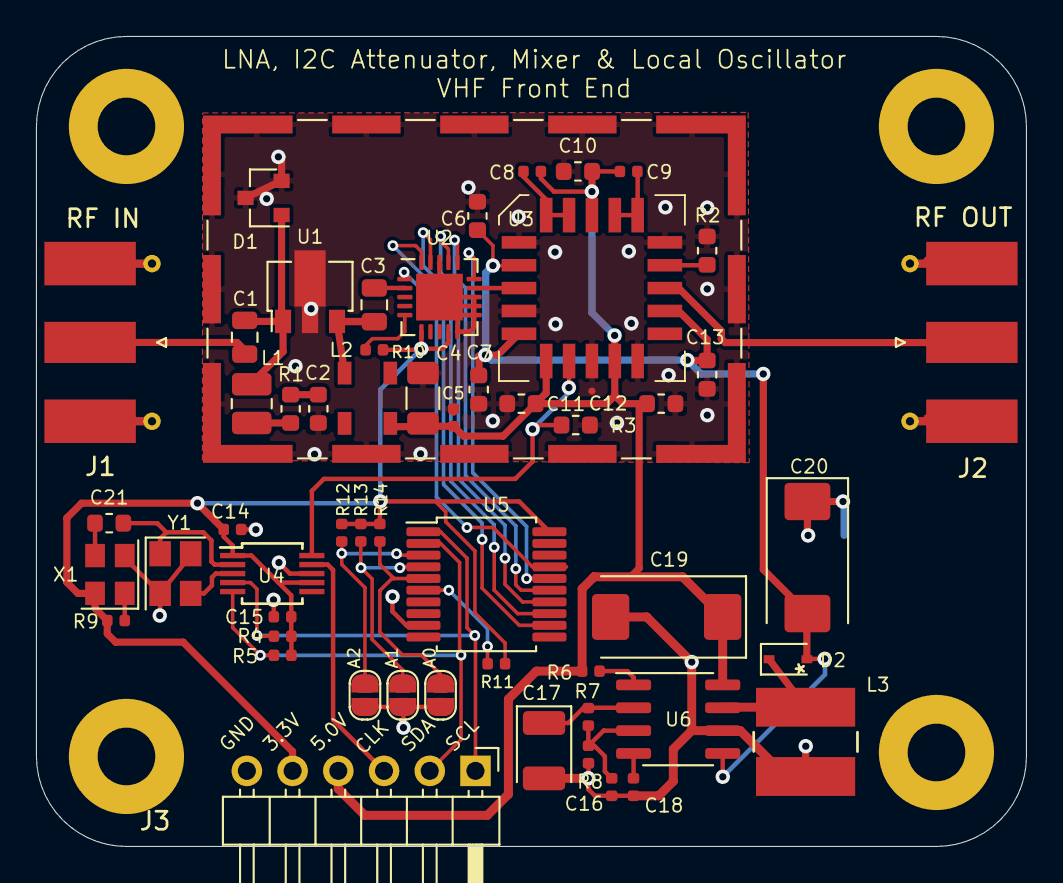
[picture p80: board MBFrontEnd.kicad_pcb from above]

Board: 2 copper layers, 55.0 x 45.0 mm, 54 parts (0 on the bottom side), 39 nets.

Other parts of the board:
A0, A1, A2: SolderJumper-2_P1.3mm_Open_RoundedPad1.0x1.5mm

Their connections:
GND: A0.2, A1.2, A2.2; also elsewhere on the board
unnamed 21: A0.1; also elsewhere on the board
unnamed 22: A1.1; also elsewhere on the board
unnamed 23: A2.1; also elsewhere on the board
