LadyRoninEngineer/Si473x/DualEncoder/MBRadioPanel.kicad_pcb

## KiCad design DualEncoder/MBRadioPanel.kicad_pcb (2020-11-09)

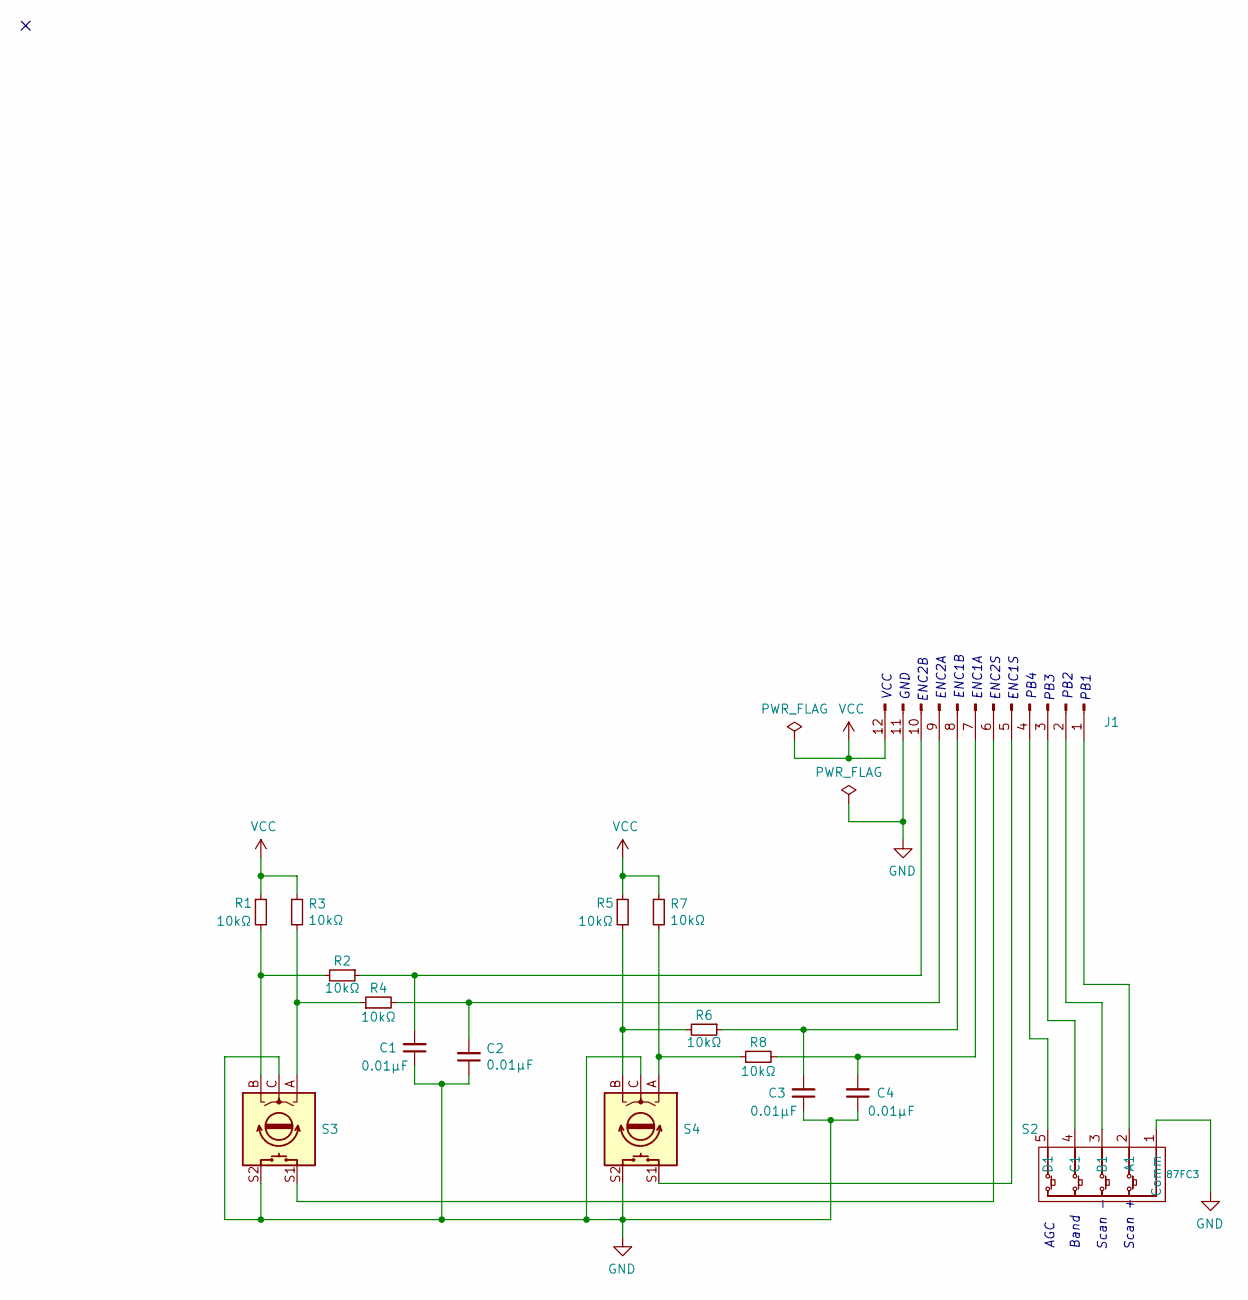
[picture p81: schematic MBRadioPanel.sch, Micro All Band Radio]

Parts:
C1, C2, C3, C4: 0.01µF; C_0402_1005Metric
J1: Conn_01x12_Male; PinHeader_1x12_P2.54mm_Vertical
R1, R2, R3, R4, R5, R6, R7, R8: 10kΩ; R_0402_1005Metric
S2: 87FC3
S3, S4: Rotary_Encoder_Switch; RotaryEncoder_Alps_EC11E-Switch_Vertical_H20mm

Connections:
GND: C1.1, C2.1, C3.1, C4.1, J1.11, S2.1 (Comm), S3.C, S3.S2, S4.C, S4.S2
unnamed: C1.2, J1.10, R2.1
unnamed: C2.2, J1.9, R4.2
unnamed: C3.2, J1.8, R6.1
unnamed: C4.2, J1.7, R8.2
unnamed: J1.1, S2.2 (A1)
unnamed: J1.2, S2.3 (B1)
unnamed: J1.3, S2.4 (C1)
unnamed: J1.4, S2.5 (D1)
unnamed: J1.5, S4.S1
unnamed: J1.6, S3.S1
unnamed: R1.2, R2.2, S3.B
unnamed: R3.2, R4.1, S3.A
unnamed: R5.2, R6.2, S4.B
unnamed: R7.2, R8.1, S4.A
VCC: J1.12, R1.1, R3.1, R5.1, R7.1

Notes on the sheet:
AGC
Band
Scan -
Scan +
ENC2B
ENC2A
ENC1B
ENC1A
ENC2S
ENC1S
PB4
PB3
GND
PB2
PB1
VCC

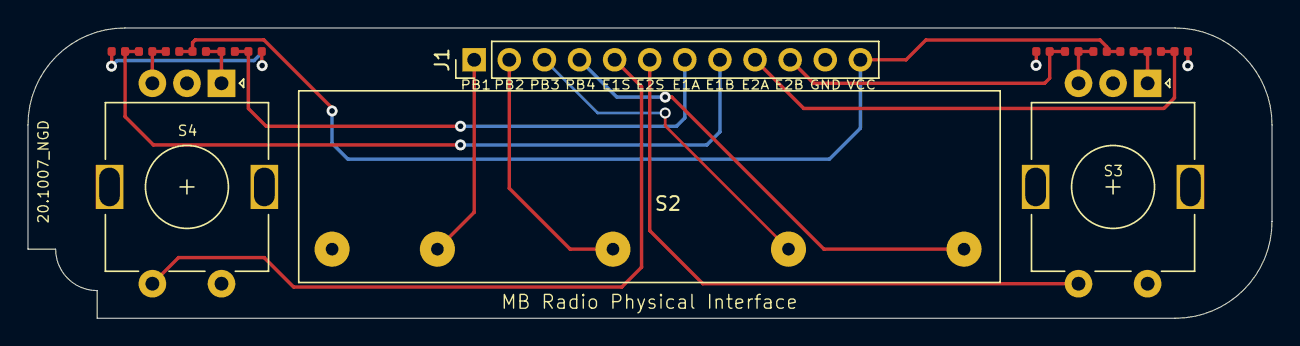
[picture p82: board MBRadioPanel.kicad_pcb from above]

Board: 2 copper layers, 90.0 x 21.0 mm, 16 parts (0 on the bottom side), 16 nets.
