LadyRoninEngineer/Si473x/(commit log)

2020-11-09 Create Gerbers
2022-02-08 Multiband Radio V4 Schematics
2022-02-10 MBR Bill of Materials
