LadyRoninEngineer/Si473x/(notices)

Notices in the files:
FrontEnd/Custom Library/3D_MODELS/142-0701-851SMA.stp:
FILE_NAME( 'C:/Users/KMIROS~1/AppData/Local/Temp/psolqas_1980_0.stp', '2020-08-18T10:52:41', ( 'License CC BY-ND 4.0' ), ( 'CADENAS' ), ' ', 'PARTsolutions', ' ' );
Si4732THT/KiCAD_Controller/Custom Library/D6R00F1LFS/D6R00F1LFS.stp:
author */ ('License CC BY-ND 4.0'),
parts and their libraries:
Copyright 2021 Accelerated Designs. All rights reserved.
Copyright 2016 Accelerated Designs. All rights reserved.
